clydeshaffer/gametank/media/gametank-angle-01.png

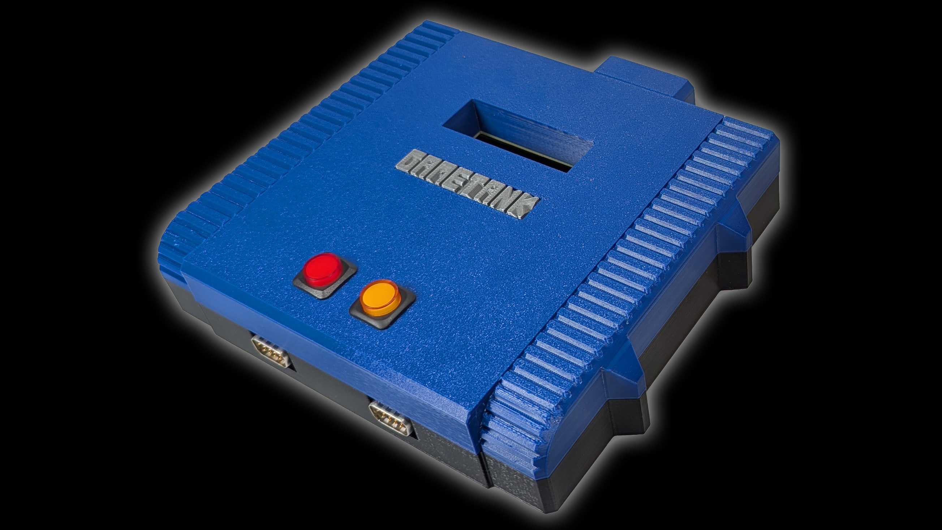
media/gametank-angle-01.png
