clydeshaffer/gametank/Docs/PackagingLabels/PackagingV2/box_left.png

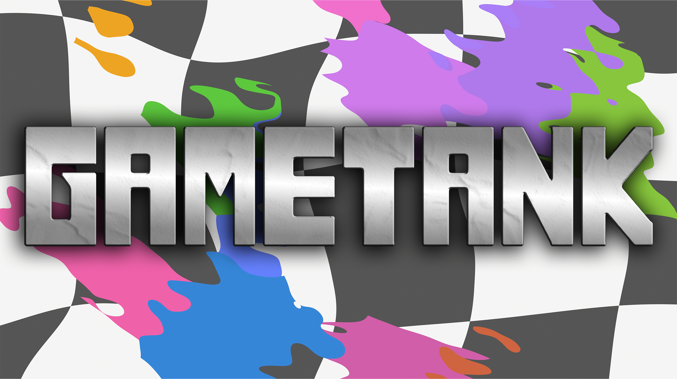
Docs/PackagingLabels/PackagingV2/box_left.png
