clydeshaffer/gametank/Docs/SchematicPDFs/readme.md

## Main System Schematics
- cpu-blitter-inputs.pdf
- signals.pdf
- powermodule-lm2575.pdf

## Controller
- gpad1.pdf

## Cartridges
- FlashCardBanked2M.pdf (bigger capacity)
- EEPROM32card.pdf (can be entirely through-hole)
- MegaProgrammer.pdf - Arduino-based USB flasher tool
