clydeshaffer/gametank/Docs/SchematicImages/README.md

### GameTank Prototype3 schematics in image form for viewing without EAGLE

- core.png - CPU, main RAM, and address decoding
- blitter.png - Sprite copying machine
- inputs.png - controller ports and input registers
- video.png - Composite video generator circuit and framebuffer RAM
- audio-coprocessor.png - second 6502 controlling a DAC
- audio-port.png - shows the names of audio connector signals on the mainboard side
- oscillator.png - main system clock
