clydeshaffer/gametank/Docs/PackagingLabels/front_back.pdf

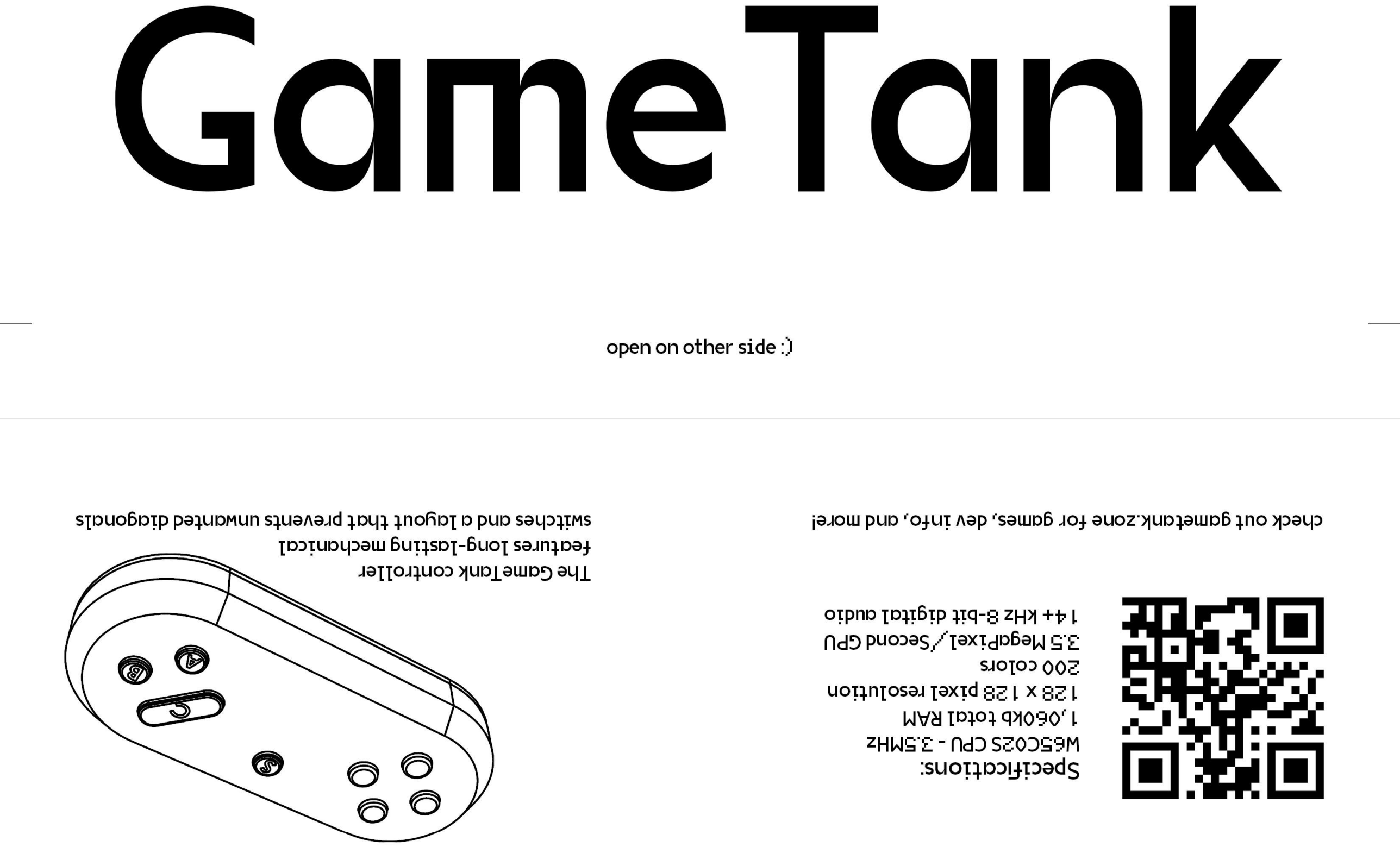
[picture p19: page 1]
