clydeshaffer/gametank/Docs/PackagingLabels/top.pdf

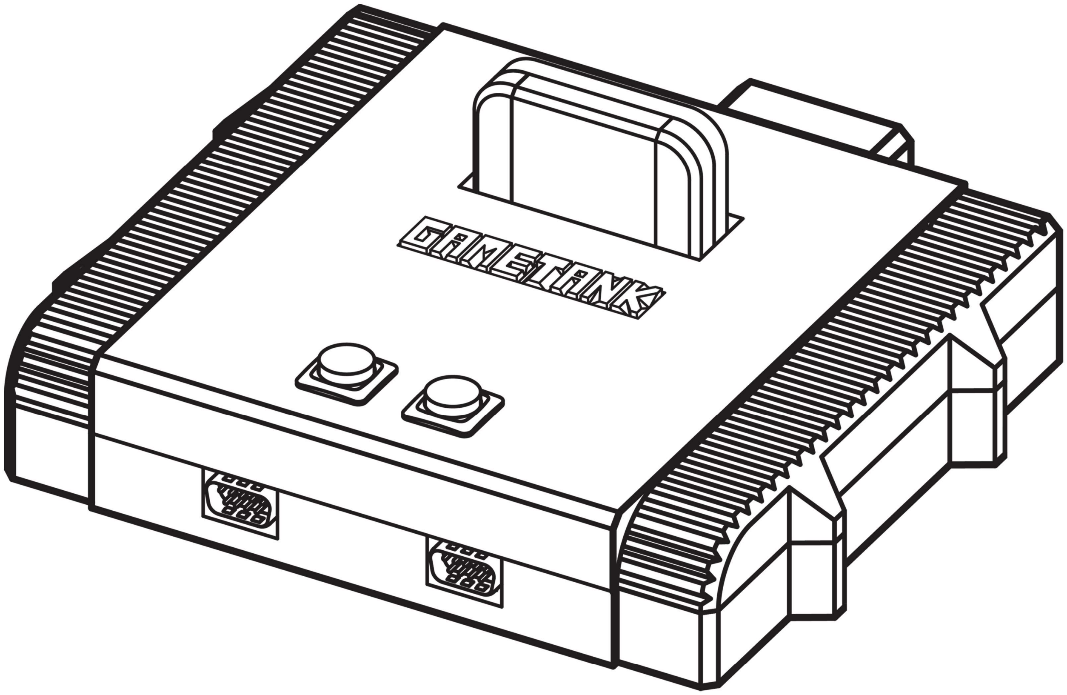
[picture p20: page 1]
