clydeshaffer/gametank/CAD/proto-v3-sketch.png

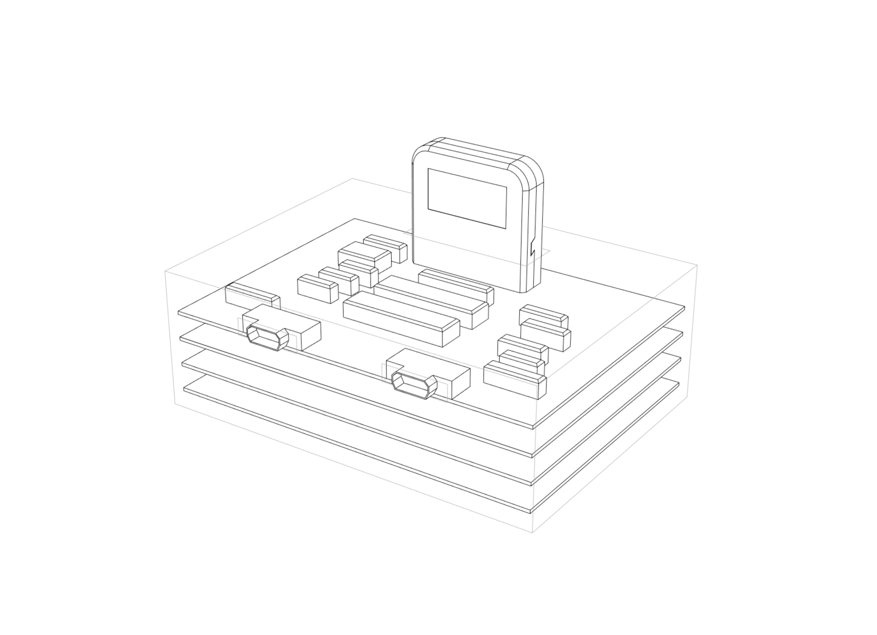
CAD/proto-v3-sketch.png
