clydeshaffer/gametank/Docs/PackagingLabels/PackagingV2/box_bottom.png

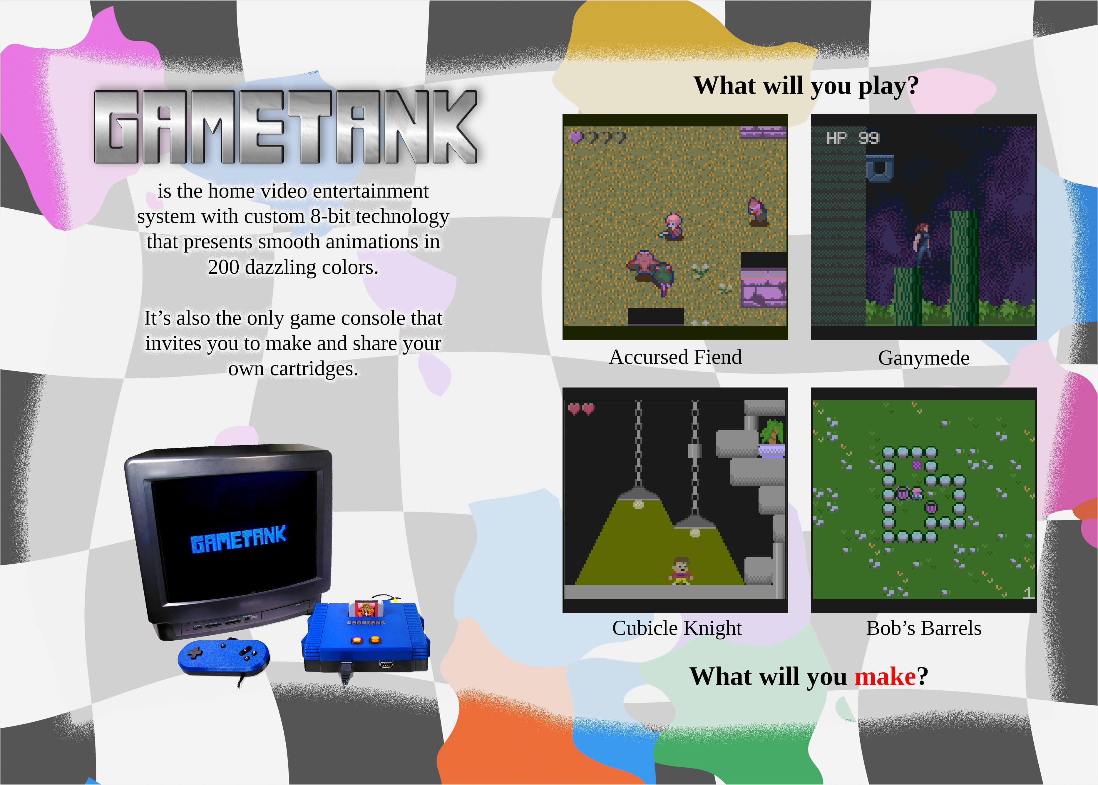
Docs/PackagingLabels/PackagingV2/box_bottom.png
