clydeshaffer/gametank/Docs/PackagingLabels/PackagingV2/box_bottom_layer.png

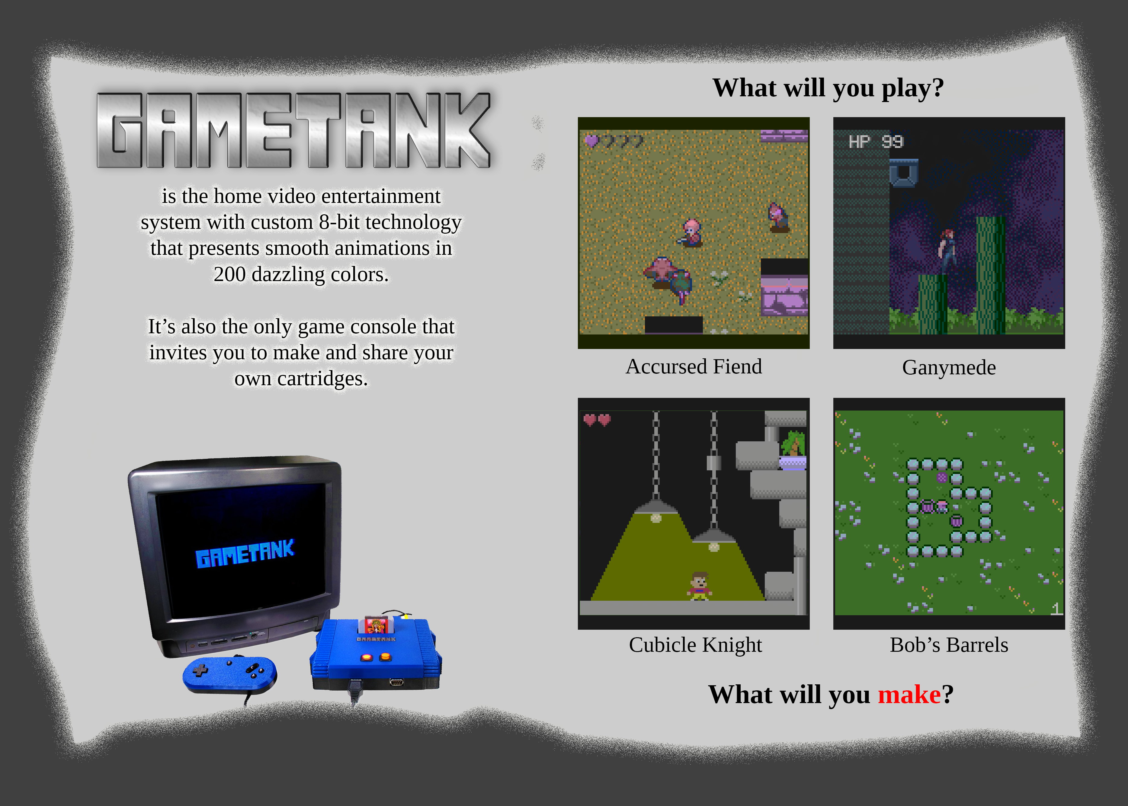
Docs/PackagingLabels/PackagingV2/box_bottom_layer.png
