clydeshaffer/gametank/Docs/PackagingLabels/PackagingV2/box_front_layer.png

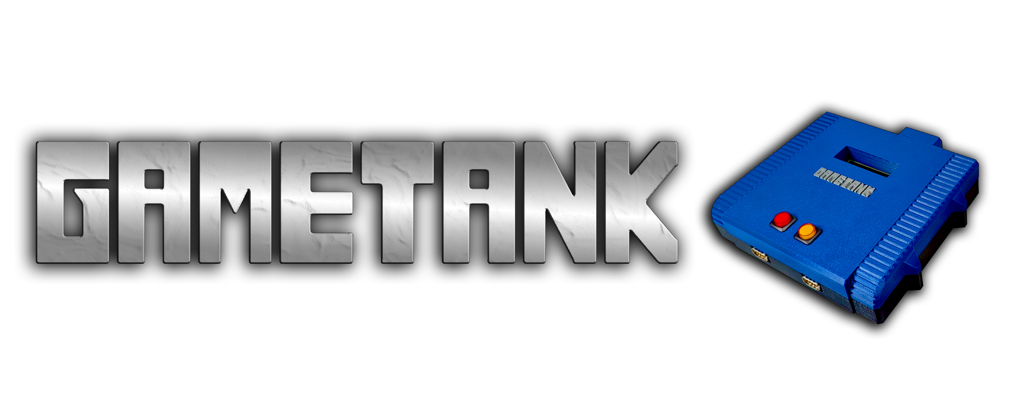
Docs/PackagingLabels/PackagingV2/box_front_layer.png
