clydeshaffer/gametank/Docs/PackagingLabels/PackagingV2/box_left_bg.png

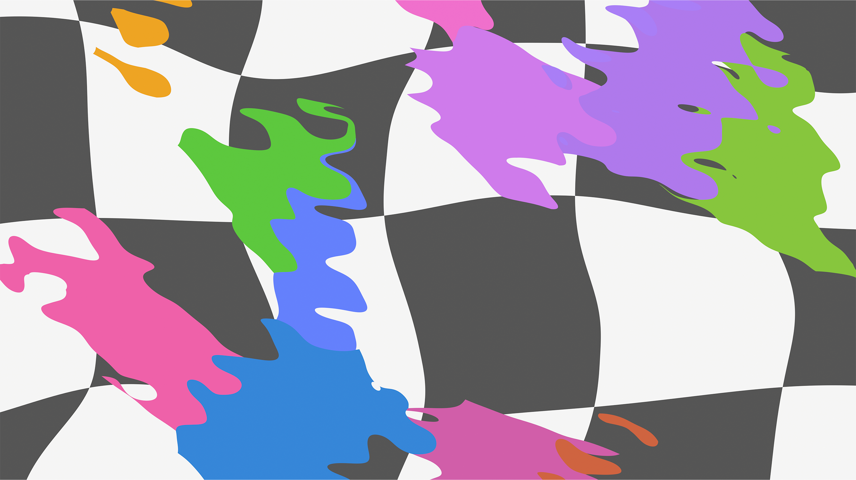
Docs/PackagingLabels/PackagingV2/box_left_bg.png
