clydeshaffer/gametank/Docs/PackagingLabels/PackagingV2/box_right.png

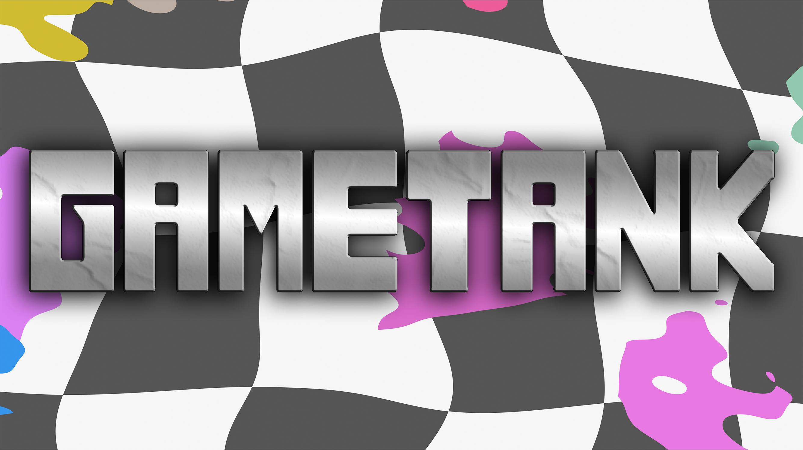
Docs/PackagingLabels/PackagingV2/box_right.png
