clydeshaffer/gametank/Docs/PackagingLabels/PackagingV2/box_right_bg.png

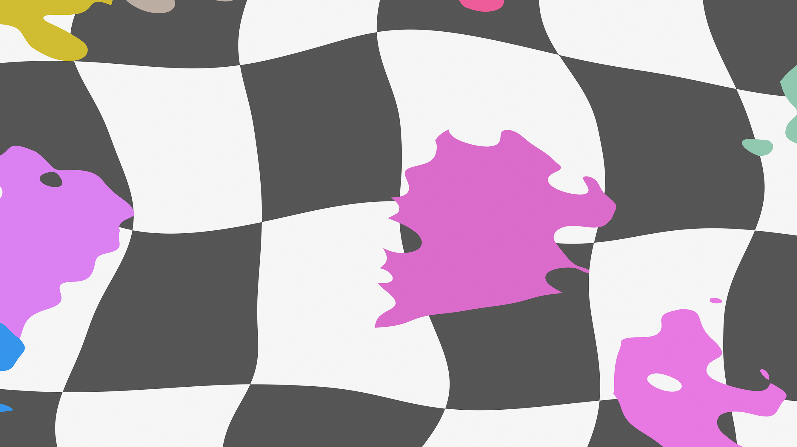
Docs/PackagingLabels/PackagingV2/box_right_bg.png
