clydeshaffer/gametank/Docs/PackagingLabels/PackagingV2/box_side_layer.png

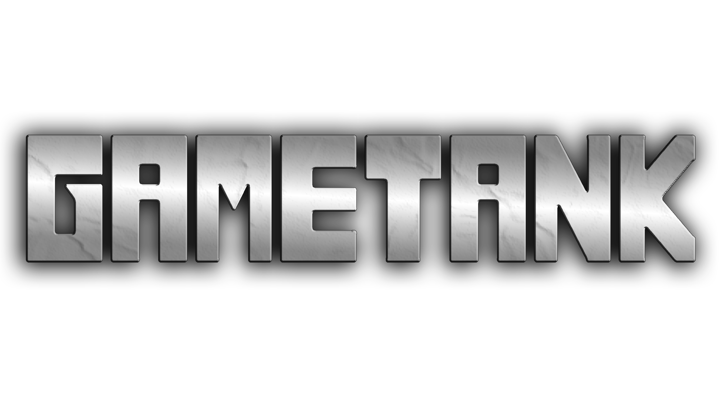
Docs/PackagingLabels/PackagingV2/box_side_layer.png
