clydeshaffer/gametank/Docs/SchematicImages/audio-coprocessor.png

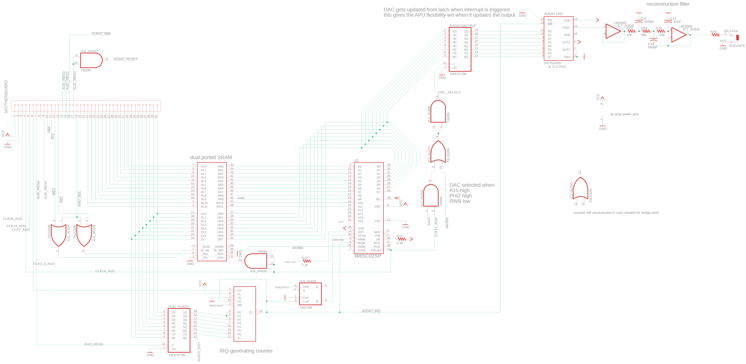
Docs/SchematicImages/audio-coprocessor.png
