clydeshaffer/gametank/Docs/SchematicImages/audioport.png

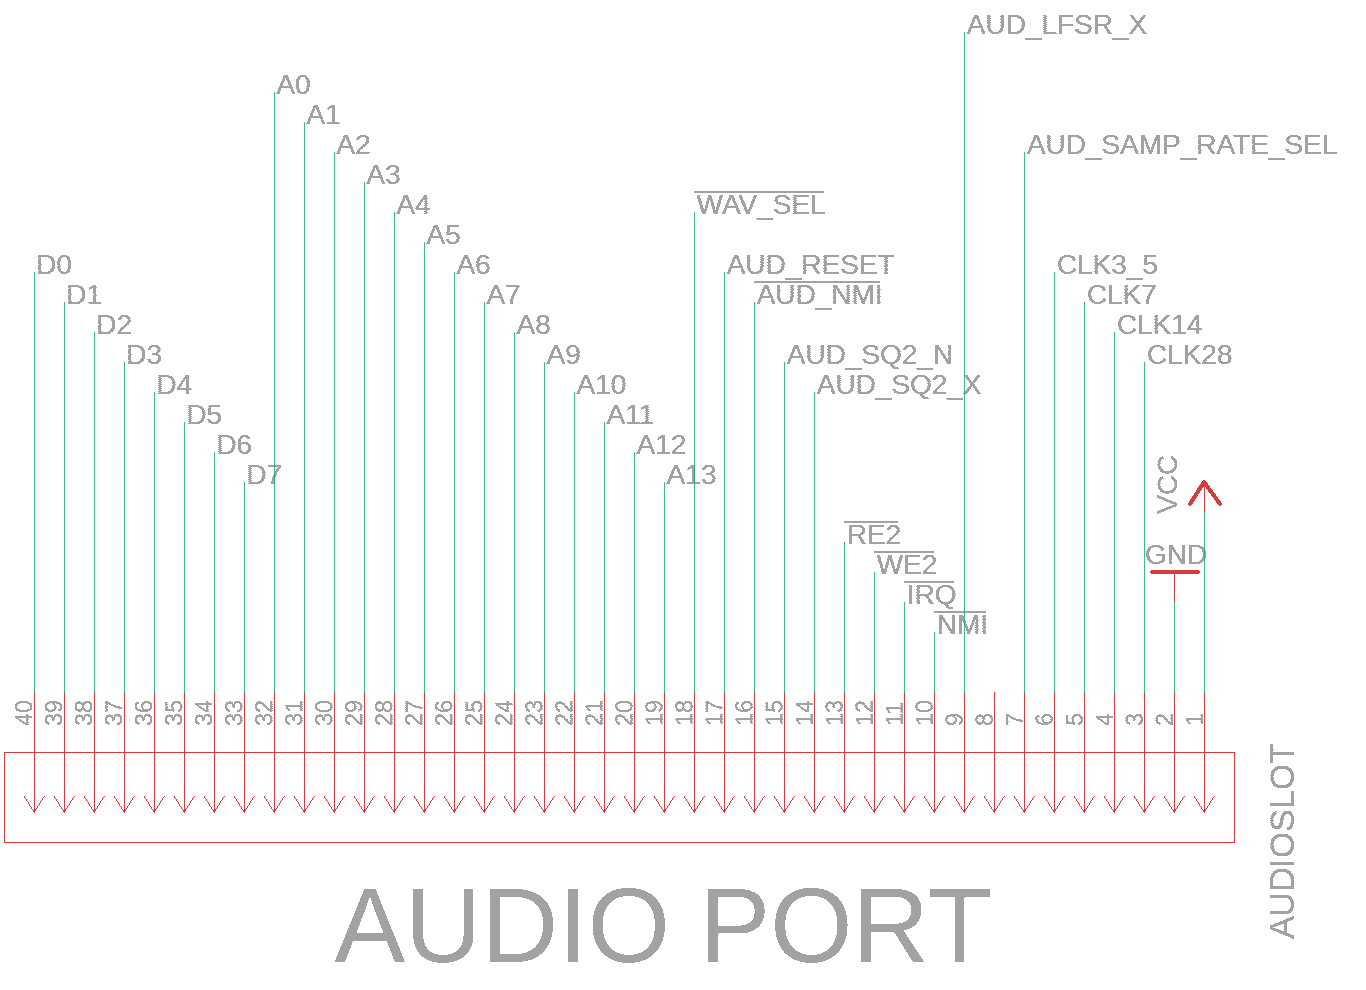
Docs/SchematicImages/audioport.png
