clydeshaffer/gametank/Docs/SchematicImages/core.png

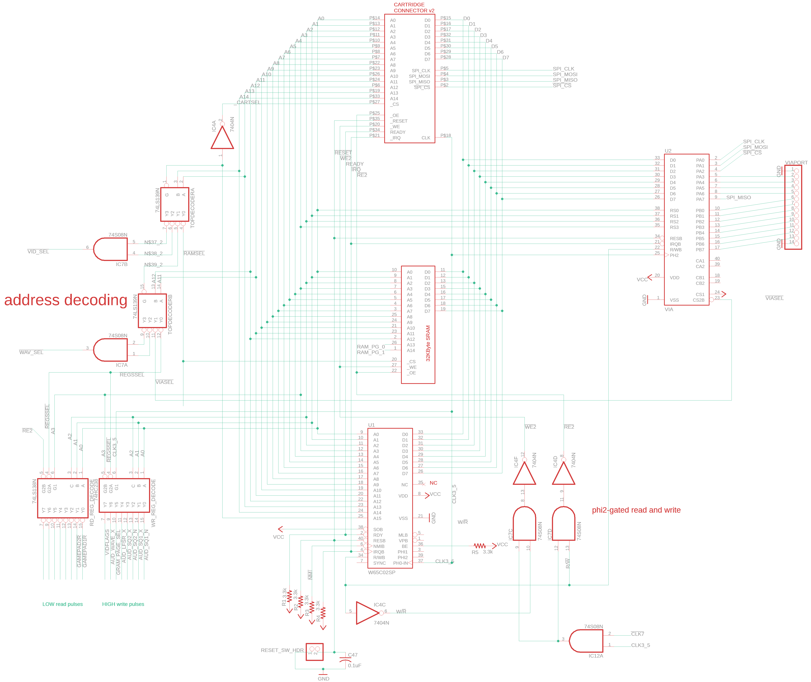
Docs/SchematicImages/core.png
