clydeshaffer/gametank/Docs/SchematicImages/inputs.png

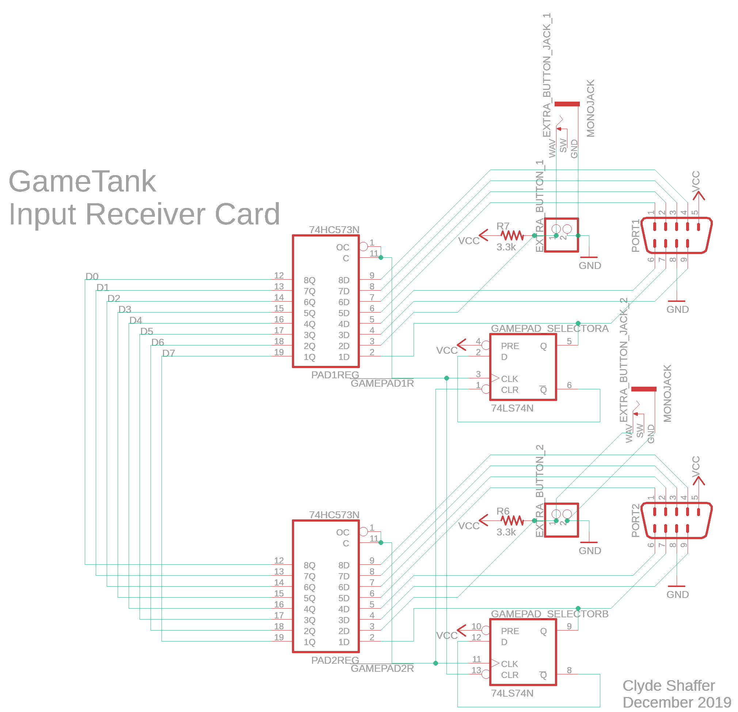
Docs/SchematicImages/inputs.png
