clydeshaffer/gametank/Docs/SchematicImages/oscillator.png

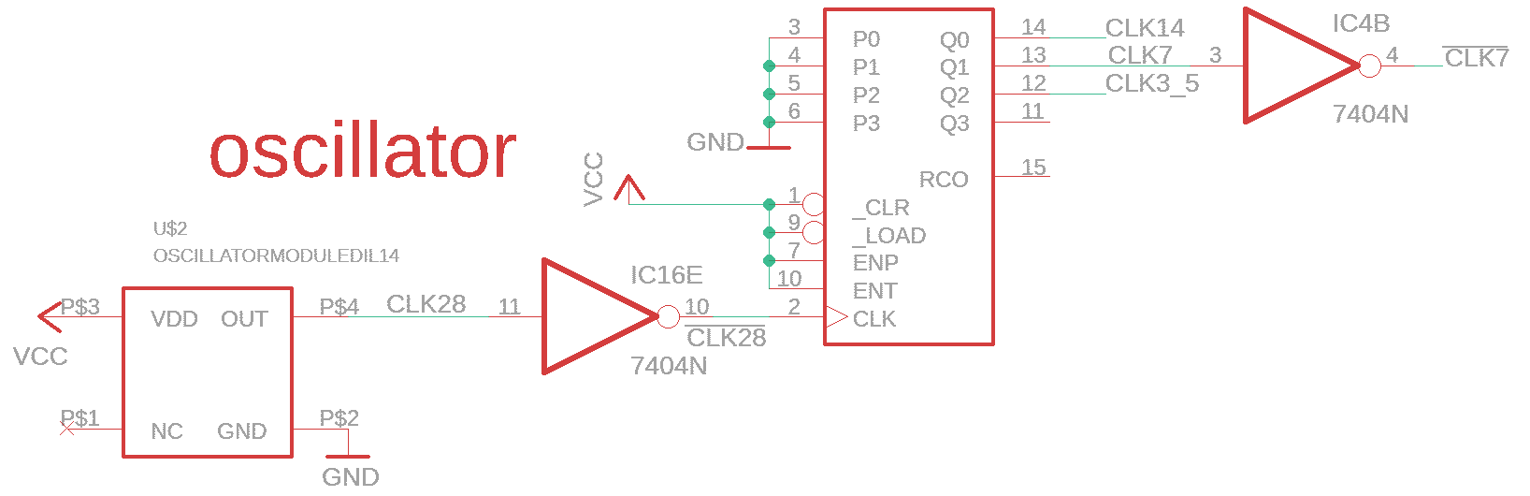
Docs/SchematicImages/oscillator.png
