clydeshaffer/gametank/Docs/SchematicImages/video.png

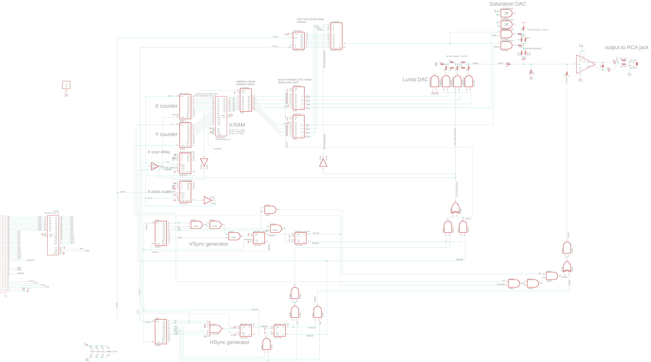
Docs/SchematicImages/video.png
