clydeshaffer/gametank/media/color_lineart.png

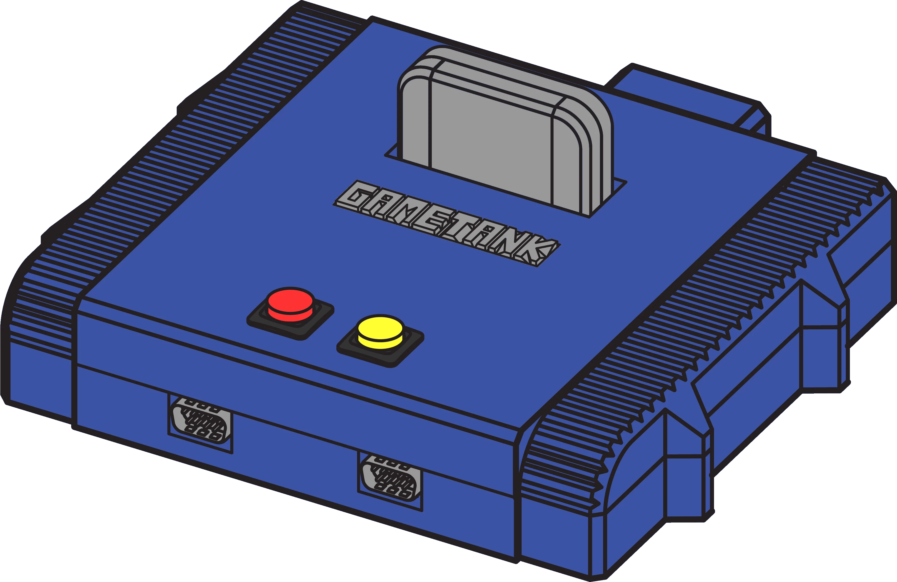
media/color_lineart.png
