clydeshaffer/gametank/media/controller-v3.png

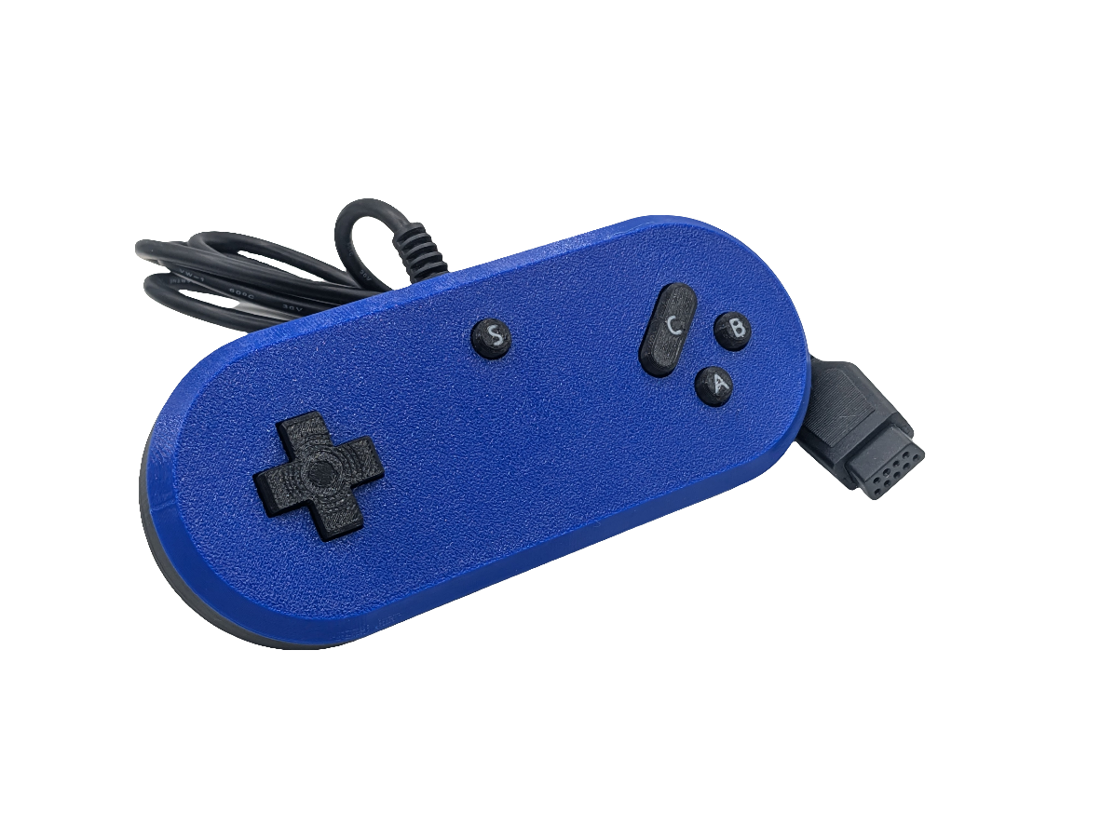
media/controller-v3.png
