clydeshaffer/gametank/media/gametank_front.png

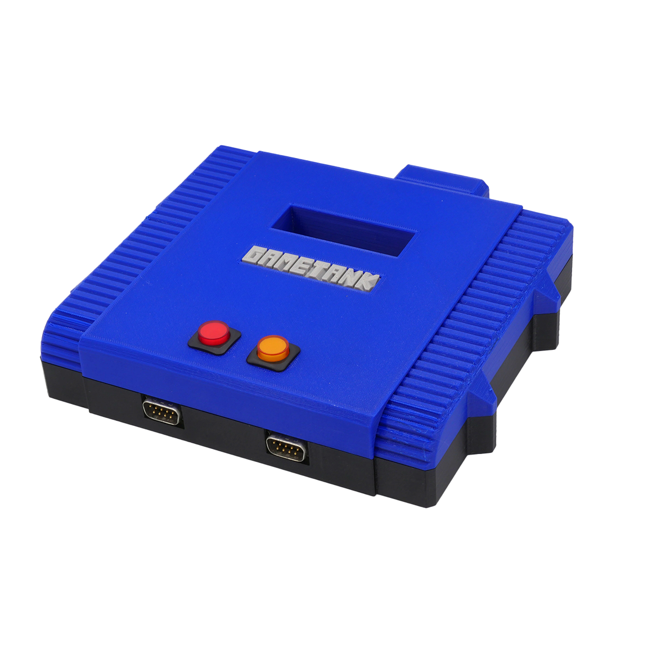
media/gametank_front.png
