clydeshaffer/gametank/Sourcing/CombinedV3/GameTank-DigiKey.xlsx

Country of Origin may be different at time of shipment.
The HTSUS and ECCN information shown is for informational purposes only and is not a representation or warranty as to the accuracy or reliability of these classifications. All information is provided "as is" and is subject to change without notice. Any use made of the information provided is without recourse to Digi-Key and at the user's risk.
Index | Manufacturer Part Number | Manufacturer Name | Description | Availability | Attrition % | Requested Quantity 1 | Pack Quantity 1 | Pack Type 1 | Digi-Key Part Number 1 | Unit Price 1 | Extended Price 1 | Minimum Order Quantity 1 | Customer Reference | Requested Part Number | Lead Weeks | Datasheet | Reference Designator | US Import Tariff | Note | Part Status | RoHS Status | ECCN | HTSUS | Country of Origin | Environmental Information | Original Part numbers | Image
1 | TX24-40R-6ST-N1E | JAE Electronics | CONN RCPT 40POS VERT GOLD | 846 In Stock |  | 2 | 2 | Tray | 670-1385-ND | 1.39000 | $2.78 | 1 |  | 670-1385-ND | 14 | //media.digikey.com/pdf/Data%20Sheets/JAE%20PDFs/Board-To-Board_PG_V2.2.pdf |  | N/A |  | Active | RoHS Compliant | EAR99 | 8536.69.4040 | Japan |  | 670-1385-ND | //media.digikey.com/photos/JAE%20Elect%20Photos/TX24-40R-6ST-N1E.JPG
2 | TX25-40P-8ST-H1E | JAE Electronics | CONN PLUG 40POS VERT GOLD | 155 In Stock |  | 2 | 2 | Tray | 670-1446-ND | 1.53000 | $3.06 | 1 |  | 670-1446-ND | 14 | //media.digikey.com/pdf/Data%20Sheets/JAE%20PDFs/Board-To-Board_PG_V2.2.pdf |  | N/A |  | Active | RoHS Compliant | EAR99 | 8536.69.4040 | Philippines |  | 670-1446-ND | //media.digikey.com/photos/JAE%20Elect%20Photos/TX25-40P-8ST-H1E.JPG
3 | LD09P13A4GX00LF | Amphenol ICC (FCI) | CONN D-SUB PLUG 9POS R/A SLDR | 2,619 In Stock |  | 2 | 2 | Tray | 609-5183-ND | 1.10000 | $2.20 | 1 |  | 609-5183-ND | 10 | https://www.amphenol-icc.com/media/wysiwyg/files/drawing/10130913.pdf |  | N/A |  | Active | RoHS Compliant | EAR99 | 8536.69.4040 | India |  | 609-5183-ND | //media.digikey.com/Photos/Amphenol%20Photos/LD09P13A4GX00LF.JPG
4 | SN74AHC8541N | Texas Instruments | IC BUFFER 5.5V 20DIP | 565 In Stock |  | 2 | 2 | Tube | 296-38386-5-ND | 1.60000 | $3.20 | 1 |  | 296-38386-5-ND | 6 | https://www.ti.com/general/docs/suppproductinfo.tsp?distId=10 |  | N/A |  | Active | ROHS3 Compliant | EAR99 | 8542.39.0001 | Malaysia |  | 296-38386-5-ND | //media.digikey.com/Photos/Texas%20Instr%20Photos/296~4040049~N~20.jpg
5 | SN74HC163N | Texas Instruments | IC 4-BIT BINARY COUNTER 16-DIP | 2,090 In Stock |  | 8 | 8 | Tube | 296-8246-5-ND | 0.62000 | $4.96 | 1 |  | 296-8246-5-ND | 6 | https://www.ti.com/general/docs/suppproductinfo.tsp?distId=10 |  | N/A |  | Active | ROHS3 Compliant | EAR99 | 8542.39.0001 | Malaysia |  | 296-8246-5-ND | //media.digikey.com/Renders/Texas%20Instr%20Renders/296~4040049~N~16.jpg
6 | CD74AC163E | Texas Instruments | IC 4-BIT SYNC BIN CNTR 16-DIP | 1,041 In Stock - Non-Stock |  | 1 | 1 | Tube | 296-4233-5-ND | 0.84000 | $0.84 | 1 |  | 296-4233-5-ND | 6 | https://www.ti.com/general/docs/suppproductinfo.tsp?distId=10 |  | N/A |  | Active | ROHS3 Compliant | EAR99 | 8542.39.0001 | Mexico |  | 296-4233-5-ND | //media.digikey.com/Renders/~~Pkg.Case%20or%20Series/DIP16_SOT38-1%20Pkg.jpg
7 | CD74HC238E | Texas Instruments | IC DECODER/DEMUX 1X3:8 16DIP | 2,123 In Stock |  | 2 | 2 | Tube | 296-25983-5-ND | 0.61000 | $1.22 | 1 |  | 296-25983-5-ND | 12 | https://www.ti.com/general/docs/suppproductinfo.tsp?distId=10 |  | N/A |  | Active | ROHS3 Compliant | EAR99 | 8542.39.0001 | Malaysia |  | 296-25983-5-ND | //media.digikey.com/Renders/~~Pkg.Case%20or%20Series/DIP16_SOT38-1%20Pkg.jpg
8 | TC74HC573APF | Toshiba Semiconductor and Storage | IC LATCH OCTAL D-TYPE 20-DIP | 653 In Stock |  | 12 | 12 | Tube | TC74HC573APF-ND | 0.52500 | $6.30 | 1 |  | TC74HC573APF-ND | 11 | https://toshiba.semicon-storage.com/info/docget.jsp?did=16446&prodName=TC74HC573AF |  | N/A |  | Active | RoHS Compliant | EAR99 | 8542.39.0001 | Japan |  | TC74HC573APF-ND | //media.digikey.com/photos/Toshiba%20Photos/TC74AC245P(F).JPG
9 | NTE74LS07 | NTE Electronics, Inc | IC BUFFER DRIVER 5.25V 14DIP | 86 In Stock |  | 1 | 1 | Bag | 2368-NTE74LS07-ND | 1.84000 | $1.84 | 1 |  | 2368-NTE74LS07-ND | 1 | https://www.nteinc.com/specs/7400to7499/pdf/nte74LS07.pdf |  | N/A |  | Active | ROHS3 Compliant | EAR99 | 8542.31.0000 | United States |  | 2368-NTE74LS07-ND | //media.digikey.com/Photos/NTE-Electronics/MFG_NTE74LS07.jpg
10 | SN74HC74N | Texas Instruments | IC FF D-TYPE DUAL 1BIT 14DIP | 0 In Stock |  | 6 | 6 | Tube | 296-1602-5-ND | 0.49000 | $2.94 | 1 |  | 296-1602-5-ND | 26 | https://www.ti.com/general/docs/suppproductinfo.tsp?distId=10 |  | N/A |  | Active | ROHS3 Compliant | EAR99 | 8542.39.0001 | Malaysia |  | 296-1602-5-ND | //media.digikey.com/Photos/Texas%20Instr%20Photos/Mfg_296~4040049~N~14.jpg
11 | SN74HC86N | Texas Instruments | IC GATE XOR 4CH 2-INP 14DIP | 8,865 In Stock |  | 2 | 2 | Tube | 296-8375-5-ND | 0.54000 | $1.08 | 1 |  | 296-8375-5-ND | 6 | https://www.ti.com/lit/ds/scls100e/scls100e.pdf |  | N/A |  | Active | ROHS3 Compliant | EAR99 | 8542.39.0001 | Mexico |  | 296-8375-5-ND | //media.digikey.com/Photos/Texas%20Instr%20Photos/Mfg_296~4040049~N~14.jpg
12 | SN74HC138N | Texas Instruments | IC DECODER/DEMUX 1X3:8 16DIP | 1,994 In Stock |  | 1 | 1 | Tube | 296-1575-5-ND | 0.54000 | $0.54 | 1 |  | 296-1575-5-ND | 35 | https://www.ti.com/lit/ds/scls107f/scls107f.pdf |  | N/A |  | Active | ROHS3 Compliant | EAR99 | 8542.39.0001 | Malaysia |  | 296-1575-5-ND | //media.digikey.com/Renders/Texas%20Instr%20Renders/296~4040049~N~16.jpg
13 | SN74HC139N | Texas Instruments | IC DECODER/DEMUX 1X2:4 16DIP | 3,046 In Stock |  | 1 | 1 | Tube | 296-8230-5-ND | 0.48000 | $0.48 | 1 |  | 296-8230-5-ND | 8 | https://www.ti.com/lit/ds/scls108d/scls108d.pdf |  | N/A |  | Active | ROHS3 Compliant | EAR99 | 8542.39.0001 | Malaysia |  | 296-8230-5-ND | //media.digikey.com/Renders/Texas%20Instr%20Renders/296~4040049~N~16.jpg
14 | SN74HC257N | Texas Instruments | IC MULTIPLEXER 4 X 2:1 16DIP | 1,933 In Stock |  | 11 | 11 | Tube | 296-8285-5-ND | 0.54900 | $6.04 | 1 |  | 296-8285-5-ND | 6 | https://www.ti.com/lit/ds/scls224b/scls224b.pdf |  | N/A |  | Active | ROHS3 Compliant | EAR99 | 8542.39.0001 | Mexico |  | 296-8285-5-ND | //media.digikey.com/Renders/Texas%20Instr%20Renders/296~4040049~N~16.jpg
15 | SN74HC08N | Texas Instruments | IC GATE AND 4CH 2-INP 14DIP | 15,541 In Stock |  | 6 | 6 | Tube | 296-1570-5-ND | 0.49000 | $2.94 | 1 |  | 296-1570-5-ND | 35 | https://www.ti.com/general/docs/suppproductinfo.tsp?distId=10 |  | N/A |  | Active | ROHS3 Compliant | EAR99 | 8542.39.0001 | Malaysia |  | 296-1570-5-ND | //media.digikey.com/Photos/Texas%20Instr%20Photos/Mfg_296~4040049~N~14.jpg
16 | CD74HC00E | Texas Instruments | IC GATE NAND 4CH 2-INP 14DIP | 1,384 In Stock |  | 8 | 8 | Tube | 296-12769-5-ND | 0.73000 | $5.84 | 1 |  | 296-12769-5-ND | 6 | https://www.ti.com/general/docs/suppproductinfo.tsp?distId=10 |  | N/A |  | Active | ROHS3 Compliant | EAR99 | 8542.39.0001 | Malaysia |  | 296-12769-5-ND | //media.digikey.com/Renders/~~Pkg.Case%20or%20Series/14PDIP.jpg
17 | CD74HC04E | Texas Instruments | IC INVERTER 6CH 6-INP 14DIP | 1,142 In Stock |  | 5 | 5 | Tube | 296-12772-5-ND | 0.68000 | $3.40 | 1 |  | 296-12772-5-ND | 6 | https://www.ti.com/general/docs/suppproductinfo.tsp?distId=10 |  | N/A |  | Active | ROHS3 Compliant | EAR99 | 8542.39.0001 | Malaysia |  | 296-12772-5-ND | //media.digikey.com/Renders/~~Pkg.Case%20or%20Series/14PDIP.jpg
18 | CD74HC30E | Texas Instruments | IC GATE NAND 1CH 8-INP 14DIP | 396 In Stock |  | 2 | 2 | Tube | 296-9196-5-ND | 0.54000 | $1.08 | 1 |  | 296-9196-5-ND | 6 | https://www.ti.com/general/docs/suppproductinfo.tsp?distId=10 |  | N/A |  | Active | ROHS3 Compliant | EAR99 | 8542.39.0001 | Malaysia |  | 296-9196-5-ND | //media.digikey.com/Renders/~~Pkg.Case%20or%20Series/14PDIP.jpg
19 | SN74HC32N | Texas Instruments | IC GATE OR 4CH 2-INP 14DIP | 0 In Stock |  | 3 | 3 | Tube | 296-1589-5-ND | 0.49000 | $1.47 | 1 |  | 296-1589-5-ND | 26 | https://www.ti.com/lit/ds/scls200e/scls200e.pdf |  | N/A |  | Active | ROHS3 Compliant | EAR99 | 8542.39.0001 | Mexico |  | 296-1589-5-ND | //media.digikey.com/Photos/Texas%20Instr%20Photos/Mfg_296~4040049~N~14.jpg
20 | SN74HC640N | Texas Instruments | IC TRANSCEIVER INVERT 6V 20DIP | 501 In Stock |  | 1 | 1 | Tube | 296-8349-5-ND | 1.68000 | $1.68 | 1 |  | 296-8349-5-ND | 6 | https://www.ti.com/lit/ds/scls303d/scls303d.pdf |  | N/A |  | Active | ROHS3 Compliant | EAR99 | 8542.39.0001 | Malaysia |  | 296-8349-5-ND | //media.digikey.com/Photos/Texas%20Instr%20Photos/296~4040049~N~20.jpg
21 | CD74HC40103E | Texas Instruments | IC 8-STAGE DOWN COUNTER 16-DIP | 483 In Stock |  | 3 | 3 | Tube | 296-9200-5-ND | 1.48000 | $4.44 | 1 |  | 296-9200-5-ND | 6 | https://www.ti.com/general/docs/suppproductinfo.tsp?distId=10 |  | N/A |  | Active | ROHS3 Compliant | EAR99 | 8542.39.0001 | Mexico |  | 296-9200-5-ND | //media.digikey.com/Renders/~~Pkg.Case%20or%20Series/DIP16_SOT38-1%20Pkg.jpg
22 | 2-5530843-7 | TE Connectivity AMP Connectors | CONN CARDEDGE FEMALE 36POS 0.100 | 921 In Stock |  | 1 | 1 | Box | 2-5530843-7-ND | 2.69000 | $2.69 | 1 |  | 2-5530843-7-ND | 13 | https://www.te.com/commerce/DocumentDelivery/DDEController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 |  | May apply on shipments to the U.S. |  | Active | RoHS Compliant | EAR99 | 8536.69.4040 | China | http://www.te.com/commerce/alt/SinglePartSearch.do?PN=2-5530843-7&dest=stmt | 2-5530843-7-ND | //media.digikey.com/Photos/TE%20Connectivity/STANDARD-636-SERIES.jpg
23 | 71256SA12TPG | Renesas Electronics America Inc | IC SRAM 256KBIT PARALLEL 28DIP | 228 In Stock |  | 2 | 2 | Tube | 800-3674-ND | 3.54000 | $7.08 | 1 |  | 800-3674-ND | 20 | https://www.renesas.com/us/en/document/dst/71256sa-datasheet |  | N/A |  | Active | ROHS3 Compliant | EAR99 | 8542.32.0041 | Thailand |  | 800-3674-ND | //media.digikey.com/Renders/~~Pkg.Case%20or%20Series/28-PDip.jpg
24 | PHT-102-01-L-S | Samtec Inc. | CONN HEADER VERT 2POS 2.54MM | 453 In Stock |  | 3 | 3 | Bulk | SAM15243-ND | 0.74000 | $2.22 | 1 |  | SAM15243-ND | 9 | http://suddendocs.samtec.com/catalog_english/pht.pdf |  | N/A |  | Active | ROHS3 Compliant | EAR99 | 8536.69.4040 | Malaysia |  | SAM15243-ND | //media.digikey.com/Photos/Samtec%20Photos/PHT-102-01-L-S.jpg
25 | C315C104M5U5TA7301 | KEMET | CAP CER 0.1UF 50V Z5U RADIAL | 4,767 In Stock |  | 97 | 97 | Cut Tape (CT) | 399-14010-1-ND | 0.09400 | $9.12 | 1 |  | 399-14010-1-ND | 32 | https://api.kemet.com/component-edge/download/datasheet/C315C104M5U5TA7301.pdf |  | N/A |  | Active | ROHS3 Compliant | EAR99 | 8532.24.0060 | Mexico |  | 399-14010-1-ND | //media.digikey.com/Photos/Kemet%20Photos/GOLDENMAX%20300%20C0G,%20NP0.jpg
26 | CFM12JT3K30 | Stackpole Electronics Inc | RES 3.3K OHM 1/2W 5% CF MINI | 18,440 In Stock |  | 11 | 11 | Cut Tape (CT) | S3.3KHCT-ND | 0.05400 | $0.59 | 1 |  | S3.3KHCT-ND | 27 | https://www.seielect.com/catalog/sei-cf_cfm.pdf |  | May apply on shipments to the U.S. |  | Active | ROHS3 Compliant | EAR99 | 8533.10.0065 | China | http://www.seielect.com/catalog/SEI-RoHS_Compliance_Status.pdf | S3.3KHCT-ND | //media.digikey.com/Renders/Stackpole%20Renders/CFM%20Series%203-3k.jpg
27 | CFM12JT150R | Stackpole Electronics Inc | RES 150 OHM 1/2W 5% CF MINI | 1,900 In Stock |  | 4 | 4 | Cut Tape (CT) | S150HCT-ND | 0.10000 | $0.40 | 1 |  | S150HCT-ND | 27 | https://www.seielect.com/catalog/sei-cf_cfm.pdf |  | May apply on shipments to the U.S. |  | Active | ROHS3 Compliant | EAR99 | 8533.10.0065 | China | http://www.seielect.com/catalog/SEI-RoHS_Compliance_Status.pdf | S150HCT-ND | //media.digikey.com/Renders/Stackpole%20Renders/CFM%20Series%20150.jpg
28 | 860020273009 | Würth Elektronik | CAP ALUM 220UF 20% 10V RADIAL | 2,312 In Stock |  | 3 | 3 | Cut Tape (CT) | 732-8911-1-ND | 0.13000 | $0.39 | 1 |  | 732-8911-1-ND | 30 | https://www.we-online.de/katalog/datasheet/860020273009.pdf |  | May apply on shipments to the U.S. |  | Active | ROHS3 Compliant | EAR99 | 8532.22.0020 | China | https://media.digikey.com/pdf/Other%20Related%20Documents/Wurth/Certificate_of_Compliance_ROHS.pdf | 732-8911-1-ND | //media.digikey.com/Photos/Wurth%20Electronics%20Photos/MFG_WCAP-ATG5.jpg
29 | SN74HC161N | Texas Instruments | IC 4-BIT BINARY COUNTER 16-DIP | 5,081 In Stock |  | 2 | 2 | Tube | 296-8244-5-ND | 0.52000 | $1.04 | 1 |  | 296-8244-5-ND | 8 | https://www.ti.com/general/docs/suppproductinfo.tsp?distId=10 |  | N/A |  | Active | ROHS3 Compliant | EAR99 | 8542.39.0001 | Mexico |  | 296-8244-5-ND | //media.digikey.com/Renders/Texas%20Instr%20Renders/296~4040049~N~16.jpg
30 | CD74HC164E | Texas Instruments | IC SHIFT REGISTER 8BIT HS 14DIP | 5,061 In Stock |  | 1 | 1 | Tube | 296-12788-5-ND | 0.76000 | $0.76 | 1 |  | 296-12788-5-ND | 6 | https://www.ti.com/general/docs/suppproductinfo.tsp?distId=10 |  | N/A |  | Active | ROHS3 Compliant | EAR99 | 8542.39.0001 | Malaysia |  | 296-12788-5-ND | //media.digikey.com/Renders/~~Pkg.Case%20or%20Series/14PDIP.jpg
31 | CD74HC564E | Texas Instruments | IC FF D-TYPE SNGL 8BIT 20DIP | 1,515 In Stock |  | 1 | 1 | Tube | 296-26009-5-ND | 0.96000 | $0.96 | 1 |  | 296-26009-5-ND | 6 | https://www.ti.com/general/docs/suppproductinfo.tsp?distId=10 |  | N/A |  | Active | ROHS3 Compliant | EAR99 | 8542.39.0001 | Malaysia |  | 296-26009-5-ND | //media.digikey.com/photos/Texas%20Instr%20Photos/296-20-DIP.jpg
32 | SN74HC151N | Texas Instruments | IC MULTIPLEXER 1 X 8:1 16DIP | 5,990 In Stock |  | 1 | 1 | Tube | 296-8236-5-ND | 0.64000 | $0.64 | 1 |  | 296-8236-5-ND | 8 | https://www.ti.com/general/docs/suppproductinfo.tsp?distId=10 |  | N/A |  | Active | ROHS3 Compliant | EAR99 | 8542.39.0001 | Malaysia |  | 296-8236-5-ND | //media.digikey.com/Renders/Texas%20Instr%20Renders/296~4040049~N~16.jpg
33 | SN74HC4040N | Texas Instruments | IC ASYNC BINARY COUNTER 16-DIP | 1,750 In Stock |  | 4 | 4 | Tube | 296-8324-5-ND | 0.64000 | $2.56 | 1 |  | 296-8324-5-ND | 6 | https://www.ti.com/lit/ds/scls160d/scls160d.pdf |  | N/A |  | Active | ROHS3 Compliant | EAR99 | 8542.39.0001 | Mexico |  | 296-8324-5-ND | //media.digikey.com/Renders/Texas%20Instr%20Renders/296~4040049~N~16.jpg
34 | TLC7524EN | Texas Instruments | IC DAC 8BIT A-OUT 16DIP | 126 In Stock |  | 1 | 1 | Tube | 296-1869-5-ND | 5.41000 | $5.41 | 1 |  | 296-1869-5-ND | 6 | https://www.ti.com/general/docs/suppproductinfo.tsp?distId=10 |  | N/A |  | Active | ROHS3 Compliant | EAR99 | 8542.39.0001 | Mexico |  | 296-1869-5-ND | //media.digikey.com/Renders/~~Pkg.Case%20or%20Series/DIP16_SOT38-1%20Pkg.jpg
35 | LM358N/NOPB | Texas Instruments | IC OPAMP GP 2 CIRCUIT 8DIP | 4,817 In Stock |  | 1 | 1 | Tube | LM358NNS/NOPB-ND | 1.10000 | $1.10 | 1 |  | LM358NNS/NOPB-ND | 35 | https://www.ti.com/general/docs/suppproductinfo.tsp?distId=10 |  | N/A |  | Active | ROHS3 Compliant | EAR99 | 8542.33.0001 | Philippines |  | LM358NNS/NOPB-ND | //media.digikey.com/Photos/Rochester/MFG_TC254P.jpg.jpg
36 | RCJ-014 | CUI Devices | CONN RCA JACK MONO 3.2MM R/A | 2,090 In Stock |  | 1 | 1 | Bag | CP-1403-ND | 0.96000 | $0.96 | 1 |  | CP-1403-ND | 12 | https://www.cuidevices.com/product/resource/digikeypdf/rcj-01x.pdf |  | N/A |  | Active | RoHS Compliant | EAR99 | 8536.69.4040 | China | https://www.cuidevices.com/product/resource/material-compliance/rcj-01-series | CP-1403-ND | //media.digikey.com/photos/CUI%20Photos/RCJ-014.jpg
37 | RCJ-013 | CUI Devices | CONN RCA JACK MONO 3.2MM R/A | 1,390 In Stock |  | 1 | 1 | Bag | CP-1402-ND | 0.96000 | $0.96 | 1 |  | CP-1402-ND | 12 | https://www.cuidevices.com/product/resource/digikeypdf/rcj-01x.pdf |  | May apply on shipments to the U.S. |  | Active | RoHS Compliant | EAR99 | 8536.69.4040 | China | https://www.cuidevices.com/product/resource/material-compliance/rcj-01-series | CP-1402-ND | //media.digikey.com/photos/CUI%20Photos/RCJ-013.jpg
38 | CFM12JT1K00 | Stackpole Electronics Inc | RES 1K OHM 1/2W 5% CF MINI | 116,141 In Stock |  | 14 | 14 | Cut Tape (CT) | S1KHCT-ND | 0.05400 | $0.76 | 1 |  | S1KHCT-ND | 27 | https://www.seielect.com/catalog/sei-cf_cfm.pdf |  | May apply on shipments to the U.S. |  | Active | ROHS3 Compliant | EAR99 | 8533.10.0065 | China | http://www.seielect.com/catalog/SEI-RoHS_Compliance_Status.pdf | S1KHCT-ND | //media.digikey.com/Renders/Stackpole%20Renders/CFM%20Series%201k.jpg
39 | CFM12JT470R | Stackpole Electronics Inc | RES 470 OHM 1/2W 5% CF MINI | 11,231 In Stock |  | 1 | 1 | Cut Tape (CT) | S470HCT-ND | 0.10000 | $0.10 | 1 |  | S470HCT-ND | 27 | https://www.seielect.com/catalog/sei-cf_cfm.pdf |  | May apply on shipments to the U.S. |  | Active | ROHS3 Compliant | EAR99 | 8533.10.0065 | China | http://www.seielect.com/catalog/SEI-RoHS_Compliance_Status.pdf | S470HCT-ND | //media.digikey.com/Renders/Stackpole%20Renders/CFM%20Series%20470.jpg
40 | MRS16000C1002FRP00 | Vishay Beyschlag/Draloric/BC Components | RES 10K OHM 0.4W 1% AXIAL | 4,492 In Stock |  | 1 | 1 | Cut Tape (CT) | BC3919CT-ND | 0.23000 | $0.23 | 1 |  | BC3919CT-ND | 11 | https://www.vishay.com/docs/28724/mrs16m25.pdf |  | N/A |  | Active | ROHS3 Compliant | EAR99 | 8533.21.0090 | Czech Republic |  | BC3919CT-ND | //media.digikey.com/Renders/Vishay%20BC%20Renders/10k-Ohm-1%25.jpg
41 | CF18JT16K0 | Stackpole Electronics Inc | RES 16K OHM 1/8W 5% AXIAL | 3,557 In Stock |  | 1 | 1 | Cut Tape (CT) | CF18JT16K0CT-ND | 0.10000 | $0.10 | 1 |  | CF18JT16K0CT-ND | 27 | https://www.seielect.com/catalog/sei-cf_cfm.pdf |  | May apply on shipments to the U.S. |  | Active | ROHS3 Compliant | EAR99 | 8533.10.0065 | China | http://www.seielect.com/catalog/SEI-RoHS_Compliance_Status.pdf | CF18JT16K0CT-ND | //media.digikey.com/Renders/Stackpole%20Renders/CF%20Series%2016k.jpg
42 | CFR-12JB-52-68K | Yageo | RES 68K OHM 1/6W 5% AXIAL | 7,149 In Stock |  | 1 | 1 | Bulk | 68KEBK-ND | 0.10000 | $0.10 | 1 |  | 68KEBK-ND | 20 | https://www.yageo.com/upload/media/product/products/datasheet/lr/Yageo_LR_CFR_1.pdf |  | N/A |  | Active | ROHS3 Compliant | EAR99 | 8533.10.0065 | Taiwan |  | 68KEBK-ND | //media.digikey.com/Renders/Yageo%20Renders/CFR-12JR-68K.jpg
43 | CC45SL3AD820JYVNA | TDK Corporation | CAP CER 82PF 1KV SL RADIAL | 1,552 In Stock |  | 1 | 1 | Cut Tape (CT) | 445-180988-1-ND | 0.34000 | $0.34 | 1 |  | 445-180988-1-ND | 10 | https://product.tdk.com/info/en/catalog/datasheets/leaddisc_commercial_cc45_en.pdf?ref_disty=digikey |  | May apply on shipments to the U.S. |  | Active | ROHS3 Compliant | EAR99 | 8532.24.0060 | China |  | 445-180988-1-ND | //media.digikey.com/photos/TDK%20Photos/MFG_LeadDiskTypeE.jpg
44 | C318C101M5R5TA | KEMET | CAP CER 100PF 20% 50V X7R RADIAL | 1,266 In Stock |  | 1 | 1 | Bulk | 399-14085-ND | 0.32000 | $0.32 | 1 |  | 399-14085-ND | 31 | https://api.kemet.com/component-edge/download/datasheet/C318C101M5R5TA.pdf |  | N/A |  | Active | ROHS3 Compliant | EAR99 | 8532.24.0060 | Mexico |  | 399-14085-ND | //media.digikey.com/Photos/Kemet%20Photos/C318.jpg
45 | C317C681K2R5TA | KEMET | CAP CER 680PF 200V X7R RADIAL | 1,068 In Stock |  | 1 | 1 | Bulk | 399-4249-ND | 0.41000 | $0.41 | 1 |  | 399-4249-ND | 28 | https://api.kemet.com/component-edge/download/datasheet/C317C681K2R5TA.pdf |  | N/A |  | Active | ROHS3 Compliant | EAR99 | 8532.24.0060 | Mexico |  | 399-4249-ND | //media.digikey.com/Photos/Kemet%20Photos/Goldmax,-300.jpg
46 | C322C821J1G5TA | KEMET | CAP CER 820PF 5% 100V C0G RADIAL | 1,433 In Stock |  | 1 | 1 | Bulk | 399-14031-ND | 0.44000 | $0.44 | 1 |  | 399-14031-ND | 25 | https://api.kemet.com/component-edge/download/datasheet/C322C821J1G5TA.pdf |  | N/A |  | Active | ROHS3 Compliant | EAR99 | 8532.24.0060 | Mexico |  | 399-14031-ND | //media.digikey.com/Photos/Kemet%20Photos/Goldmax,-300.jpg
47 | ICS-308-T | Adam Tech | IC SOCKET, DIP, 8P 2.54MM PITCH | 0 In Stock |  | 1 | 1 | Tube | 2057-ICS-308-T-ND | 0.15000 | $0.15 | 1 |  | 2057-ICS-308-T-ND | 9 | https://app.adam-tech.com/products/download/data_sheet/199582/ics-3xx-t-data-sheet.pdf |  | N/A |  | Active | ROHS3 Compliant | EAR99 | 8536.69.4040 | Taiwan |  | 2057-ICS-308-T-ND | //media.digikey.com/Photos/Adam-Tech/MFG_ICS-308-T.JPG
48 | ICS-314-T | Adam Tech | IC SOCKET, DIP, 14P 2.54MM PITCH | 2,434 In Stock |  | 34 | 34 | Tube | 2057-ICS-314-T-ND | 0.14000 | $4.76 | 1 |  | 2057-ICS-314-T-ND | 9 | https://app.adam-tech.com/products/download/data_sheet/199582/ics-3xx-t-data-sheet.pdf |  | N/A |  | Active | ROHS3 Compliant | EAR99 | 8536.69.4040 | Taiwan |  | 2057-ICS-314-T-ND | //media.digikey.com/Photos/Adam-Tech/MFG_ICS-314-T.JPG
49 | ICS-316-T | Adam Tech | IC SOCKET, DIP, 16P 2.54MM PITCH | 3,345 In Stock |  | 35 | 35 | Tube | 2057-ICS-316-T-ND | 0.14360 | $5.03 | 1 |  | 2057-ICS-316-T-ND | 9 | https://app.adam-tech.com/products/download/data_sheet/199582/ics-3xx-t-data-sheet.pdf |  | N/A |  | Active | ROHS3 Compliant | EAR99 | 8536.69.4040 | Taiwan |  | 2057-ICS-316-T-ND | //media.digikey.com/Photos/Adam-Tech/MFG_ICS-316-T.JPG
50 | ICS-320-T | Adam Tech | IC SOCKET, DIP, 20P 2.54MM PITCH | 894 In Stock |  | 16 | 16 | Tube | 2057-ICS-320-T-ND | 0.21100 | $3.38 | 1 |  | 2057-ICS-320-T-ND | 9 | https://app.adam-tech.com/products/download/data_sheet/199582/ics-3xx-t-data-sheet.pdf |  | N/A |  | Active | ROHS3 Compliant | EAR99 | 8536.69.4040 | Taiwan |  | 2057-ICS-320-T-ND | //media.digikey.com/Photos/Adam-Tech/MFG_ICS-320-T.JPG
51 | ED281DT | On Shore Technology Inc. | CONN IC DIP SOCKET 28POS TIN | 1,688 In Stock |  | 2 | 2 | Tube | ED3050-5-ND | 0.34000 | $0.68 | 1 |  | ED3050-5-ND | 14 | http://www.on-shore.com/wp-content/uploads/2015/09/ipg2.pdf |  | May apply on shipments to the U.S. |  | Active | ROHS3 Compliant | EAR99 | 8536.69.4040 | Taiwan | https://www.on-shore.com/wp-content/uploads/RoHS3_REACH-STATEMENT-205.pdf | ED3050-5-ND | //media.digikey.com/Photos/On%20Shore%20Technology%20Photos/ED281DT.JPG
