clydeshaffer/gametank/Sourcing/CombinedV3/GameTank-Mouser.xls

GAMETANK
Mouser # | Mfr. # | Manufacturer | Customer # | Description | RoHS | Lifecycle | Order Qty. | Price (USD) | Ext.: (USD)
449-LFSPXO061139BULK | LFSPXO061139Bulk | IQD Frequency Products |  | Standard Clock Oscillators 28.6363MHz 5V 50ppm -40C +85C | RoHS Compliant |  | 1 | $8.70 | $8.70
955-W65C02S6TPG-14 | W65C02S6TPG-14 | Western Design Center (WDC) |  | Microprocessors - MPU 8-bit Microprocessor | RoHS Compliant |  | 2 | $10.75 | $21.50
955-W65C22N6TPG-14 | W65C22N6TPG-14 | Western Design Center (WDC) |  | I/O Controller Interface IC Versatile Interface Adapter | RoHS Compliant |  | 1 | $10.15 | $10.15
972-7007L15JG | 7007L15JG | Renesas Electronics |  | SRAM 32K X 8K | RoHS Compliant |  | 1 | $55.46 | $55.46
972-71342LA20JG | 71342LA20JG | Renesas Electronics |  | SRAM 4K X 8 DUAL PORT SRAM | RoHS Compliant |  | 1 | $22.03 | $22.03
437-5408805224008 | 540-88-052-24-008 | Preci-dip |  | IC & Component Sockets | RoHS Compliant |  | 1 | $1.62 | $1.62
437-5408806824008 | 540-88-068-24-008 | Preci-dip |  | IC & Component Sockets | RoHS Compliant |  | 1 | $1.73 | $1.73
571-1-2199299-5 | 1-2199299-5 | TE Connectivity |  | IC & Component Sockets 40P DIP SKT 600 CL LADDER | RoHS Compliant |  | 3 | $0.79 | $2.37
575-9900015802227040 | 9900-0-15-80-22-27-04-0 | Mill-Max |  | Pin & Socket Connectors Receptacle With A Standard Tail | RoHS Compliant |  | 4 | $0.24 | $0.96
