clydeshaffer/gametank/Production/Cartridge/FlashSRAM/FlashSRAMCartBOM.xlsx

 |  |  | Nonvolatile Data Cartridge 1PCS BOM
Item # | *Designator | *Qty | Manufacturer | *Mfg Part # | Description / Value | *Package/Footprint | Type | Your Instructions / Notes
1 | IC1 | 1 | Alliance Memory | M29F160FT55N3E2 | NOR Flash , PARALLEL, 16M , TSOP 48PIN | 48-TSOP | SMD
2 | IC2 | 1 | Nexperia | MC74HC595ADTR2G | Counter Shift Registers 8-Bit 3 State Shift | 16-TSSOP | SMD
3 | IC3 | 1 | Nexperia | SN74HC244PWR | Buffers & Line Drivers Tri-State Octal | 20-TSSOP | SMD
4 | IC4, IC5 | 2 | Onsemi | MC74HC1GU04DTT1G | Inverters 2-6V Single CMOS Unbuffered | 5-TSOP | SMD
5 | IC6, IC7 | 2 | Onsemi | MC74HC1G32DTT1G | Logic Gates 2-6V Single 2-Input OR | 5-TSOP | SMD
6 | IC8 | 1 | Alliance Memory | AS6C62256-55STCN | SRAM 256K, 2.7-5.5V, 55ns 32K x 8 Asynch SRAM | 28-sTSOP | SMD
7 | C1,C2,C3,C4,C5,C6,C7,C8 | 8 | Samsung Electro-Mechanics | CL21F104ZAANNNC | Multilayer Ceramic Capacitors 100nF | 0805 | SMD
8 | R1,R2,R3 | 3 | Vishay | CRCW08053K30JNTA | Thick Film Resistors - SMD 1/8watt 3.3Kohms 5% | 0805 | SMD
9 | D1,D2,D3,D4,D5 | 5 | onsemi/Fairchild | FDLL3595 | Diodes - General Purpose, Power, Switching Hi Conductance Fast | LL-34 | SMD
10 | U$3 | 1 | Renata | CR2025 MFR SM | Coin Cell Battery HORIZONTAL SMT | CR2025 Horizontal | SMD
