clydeshaffer/gametank/Sourcing/CombinedV3/Console/mouser-kit.xls

SHOPPING CART
This is not an invoice
03-Oct-22 21:56:11
 | Mouser # | Mfr. # | Manufacturer | Customer # | Description | RoHS | Lifecycle | Order Qty. | Price (USD) | Ext.: (USD)
1 | 955-W65C02S6TPG-14 | W65C02S6TPG-14 | Western Design Center (WDC) |  | Microprocessors - MPU 8-bit Microprocessor | RoHS Compliant |  | 1 | $10.75 | $10.75
2 | 955-W65C22N6TPG-14 | W65C22N6TPG-14 | Western Design Center (WDC) |  | I/O Controller Interface IC Versatile Interface Adapter | RoHS Compliant |  | 1 | $10.15 | $10.15
3 | 437-5408805224008 | 540-88-052-24-008 | Preci-dip |  | IC & Component Sockets | RoHS Compliant |  | 1 | $2.51 | $2.51
4 | 437-5408806824008 | 540-88-068-24-008 | Preci-dip |  | IC & Component Sockets | RoHS Compliant |  | 1 | $2.67 | $2.67
5 | 571-1-2199299-5 | 1-2199299-5 | TE Connectivity |  | IC & Component Sockets 40P DIP SKT 600 CL LADDER | RoHS Compliant |  | 1 | $0.92 | $0.92
6 | 575-9900015802227040 | 9900-0-15-80-22-27-04-0 | Mill-Max |  | Pin & Socket Connectors Receptacle With A Standard Tail | RoHS Compliant |  | 4 | $0.27 | $1.08
By submitting your order you agree to these terms and conditions. (https://www.mouser.com/saleterms) |  |  |  |  |  |  |  |  | Merchandise: | $28.08
Prices are reflected at the date and time shown. |  |  |  |  |  |  |  |  | Shipping Charge: | $7.99
