clydeshaffer/gametank/Sourcing/CombinedV3/Console/mouser.xls

GAMETANK
Mouser # | Mfr. # | Manufacturer | Customer # | Description | RoHS | Lifecycle | Order Qty. | Price (USD) | Ext.: (USD)
955-W65C02S6TPG-14 | W65C02S6TPG-14 | Western Design Center (WDC) |  | Microprocessors - MPU 8-bit Microprocessor | RoHS Compliant |  | 2 | $10.75 | $21.50
955-W65C22N6TPG-14 | W65C22N6TPG-14 | Western Design Center (WDC) |  | I/O Controller Interface IC Versatile Interface Adapter | RoHS Compliant |  | 1 | $10.15 | $10.15
972-7007L15JG | 7007L15JG | Renesas Electronics |  | SRAM 32K X 8K | RoHS Compliant |  | 1 | $68.26 | $68.26
437-5408805224008 | 540-88-052-24-008 | Preci-dip |  | IC & Component Sockets | RoHS Compliant |  | 1 | $2.51 | $2.51
437-5408806824008 | 540-88-068-24-008 | Preci-dip |  | IC & Component Sockets | RoHS Compliant |  | 1 | $2.67 | $2.67
571-1-2199299-5 | 1-2199299-5 | TE Connectivity |  | IC & Component Sockets 40P DIP SKT 600 CL LADDER | RoHS Compliant |  | 3 | $0.92 | $2.76
575-9900015802227040 | 9900-0-15-80-22-27-04-0 | Mill-Max |  | Pin & Socket Connectors Receptacle With A Standard Tail | RoHS Compliant |  | 8 | $0.27 | $2.16
972-7134LA20JG | 7134LA20JG | Renesas Electronics |  | SRAM 32K(2KX16)CMOS DUAL PORT | RoHS Compliant |  | 1 | $28.57 | $28.57
449-LFSPXO022134BULK | LFSPXO022134Bulk | IQD Frequency Products |  | Standard Clock Oscillators 28.63636MHz 5V 50ppm -40C +85C | RoHS Compliant |  | 1 | $1.83 | $1.83
