clydeshaffer/gametank/CAD/3MF/console_shell/top-center.3mf

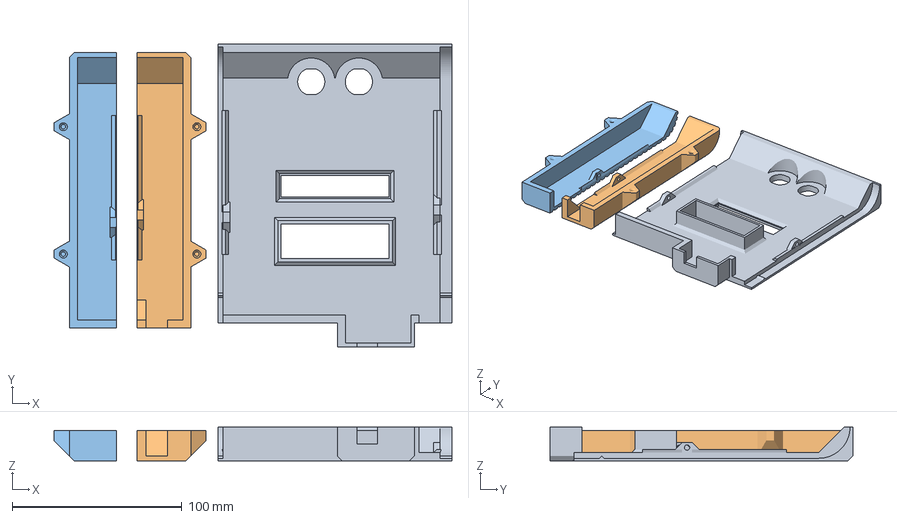
[picture p38: CAD file, 2025-01-20]
CAD/3MF/console_shell/top-center.3mf
234.5 x 178.4 x 20.0 mm
top-center.stl
tread-left.stl
tread-right.stl
