clydeshaffer/gametank/CAD/3MF/controller/controllerX4.3mf

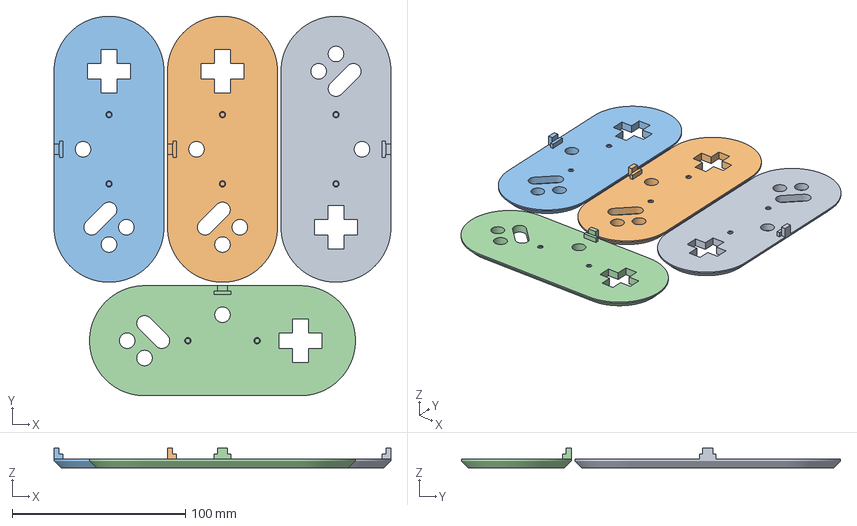
[picture p39: CAD file, 2025-01-20]
CAD/3MF/controller/controllerX4.3mf
194.5 x 219.0 x 11.4 mm
top plate.stl x 4
