clydeshaffer/gametank/CAD/STEPs/romcard2 v13.step

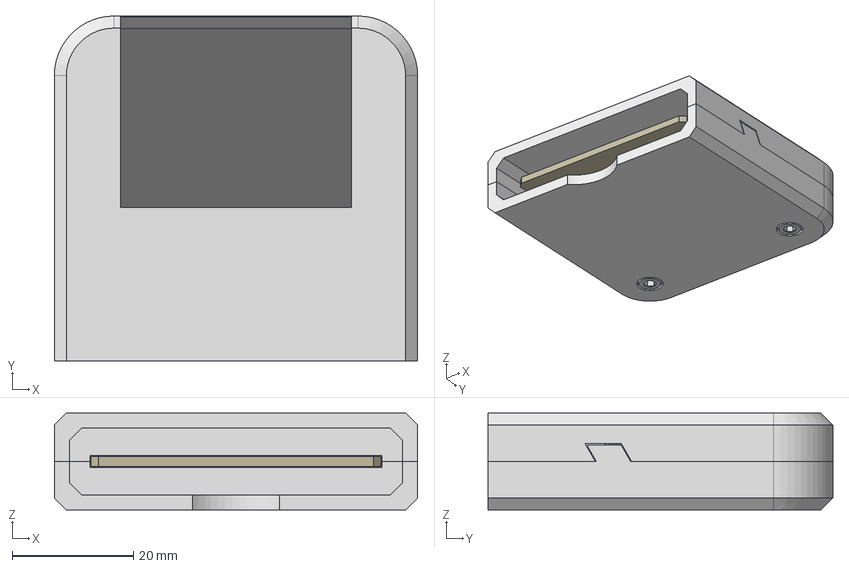
[picture p40: CAD file, 2022-07-22]
CAD/STEPs/romcard2 v13.step
60.0 x 57.0 x 16.0 mm
Board
User Library-DIP28 Wide_K_X_F6rper DIP28 Wide_1
User Library-DIP28 Wide_Pins Wide_1 x 28
90751A110 x 2
