clydeshaffer/gametank/CAD/STLs/cartridge/cartridge-back.stl

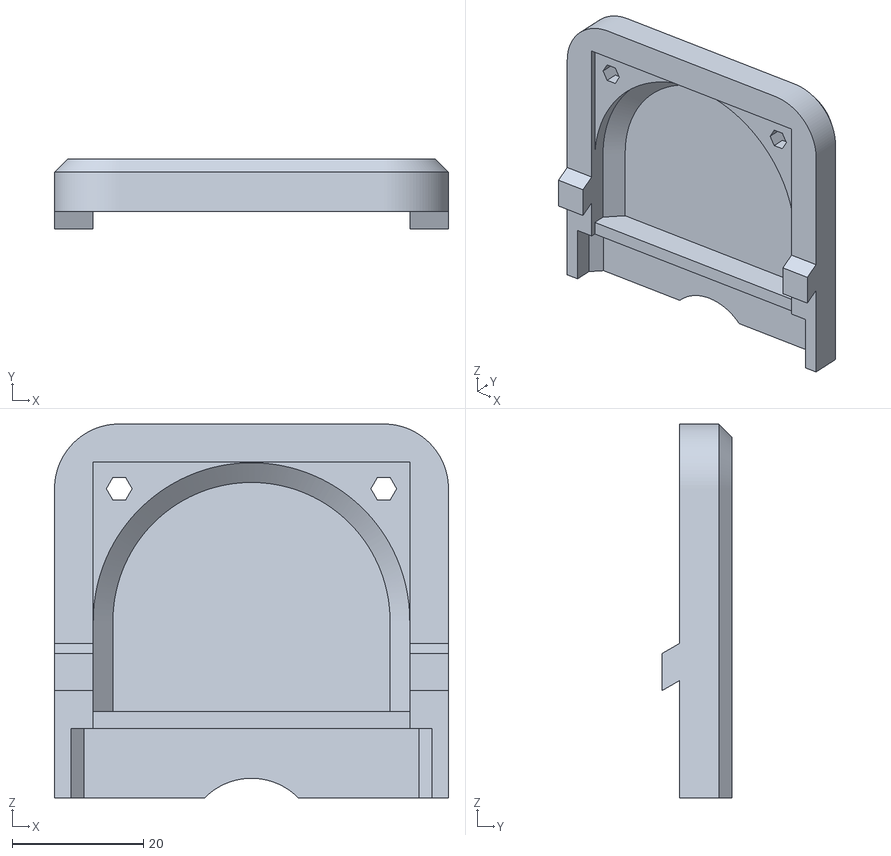
[picture p41: CAD file, 2026-03-05]
CAD/STLs/cartridge/cartridge-back.stl
60.0 x 10.7 x 57.0
