clydeshaffer/gametank/CAD/STLs/cartridge/molded/cart_molded_back.stl

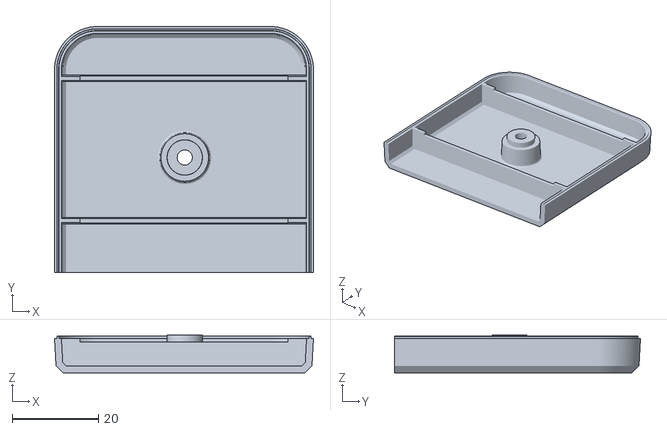
[picture p42: CAD file, 2026-03-05]
CAD/STLs/cartridge/molded/cart_molded_back.stl
60.0 x 57.0 x 8.75
