clydeshaffer/gametank/CAD/STLs/console/v1-tht/gametank-case-top.stl

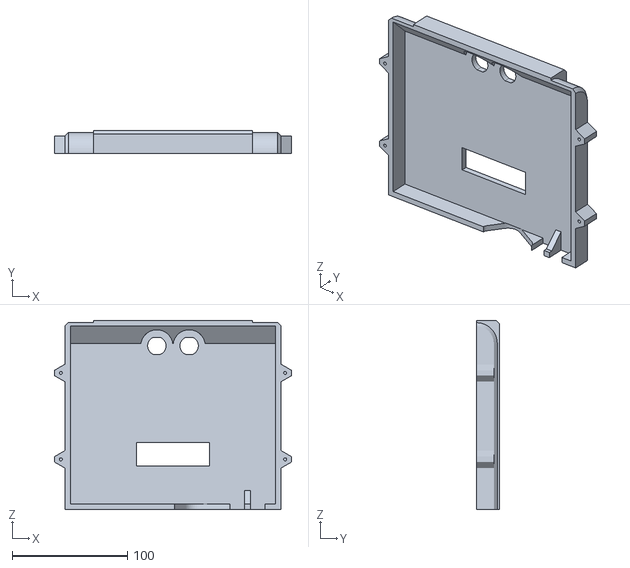
[picture p43: CAD file, 2022-07-22]
CAD/STLs/console/v1-tht/gametank-case-top.stl
205.8 x 20.0 x 164.4
