clydeshaffer/gametank/CAD/STLs/controller/v1-arms/button.stl

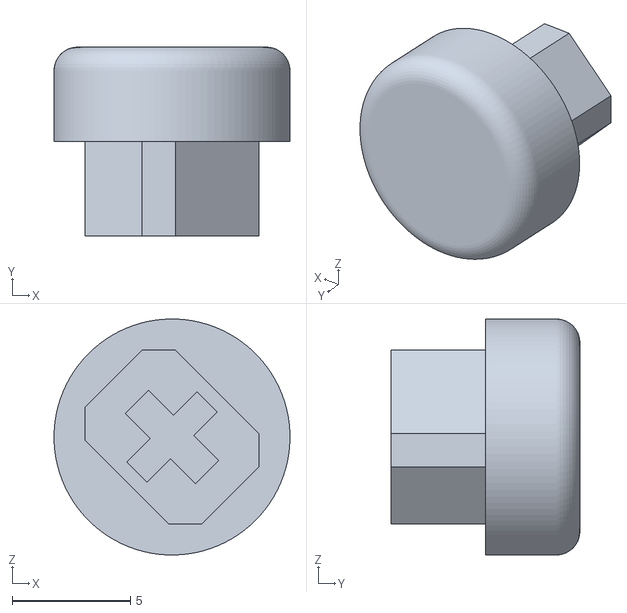
[picture p44: CAD file, 2022-11-03]
CAD/STLs/controller/v1-arms/button.stl
10.00 x 8.00 x 10.00
