clydeshaffer/gametank/CAD/STLs/controller/v2-armless/buttons/AssemblyTools/ButtonBushingJig/button-jig-top.stl

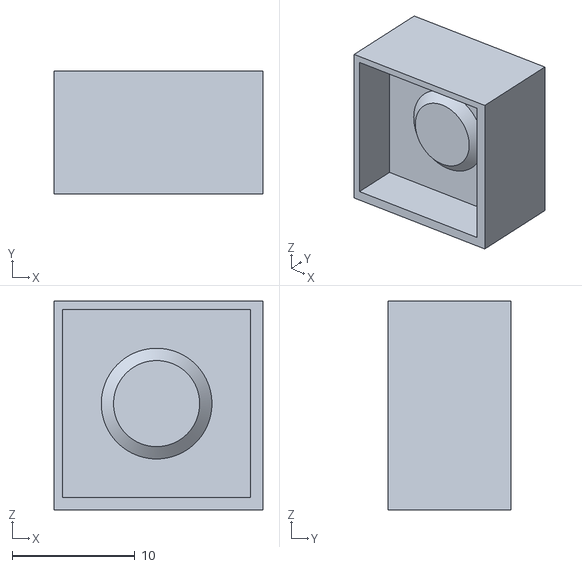
[picture p45: CAD file, 2024-08-06]
CAD/STLs/controller/v2-armless/buttons/AssemblyTools/ButtonBushingJig/button-jig-top.stl
17.0 x 10.0 x 17.0
