clydeshaffer/gametank/CAD/STLs/controller/v2-armless/buttons/cap_C.stl

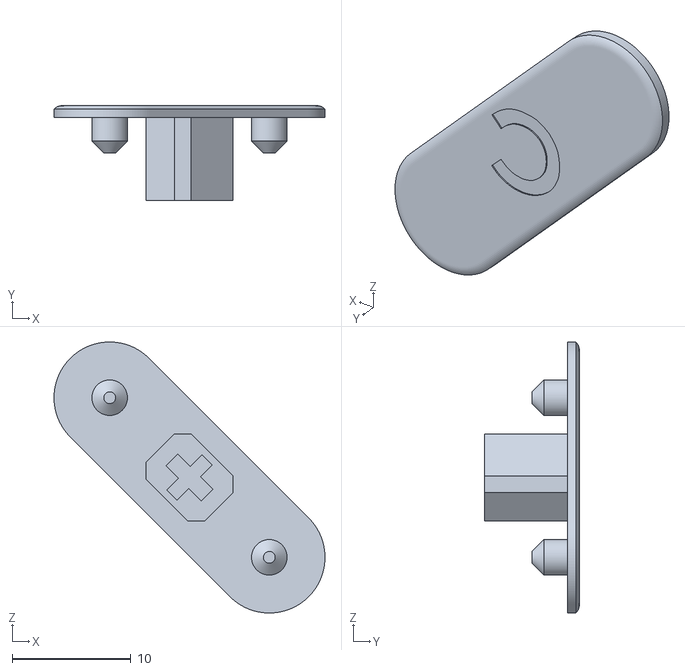
[picture p46: CAD file, 2024-08-06]
CAD/STLs/controller/v2-armless/buttons/cap_C.stl
22.9 x 8.00 x 22.9
