clydeshaffer/gametank/CAD/STLs/controller/v2-armless/shell_top3.stl

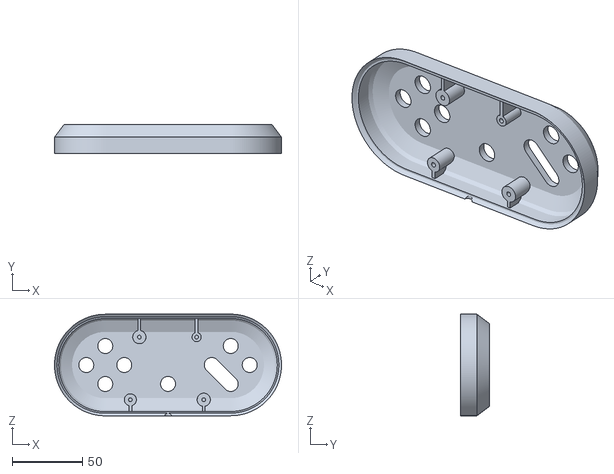
[picture p47: CAD file, 2024-08-06]
CAD/STLs/controller/v2-armless/shell_top3.stl
161.0 x 20.6 x 72.1
