clydeshaffer/gametank/CAD/STLs/controller/v3-smt/spacer.stl

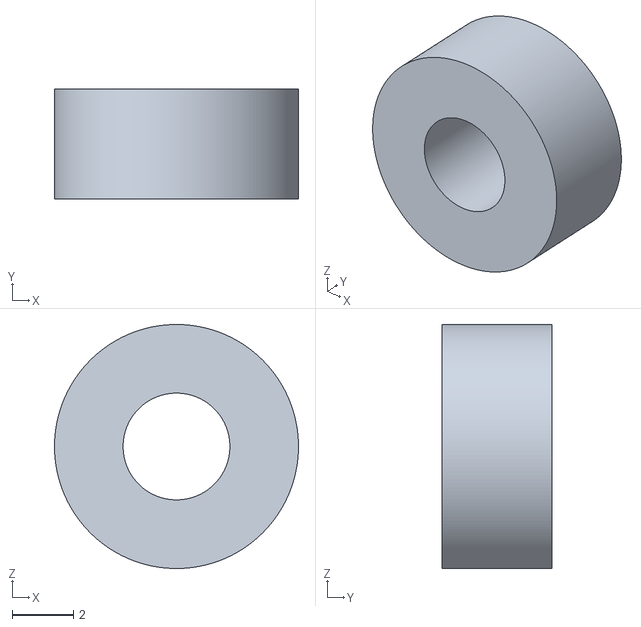
[picture p48: CAD file, 2025-01-20]
CAD/STLs/controller/v3-smt/spacer.stl
8.00 x 3.60 x 8.00
