clydeshaffer/gametank/CAD/STLs/flasher/flasher-base.stl

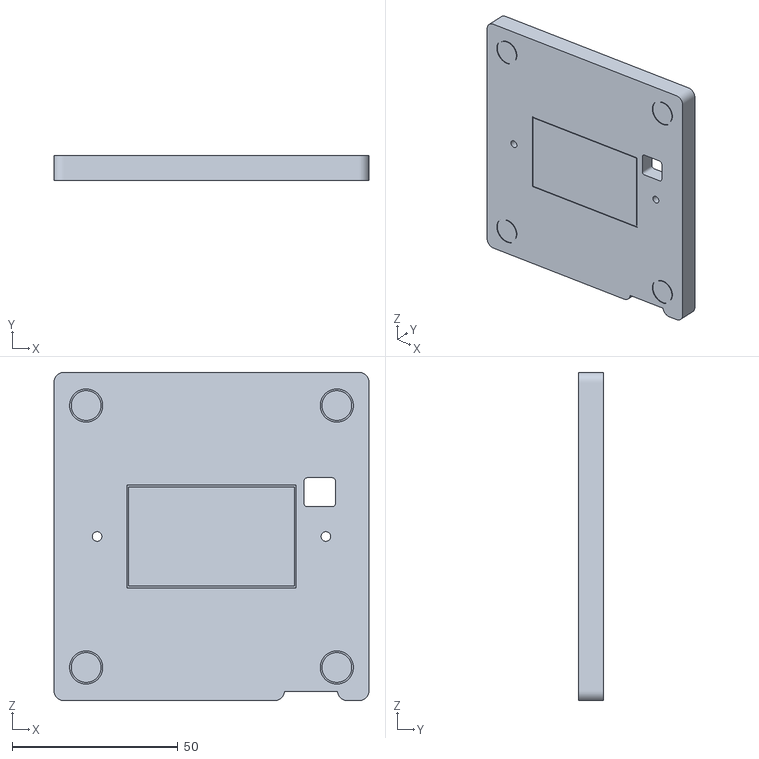
[picture p49: CAD file, 2026-09-29]
CAD/STLs/flasher/flasher-base.stl
95.0 x 7.60 x 99.0
