clydeshaffer/gametank/CAD/STLs/misc/exbus_backplane/backplane_baseplate.stl

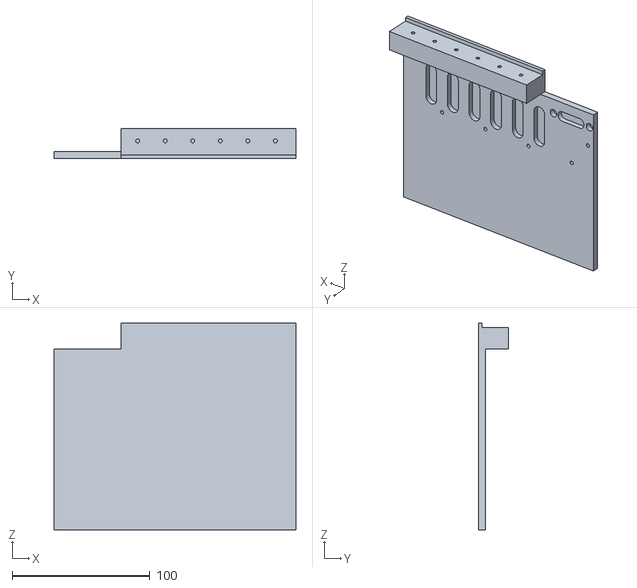
[picture p50: CAD file, 2026-09-29]
CAD/STLs/misc/exbus_backplane/backplane_baseplate.stl
175.7 x 21.8 x 150.0
