clydeshaffer/gametank/Docs/PackagingLabels/PackagingV2/foam/layer-console.dxf

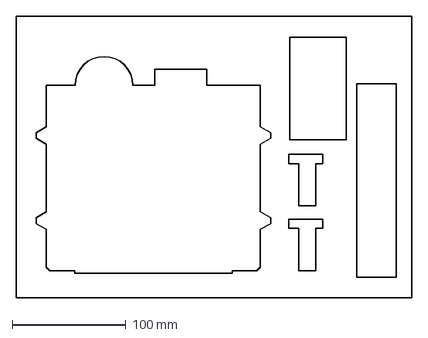
[picture p51: CAD file, 2026-07-06]
Docs/PackagingLabels/PackagingV2/foam/layer-console.dxf
348.0 x 248.0 mm
