clydeshaffer/gametank/Hardware/KiCad/Cartridges/Flash2M/FlashCardBanked2M.step

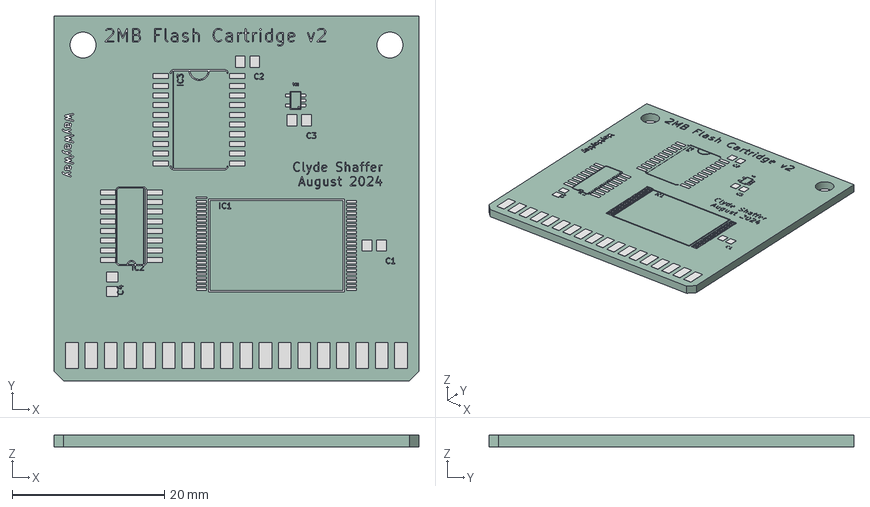
[picture p52: CAD file, 2025-10-03]
Hardware/KiCad/Cartridges/Flash2M/FlashCardBanked2M.step
47.9 x 47.9 x 1.66 mm
FlashCardBanked2M_pad
FlashCardBanked2M_silkscreen
FlashCardBanked2M_PCB
