clydeshaffer/gametank/Hardware/KiCad/Cartridges/Flash2M_center_hole/FlashCardBanked2M_hole.step

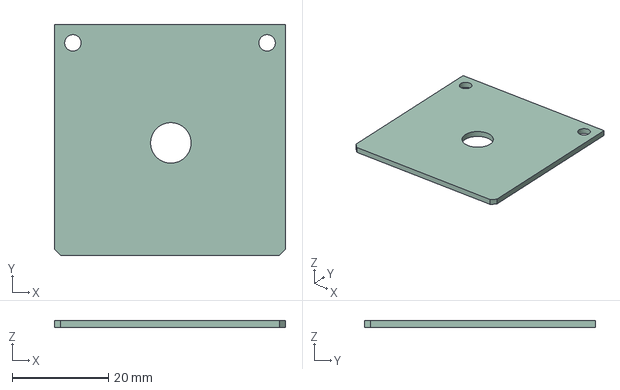
[picture p53: CAD file, 2026-02-22]
Hardware/KiCad/Cartridges/Flash2M_center_hole/FlashCardBanked2M_hole.step
47.9 x 47.9 x 1.51 mm
