clydeshaffer/gametank/Hardware/KiCad/Cartridges/Flash2M_center_hole/pcbway_production/2026-05-08-18-10-13/cartridge-front.stl

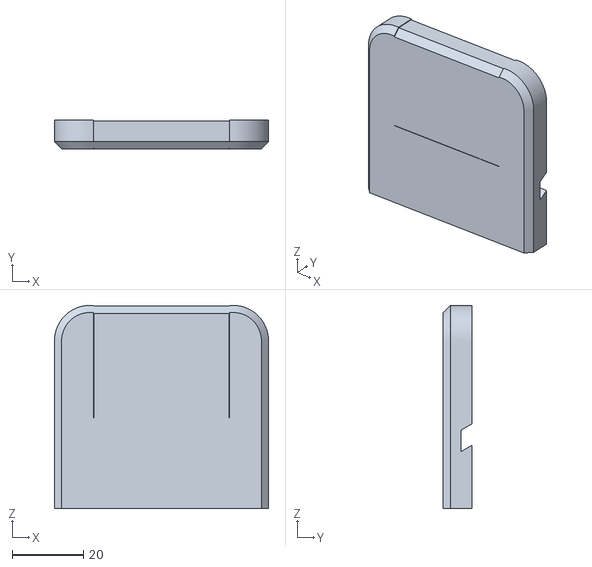
[picture p54: CAD file, 2026-03-05]
Hardware/KiCad/Cartridges/Flash2M_center_hole/pcbway_production/2026-05-08-18-10-13/cartridge-front.stl
60.0 x 8.00 x 57.0
