clydeshaffer/gametank/Hardware/KiCad/Controller/controller_v3/gpad3smt.step

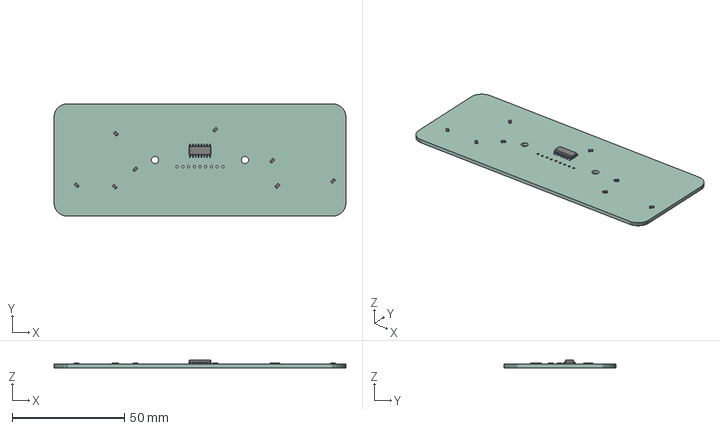
[picture p55: CAD file, 2024-09-06]
Hardware/KiCad/Controller/controller_v3/gpad3smt.step
130.0 x 50.0 x 3.40 mm
_autosave-gpad1 PCB
