clydeshaffer/gametank/Hardware/KiCad/LogicBoard_smt_altpower/LogicBoard_smt.step

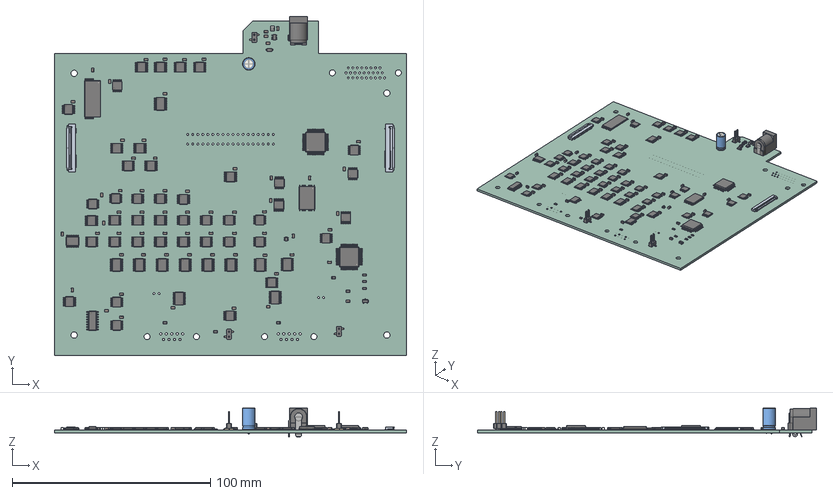
[picture p56: CAD file, 2026-08-13]
Hardware/KiCad/LogicBoard_smt_altpower/LogicBoard_smt.step
177.8 x 171.1 x 14.6 mm
TSSOP-16_4.4x5mm_P0.65mm x 22
F34G-1A7Q1-E8C40 x 2
C_0805_2012Metric x 65
R_0805_2012Metric x 8
PQFP-44_10x10mm_P0.8mm x 2
TSSOP-14_4.4x5mm_P0.65mm x 21
BarrelJack_GCT_DCJ200-10-A_Horizontal
TSSOP-20_4.4x6.5mm_P0.65mm x 12
TSOP-I-28_11.8x8mm_P0.55mm
SOT-363_SC-70-6
SOIC-16_3.9x9.9mm_P1.27mm
L_1008_2520Metric
PinHeader_1x02_P2.54mm_Vertical_SMD_Pin1Right x 3
TSOP-I-32_18.4x8mm_P0.5mm
SOT-23
D_SOD-123F
TSOT-23-6
C_Radial_D6.3mm_H11.0mm_P2.50mm
LogicBoard_smt_PCB
