clydeshaffer/gametank/Hardware/KiCad/tools/exbus_backplane/exbus_backplane.step

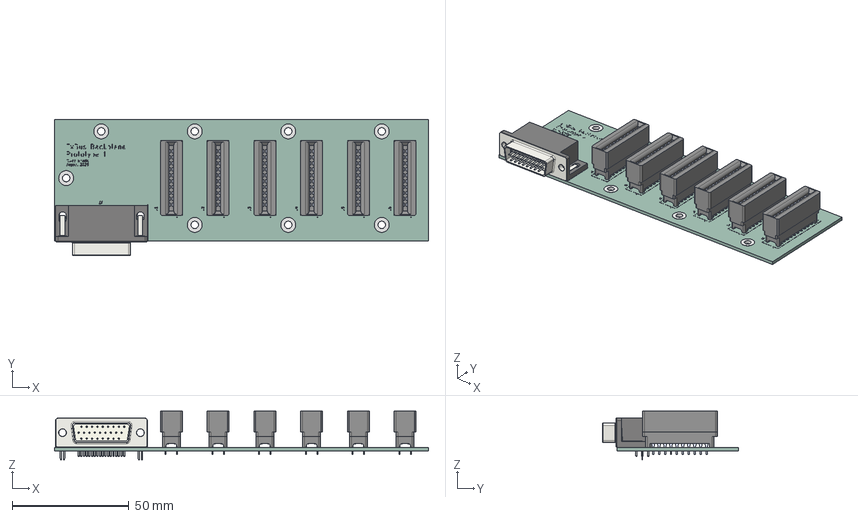
[picture p57: CAD file, 2026-08-14]
Hardware/KiCad/tools/exbus_backplane/exbus_backplane.step
160.0 x 58.0 x 20.9 mm
DSUB-26-HD_Pins_Horizontal_P2.29x2.54mm_EdgePinOffset8.35mm_Housed_ MountingHolesOffset10.89mm
exbus_backplane_pad
exbus_backplane_silkscreen
exbus_backplane_PCB
