clydeshaffer/gametank/Hardware/KiCad/tools/exp_port_leds/expo_port_leds_shell.stl

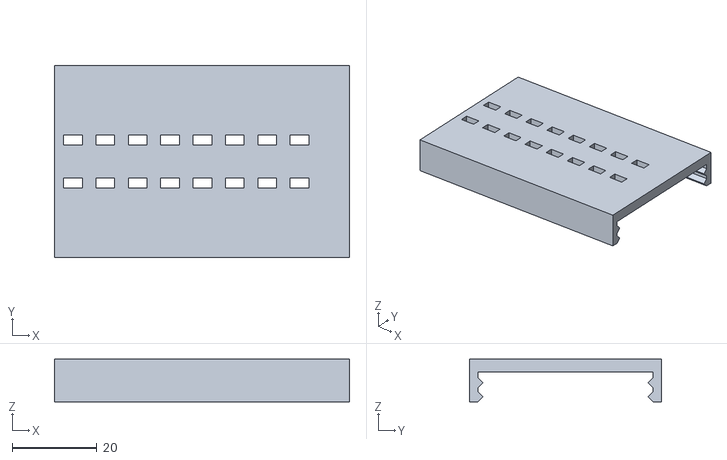
[picture p58: CAD file, 2026-03-05]
Hardware/KiCad/tools/exp_port_leds/expo_port_leds_shell.stl
69.4 x 45.2 x 10.1
