clydeshaffer/gametank/Production/quote_pkg/gametank-quote-package-v7-console-controllers-RCA-change/STLs-V7/Console/gametank-enclosure-top.stl

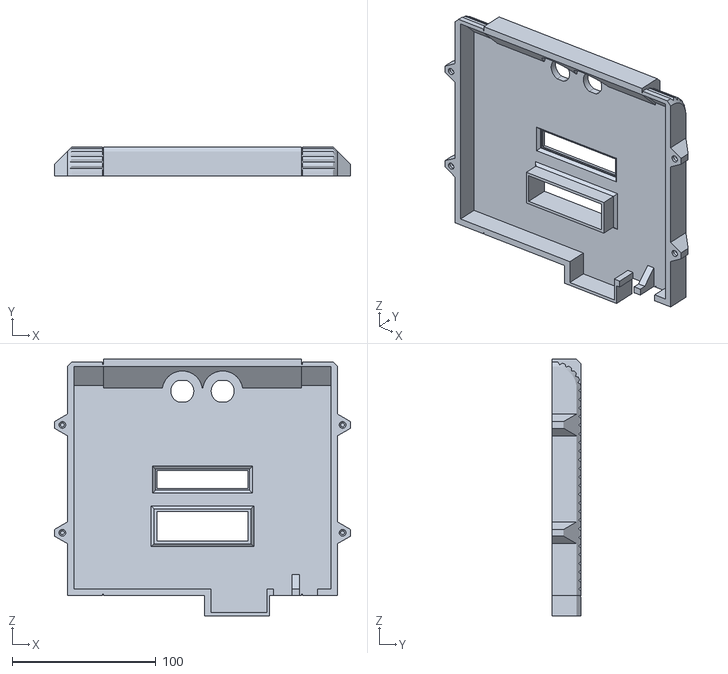
[picture p59: CAD file, 2026-08-13]
Production/quote_pkg/gametank-quote-package-v7-console-controllers-RCA-change/STLs-V7/Console/gametank-enclosure-top.stl
205.8 x 20.0 x 178.4
