clydeshaffer/gametank/Production/quote_pkg/gametank-quote-package-v7-console-controllers-RCA-change/STLs-V7/Controller/gametank-controller-body.stl

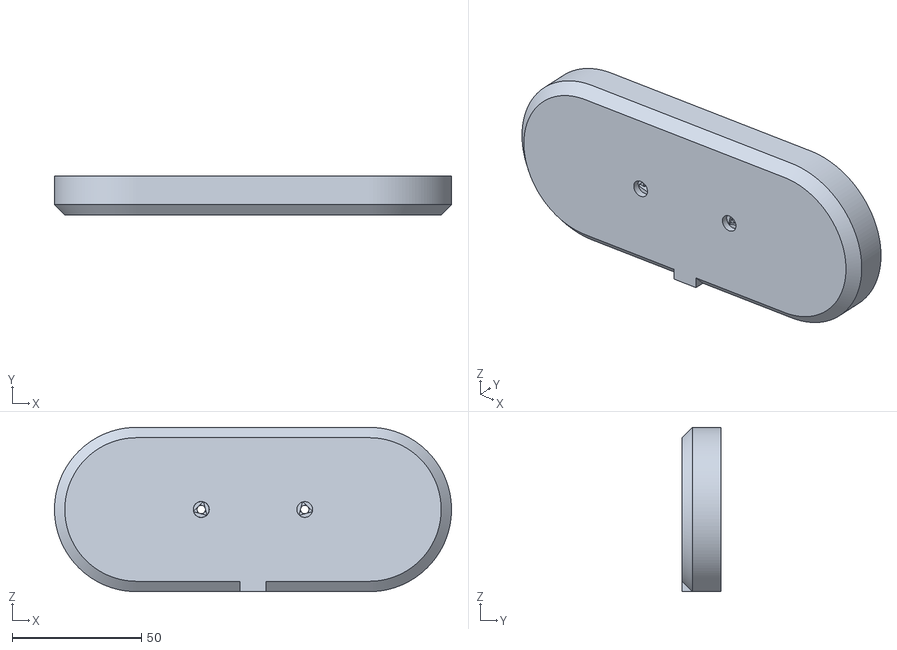
[picture p60: CAD file, 2025-10-03]
Production/quote_pkg/gametank-quote-package-v7-console-controllers-RCA-change/STLs-V7/Controller/gametank-controller-body.stl
153.5 x 15.2 x 63.5
