clydeshaffer/gametank/Production/quote_pkg/gametank-quote-package-v8-console-controllers-add-resistors/STLs-V8/Console/gametank-enclosure-bottom.stl

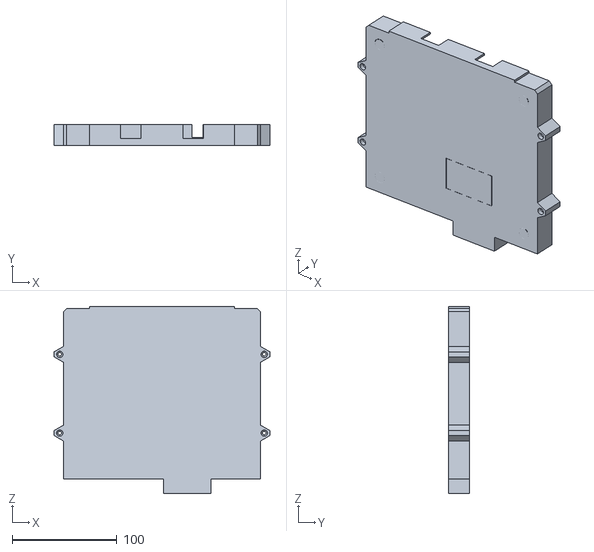
[picture p61: CAD file, 2026-08-13]
Production/quote_pkg/gametank-quote-package-v8-console-controllers-add-resistors/STLs-V8/Console/gametank-enclosure-bottom.stl
205.8 x 20.3 x 178.4
