clydeshaffer/gametank/Production/quote_pkg/gametank-quote-package-v8-console-controllers-add-resistors/STLs-V8/Controller/gametank-controller-faceplate.stl

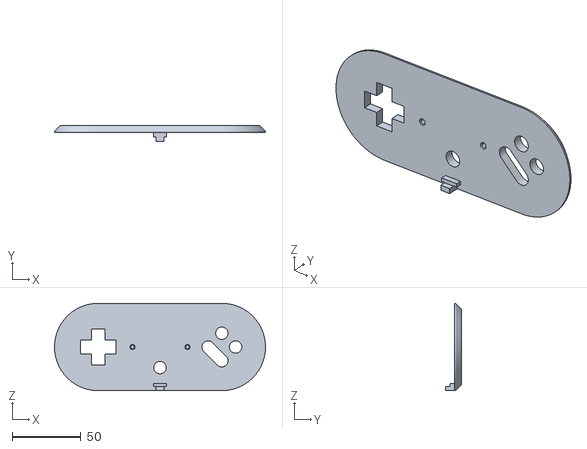
[picture p62: CAD file, 2025-10-03]
Production/quote_pkg/gametank-quote-package-v8-console-controllers-add-resistors/STLs-V8/Controller/gametank-controller-faceplate.stl
153.5 x 11.4 x 63.5
