clydeshaffer/gametank/Production/quote_pkg/STLs-V4/Controller/gametank-controller-buttons.stl

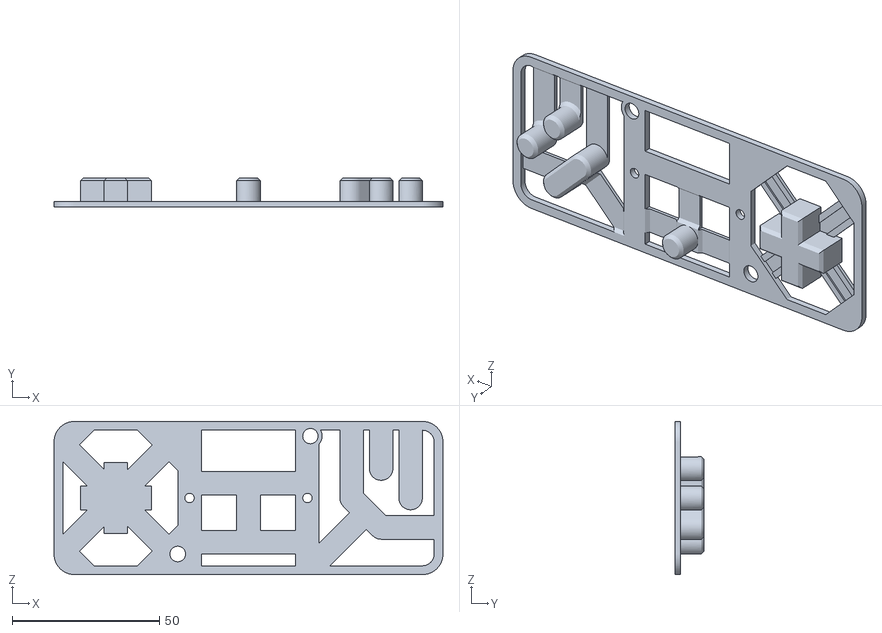
[picture p63: CAD file, 2026-02-07]
Production/quote_pkg/STLs-V4/Controller/gametank-controller-buttons.stl
132.0 x 10.0 x 52.0
