clydeshaffer/gametank/Production/quote_pkg/STLs-V4/Flasher/flasher-base.stl

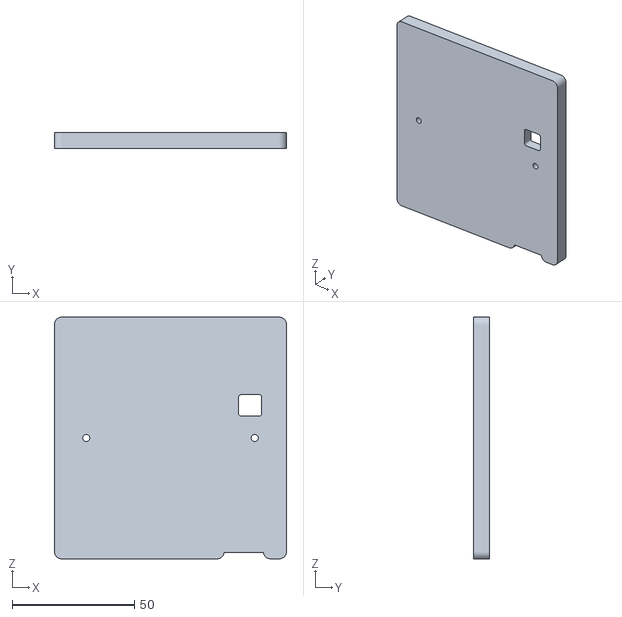
[picture p64: CAD file, 2026-02-07]
Production/quote_pkg/STLs-V4/Flasher/flasher-base.stl
95.0 x 6.60 x 99.0
