clydeshaffer/gametank/Production/quote_pkg/STPs/Console/bottom-shell.step

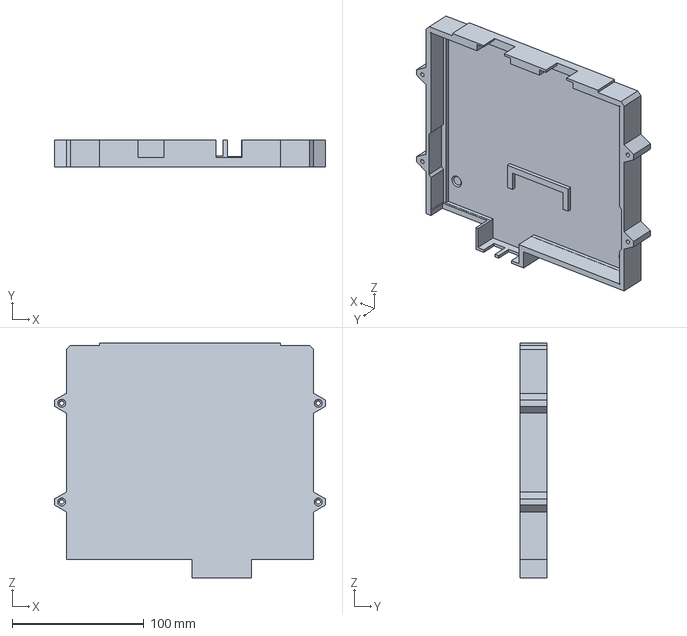
[picture p65: CAD file, 2025-12-01]
Production/quote_pkg/STPs/Console/bottom-shell.step
205.8 x 20.3 x 178.4 mm
