clydeshaffer/gametank/Production/quote_pkg/STPs/Controller/controller-body.step

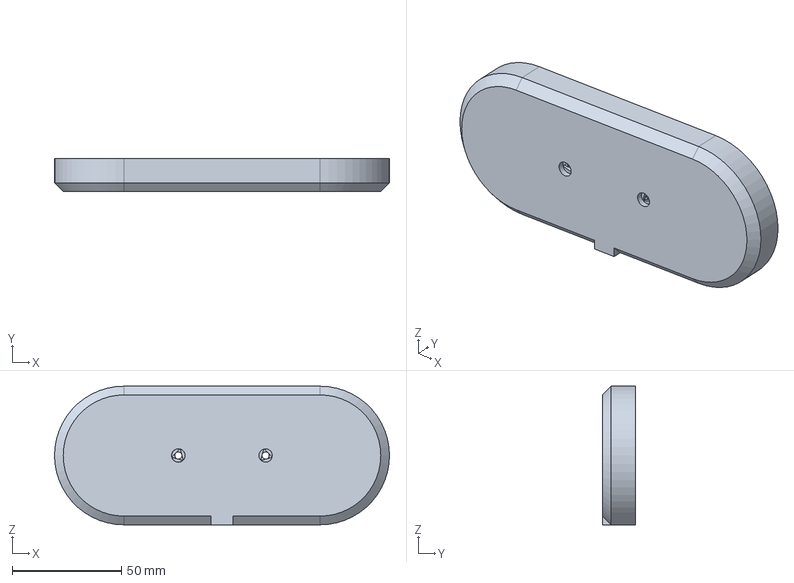
[picture p66: CAD file, 2025-12-01]
Production/quote_pkg/STPs/Controller/controller-body.step
153.5 x 15.2 x 63.5 mm
