clydeshaffer/gametank/CAD/STLs/cartridge/molded/cart_molded_front.stl

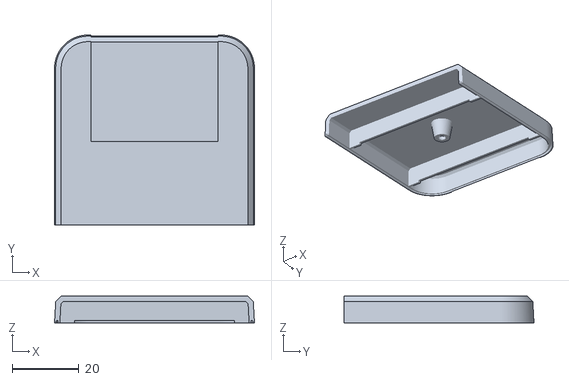
[picture p67: CAD file, 2026-03-05]
CAD/STLs/cartridge/molded/cart_molded_front.stl
60.0 x 57.0 x 8.00
