clydeshaffer/gametank/CAD/STLs/console/v1-tht/gametank-case-powervent.stl

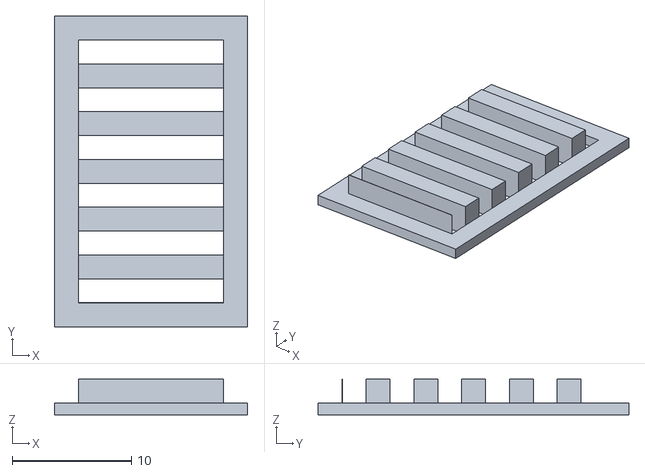
[picture p68: CAD file, 2022-07-22]
CAD/STLs/console/v1-tht/gametank-case-powervent.stl
16.2 x 26.0 x 3.00
