clydeshaffer/gametank/CAD/STLs/controller/v1-arms/shell_bottom.stl

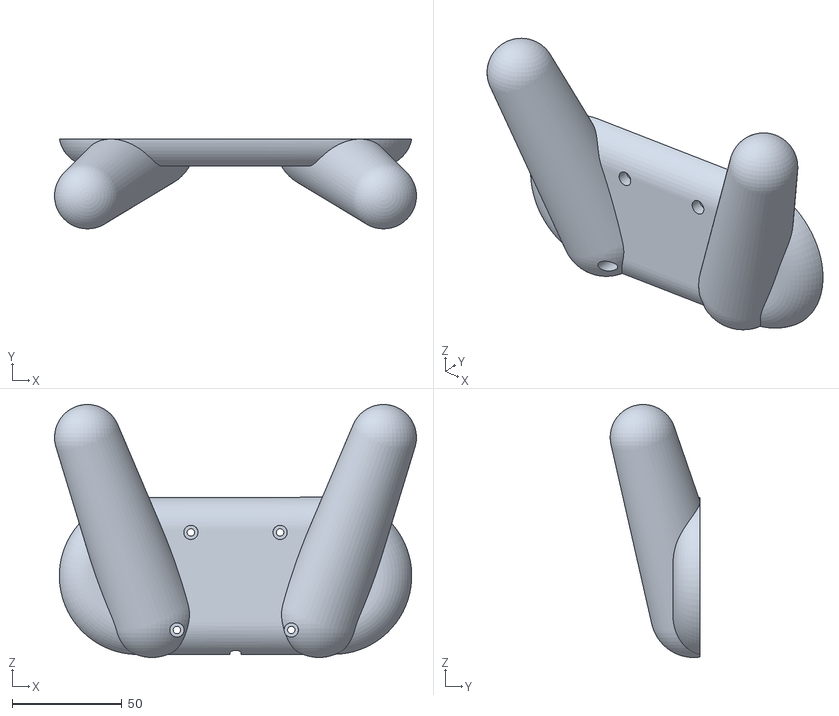
[picture p69: CAD file, 2022-11-03]
CAD/STLs/controller/v1-arms/shell_bottom.stl
164.9 x 40.9 x 115.3
