clydeshaffer/gametank/CAD/STLs/controller/v2-armless/buttons/AssemblyTools/ButtonBushingJig/button-jig-bottom.stl

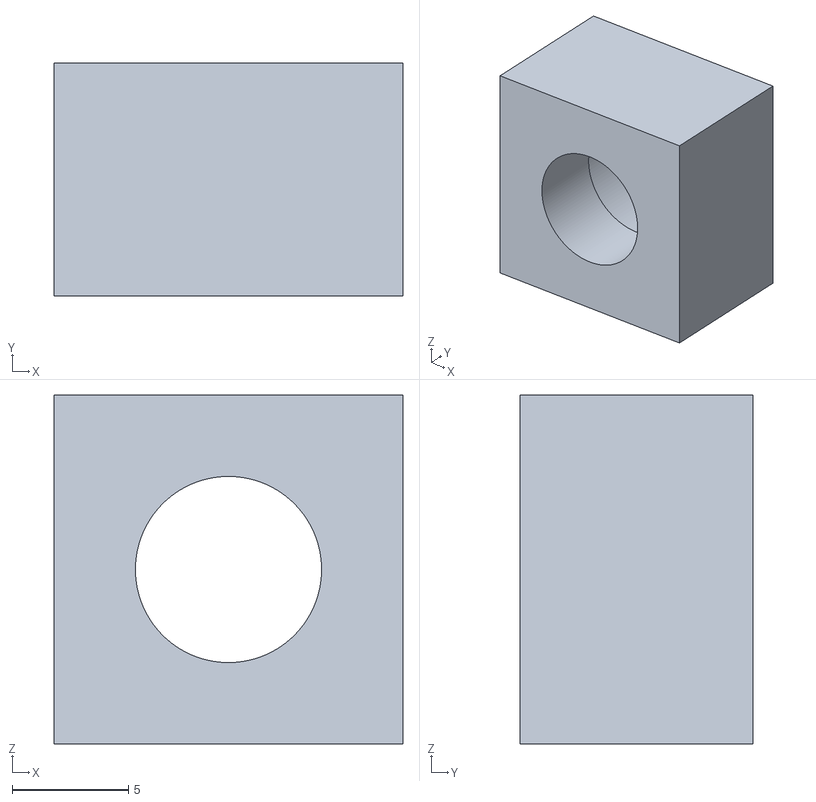
[picture p70: CAD file, 2024-08-06]
CAD/STLs/controller/v2-armless/buttons/AssemblyTools/ButtonBushingJig/button-jig-bottom.stl
15.0 x 10.0 x 15.0
