clydeshaffer/gametank/CAD/STLs/misc/exbus_backplane/ps2_card_bracket.stl

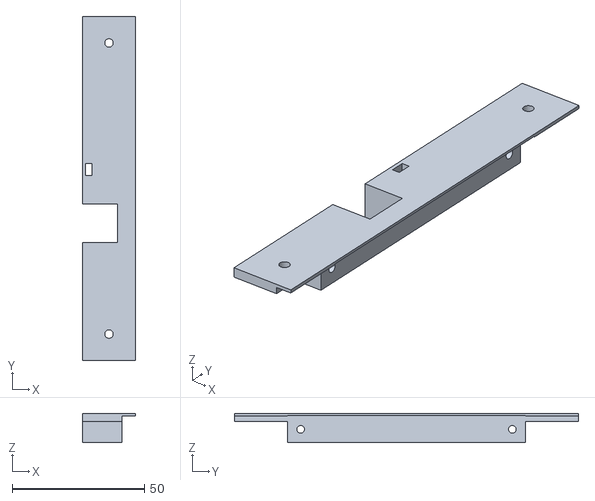
[picture p72: CAD file, 2026-09-29]
CAD/STLs/misc/exbus_backplane/ps2_card_bracket.stl
20.0 x 130.0 x 11.0
