clydeshaffer/gametank/Docs/PackagingLabels/PackagingV2/foam/layer-manual.dxf

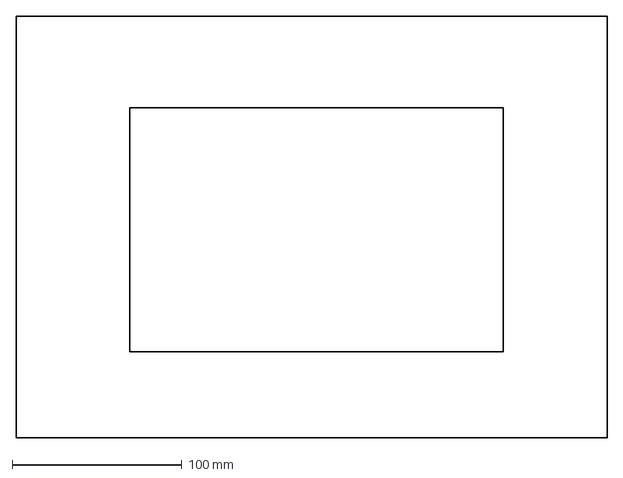
[picture p73: CAD file, 2026-07-06]
Docs/PackagingLabels/PackagingV2/foam/layer-manual.dxf
348.0 x 248.0 mm
