clydeshaffer/gametank/Hardware/KiCad/tools/exp_port_leds/exp_port_leds_labels.stl

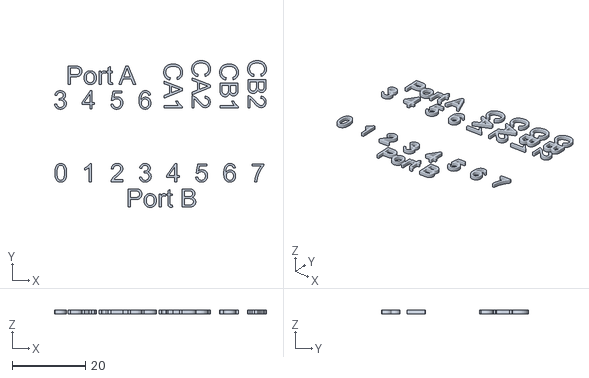
[picture p74: CAD file, 2026-03-05]
Hardware/KiCad/tools/exp_port_leds/exp_port_leds_labels.stl
57.8 x 40.0 x 1.00
