clydeshaffer/gametank/Production/quote_pkg/gametank-quote-package-v8-console-controllers-add-resistors/STLs-V8/Controller/gametank-controller-pivot.stl

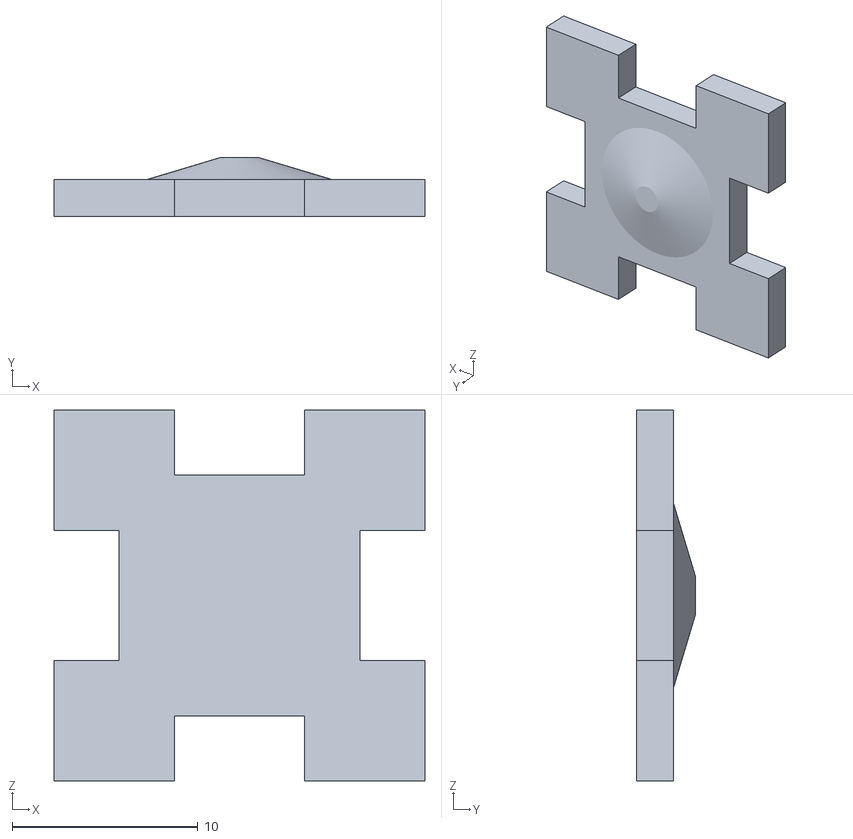
[picture p75: CAD file, 2025-10-03]
Production/quote_pkg/gametank-quote-package-v8-console-controllers-add-resistors/STLs-V8/Controller/gametank-controller-pivot.stl
20.0 x 3.20 x 20.0
