clydeshaffer/gametank/Production/quote_pkg/STPs/Console/badge.step

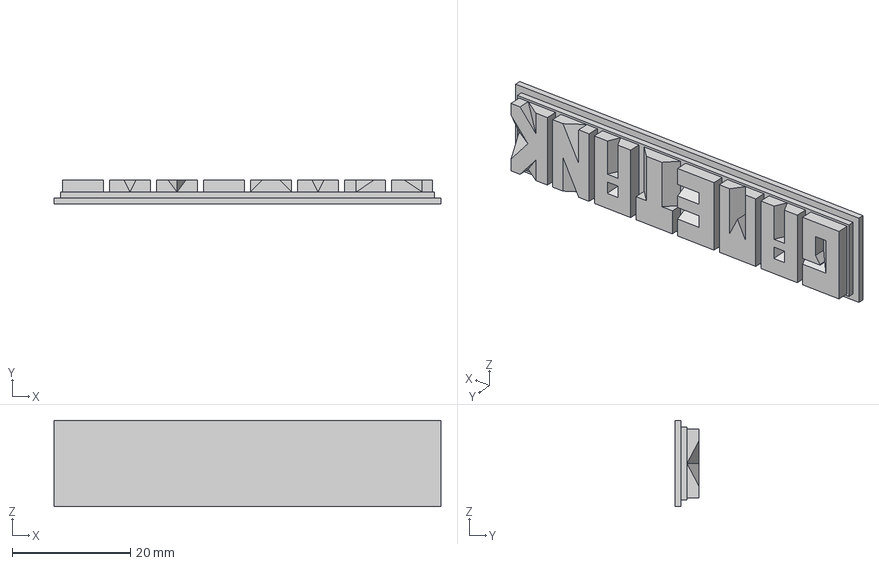
[picture p76: CAD file, 2025-12-01]
Production/quote_pkg/STPs/Console/badge.step
65.4 x 4.00 x 14.6 mm
