clydeshaffer/gametank/CAD/STLs/console/v2.5-smd/gametank-enclosure-vent.stl

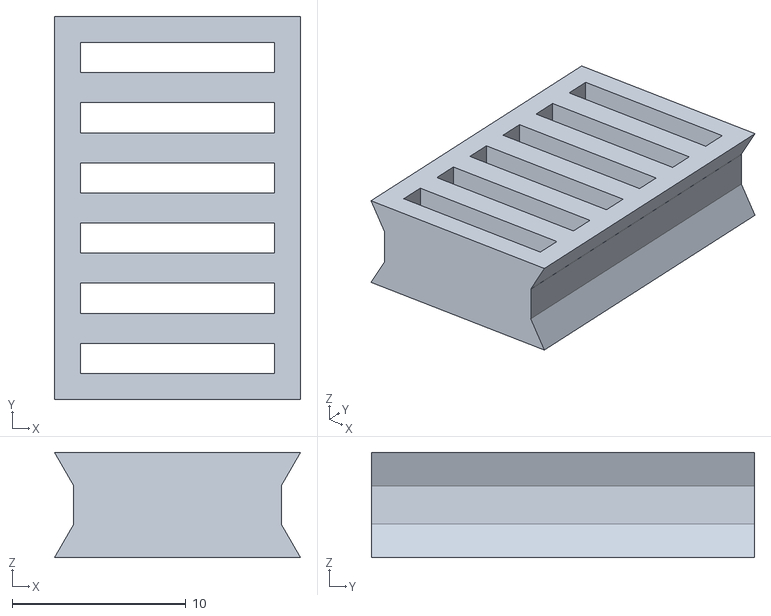
[picture p77: CAD file, 2025-10-03]
CAD/STLs/console/v2.5-smd/gametank-enclosure-vent.stl
14.2 x 22.0 x 6.06
