clydeshaffer/gametank/CAD/STLs/controller/v1-arms/shell_top.stl

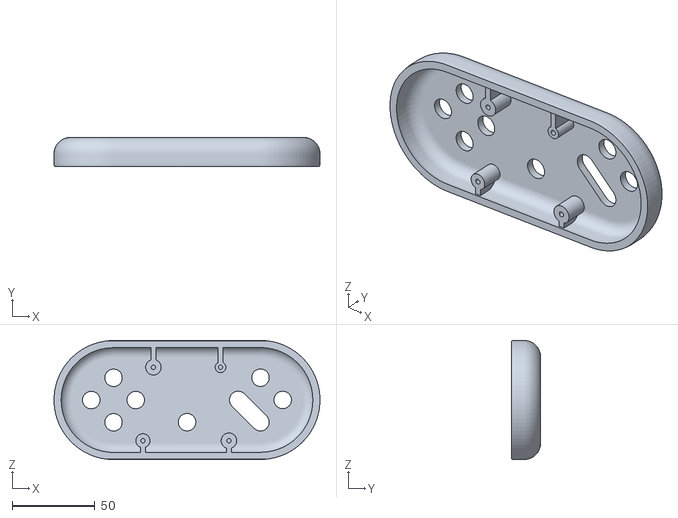
[picture p78: CAD file, 2022-11-03]
CAD/STLs/controller/v1-arms/shell_top.stl
161.0 x 17.7 x 72.1
