clydeshaffer/gametank/CAD/STLs/controller/v2-armless/buttons/bushing_outlines_raw.dxf

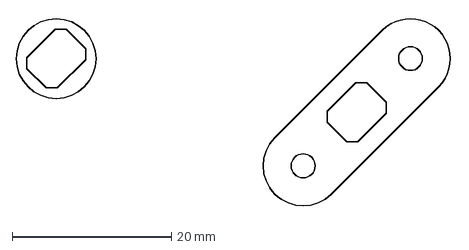
[picture p79: CAD file, 2024-08-06]
CAD/STLs/controller/v2-armless/buttons/bushing_outlines_raw.dxf
54.7 x 24.3 mm
