clydeshaffer/gametank/CAD/STLs/controller/v2-armless/shell_bottom3.stl

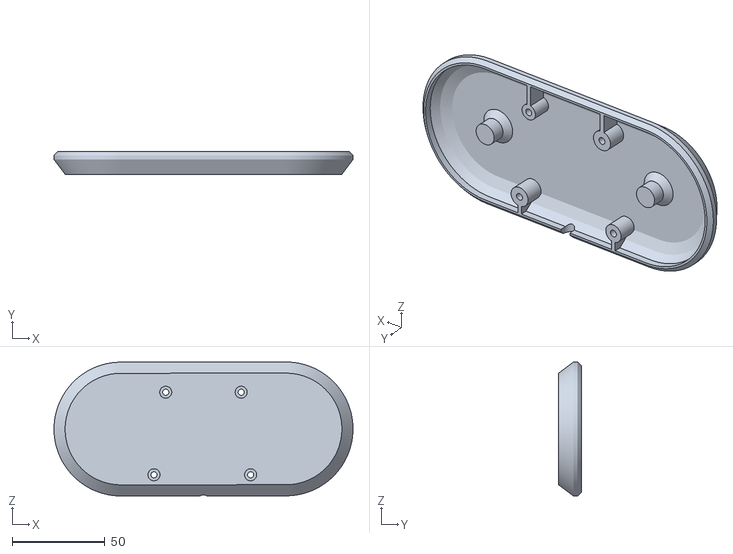
[picture p80: CAD file, 2024-08-06]
CAD/STLs/controller/v2-armless/shell_bottom3.stl
161.0 x 12.3 x 72.1
