clydeshaffer/gametank/CAD/STLs/controller/v3-smt/button flexure.3mf

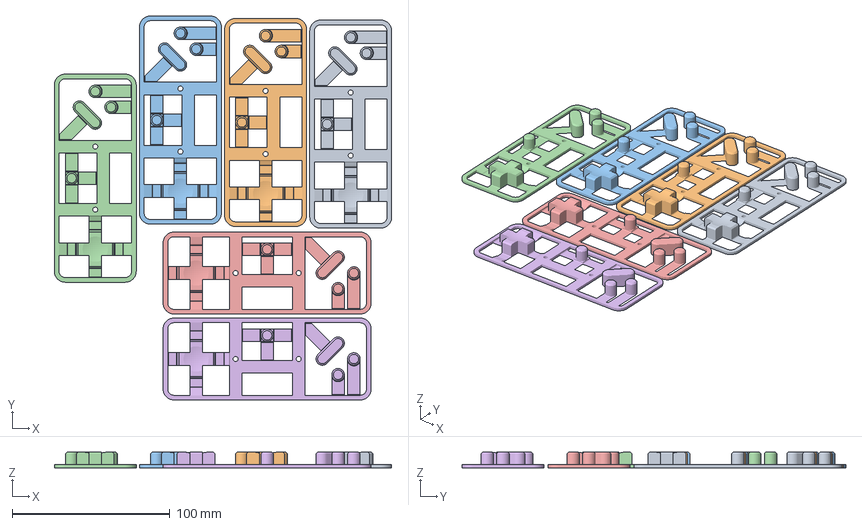
[picture p81: CAD file, 2025-01-20]
CAD/STLs/controller/v3-smt/button flexure.3mf
214.0 x 243.5 x 10.0 mm
button flexure.stl x 3
button flexure.stl 1
button flexure.stl 2
button flexure.stl 3
