clydeshaffer/gametank/Docs/PackagingLabels/PackagingV2/foam/layer-top-bottom.dxf

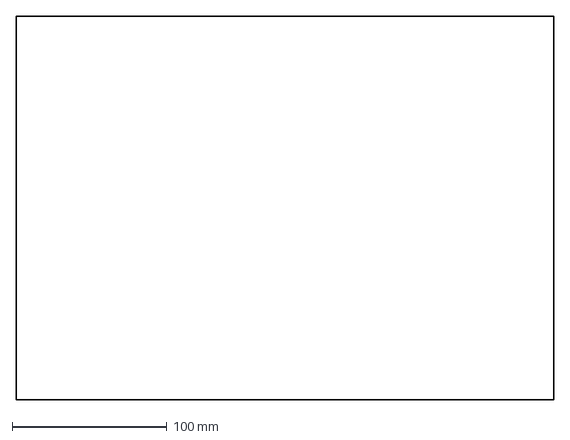
[picture p82: CAD file, 2026-07-06]
Docs/PackagingLabels/PackagingV2/foam/layer-top-bottom.dxf
348.0 x 248.0 mm
