clydeshaffer/gametank/Hardware/KiCad/tools/exp_port_leds/exp_port_leds.step

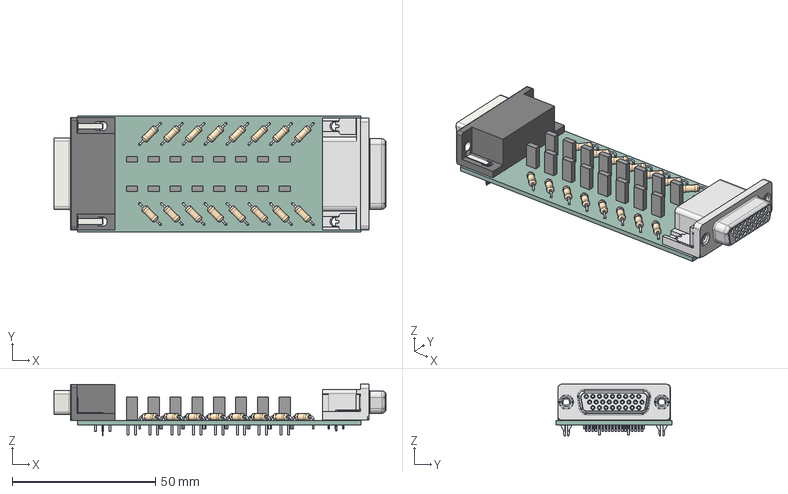
[picture p83: CAD file, 2026-03-05]
Hardware/KiCad/tools/exp_port_leds/exp_port_leds.step
115.9 x 40.6 x 18.1 mm
R_Axial_DIN0207_L6.3mm_D2.5mm_P10.16mm_Horizontal x 16
Leads x 16
DSUB-26-HD_Pins_Horizontal_P2.29x2.54mm_EdgePinOffset8.35mm_Housed_ MountingHolesOffset10.89mm
exp_port_leds_PCB
