clydeshaffer/gametank/Production/quote_pkg/gametank-quote-package-v8-console-controllers-add-resistors/STLs-V8/Console/gametank-console-board-spacer.stl

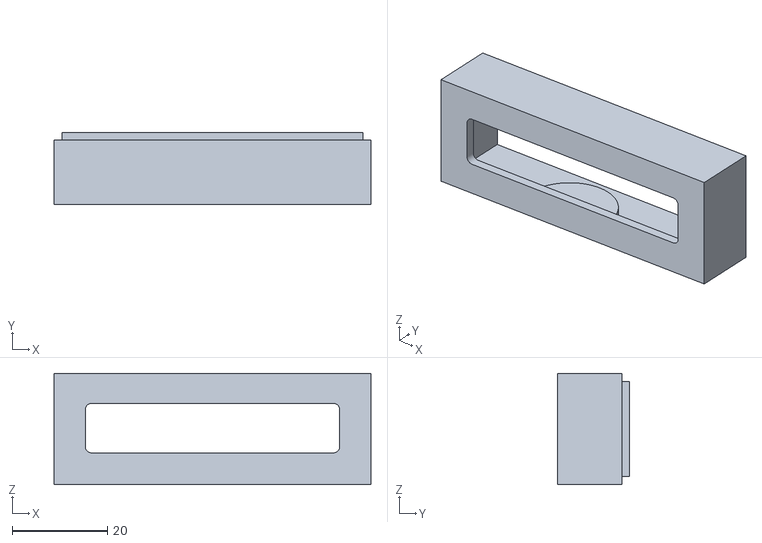
[picture p84: CAD file, 2025-10-03]
Production/quote_pkg/gametank-quote-package-v8-console-controllers-add-resistors/STLs-V8/Console/gametank-console-board-spacer.stl
66.5 x 15.0 x 23.3
