clydeshaffer/gametank/CAD/STLs/console/v1-tht/gametank-case-powercover.stl

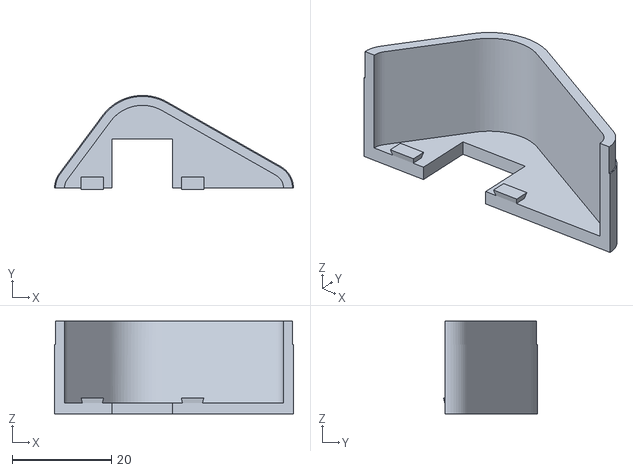
[picture p85: CAD file, 2022-07-22]
CAD/STLs/console/v1-tht/gametank-case-powercover.stl
48.1 x 18.9 x 18.7
