clydeshaffer/gametank/CAD/STLs/controller/v1-arms/button_wide.stl

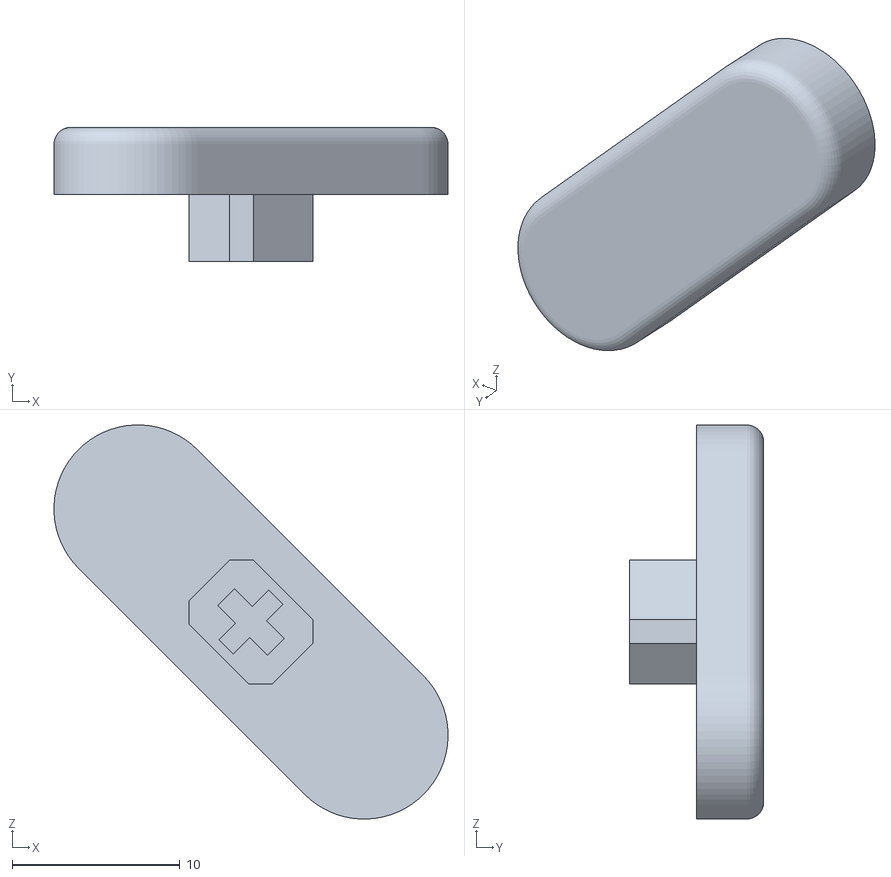
[picture p86: CAD file, 2022-11-03]
CAD/STLs/controller/v1-arms/button_wide.stl
23.5 x 8.00 x 23.5
