clydeshaffer/gametank/CAD/STLs/controller/v2-armless/buttons/cap_labeled_multi.3mf

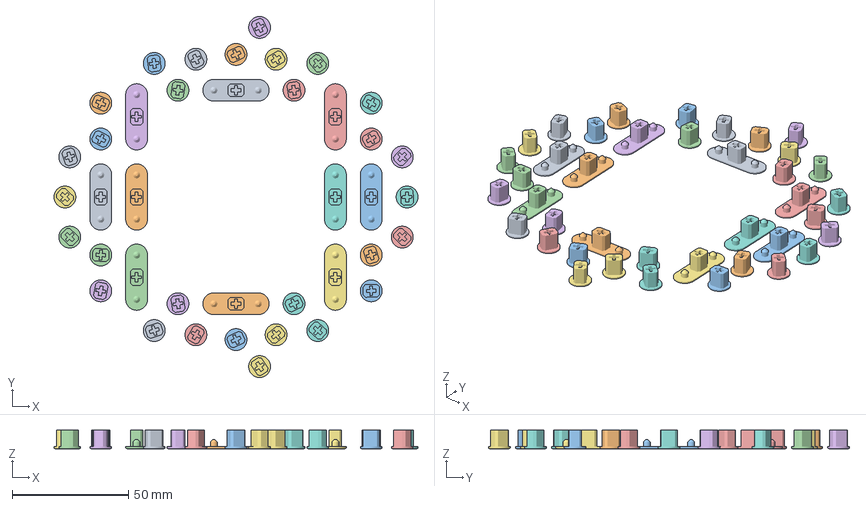
[picture p87: CAD file, 2024-08-06]
CAD/STLs/controller/v2-armless/buttons/cap_labeled_multi.3mf
156.4 x 155.1 x 8.00 mm
cap_C.stl
cap_A.stl
cap_B.stl
cap_S.stl
