clydeshaffer/gametank/Docs/PackagingLabels/PackagingV2/foam/layer-accessories.dxf

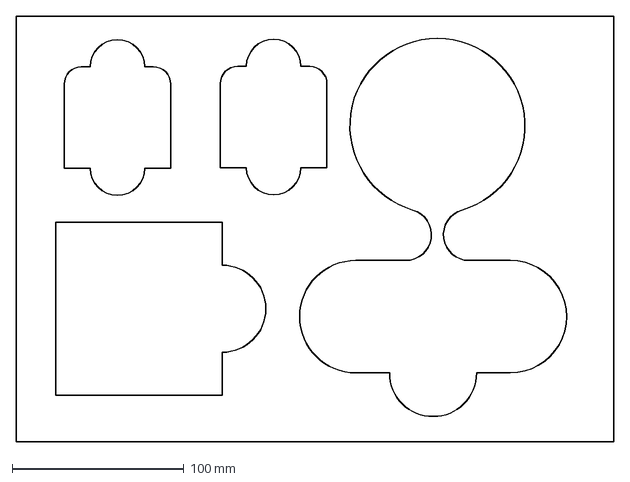
[picture p88: CAD file, 2026-07-06]
Docs/PackagingLabels/PackagingV2/foam/layer-accessories.dxf
348.0 x 248.0 mm
