clydeshaffer/gametank/CAD/STLs/controller/v2-armless/buttons/cap_slim.stl

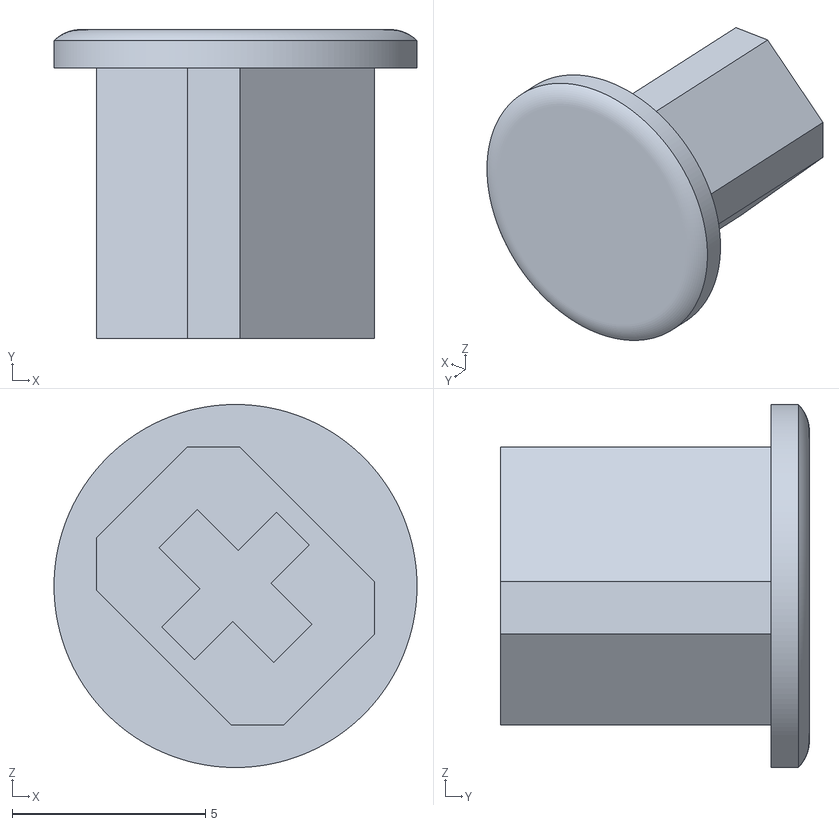
[picture p89: CAD file, 2024-08-06]
CAD/STLs/controller/v2-armless/buttons/cap_slim.stl
9.40 x 8.00 x 9.40
