clydeshaffer/gametank/CAD/STLs/controller/v3-smt/labels.stl

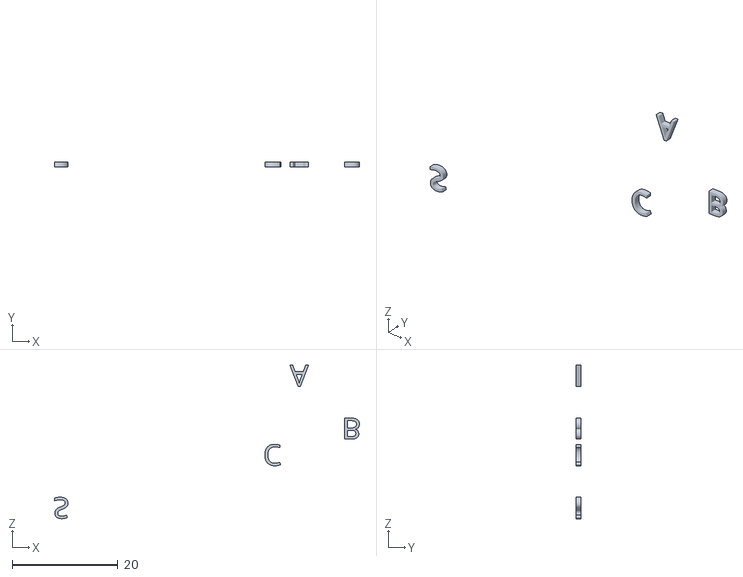
[picture p90: CAD file, 2024-09-06]
CAD/STLs/controller/v3-smt/labels.stl
57.7 x 1.00 x 29.0
