clydeshaffer/gametank/Docs/PackagingLabels/PackagingV2/foam/layer-separator.dxf

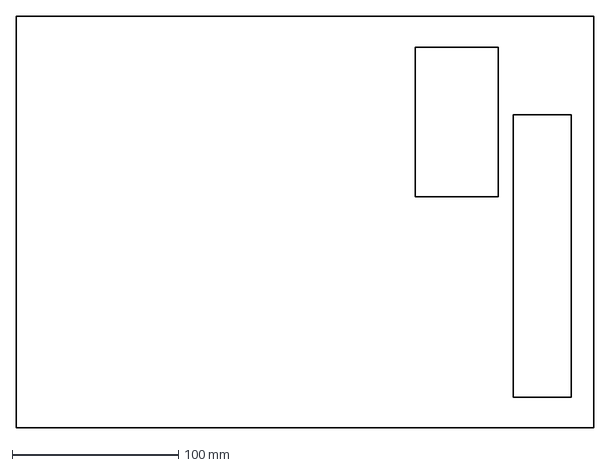
[picture p91: CAD file, 2026-07-06]
Docs/PackagingLabels/PackagingV2/foam/layer-separator.dxf
348.0 x 248.0 mm
