clydeshaffer/gametank/Production/quote_pkg/STPs/Controller/controller-face.step

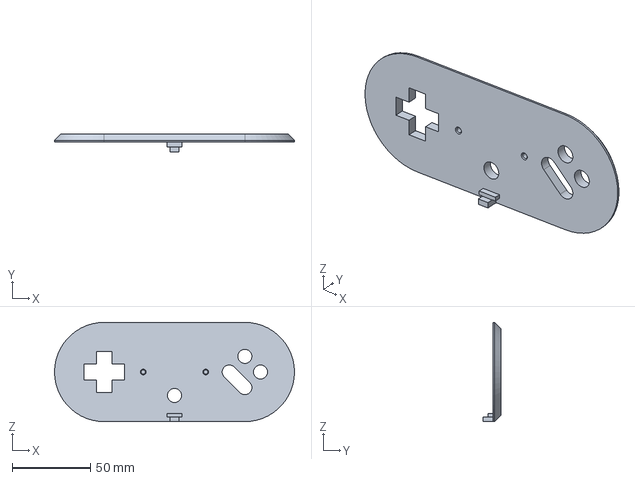
[picture p92: CAD file, 2025-12-01]
Production/quote_pkg/STPs/Controller/controller-face.step
153.5 x 11.4 x 63.5 mm
