clydeshaffer/gametank/(list of files, cad)

Other CAD files:
Hardware/KiCad/AVBoard_smt/avboard_smt.step
Hardware/KiCad/ps_slash_2/ps2mkb/ps2mkb.step
Hardware/KiCad/tools/cartflasher_2/flasher2/pcbway_production/2026-05-08-17-13-06/flasher-base.stl
Production/quote_pkg/STLs-V4/Cartridge/gametank-cartridge-front.stl
Production/quote_pkg/STPs/Cartridge/shell-back.step
Production/quote_pkg/STPs/Flasher/flasher-base v1.step
CAD/STLs/controller/v2-armless/shell_top_exp.stl
CAD/STLs/controller/v3-smt/bottom body.stl
Hardware/KiCad/Controller/controller_v3/gpad1.step
Production/quote_pkg/STLs-V4/Cartridge/gametank-cartridge-back.stl
Production/quote_pkg/STLs-V4/Controller/gametank-controller-spacer.stl
Production/quote_pkg/STPs/Cartridge/shell-front.step
Production/quote_pkg/STPs/Controller/controller-spacer.step
CAD/STLs/console/v1-tht/gametank-case-bottom.stl
Production/quote_pkg/gametank-quote-package-v7-console-controllers-RCA-change/STLs-V7/Console/gametank-enclosure-badge.stl
Production/quote_pkg/STPs/Console/vent-insert.step
Production/quote_pkg/STPs/Controller/buttons.step
CAD/STLs/controller/v3-smt/dpad_bump_320.stl
Production/quote_pkg/gametank-quote-package-v8-console-controllers-add-resistors/STLs-V8/Console/gametank-enclosure-badge.stl
Production/quote_pkg/STPs/Console/top-shell.step
Production/quote_pkg/STPs/Controller/dpad-bump.step
Production/quote_pkg/STPs/Console/center-support.step
CAD/STLs/controller/v3-smt/top plate.stl
CAD/STLs/controller/v2-armless/buttons/cap_A.stl
CAD/STLs/controller/v2-armless/buttons/cap_blank.stl
CAD/STLs/controller/v2-armless/buttons/cap_S.stl
CAD/STLs/console/v2-smd/badge2.stl
CAD/STLs/console/v2-smd/bottom-tray.stl
CAD/STLs/console/v2-smd/center_support.stl
CAD/STLs/console/v2-smd/top-center.stl
CAD/STLs/console/v2-smd/tread-left.stl
CAD/STLs/console/v2-smd/tread-right.stl
CAD/STLs/console/v2-smd/vent.stl
CAD/STLs/console/v2.5-smd/gametank-enclosure-bottom.stl
CAD/STLs/console/v2.5-smd/gametank-enclosure-top.stl
CAD/STLs/controller/v3-smt/button flexure.stl
Production/quote_pkg/STLs-V2/Cartridge/gametank-cartridge-back.stl
Production/quote_pkg/STLs-V2/Cartridge/gametank-cartridge-front.stl
Production/quote_pkg/STLs-V2/Controller/gametank-controller-labels.f3d
Production/quote_pkg/STLs-V2/Controller/gametank-controller-spacer.stl
Production/quote_pkg/STLs-V3/Cartridge/gametank-cartridge-back.stl
Production/quote_pkg/STLs-V3/Cartridge/gametank-cartridge-front.stl
Production/quote_pkg/STLs-V3/Controller/gametank-controller-labels.f3d
Production/quote_pkg/STLs-V3/Controller/gametank-controller-spacer.stl
Production/quote_pkg/STLs-V4/Controller/gametank-controller-labels.f3d
Production/quote_pkg/STLs/Cartridge/gametank-cartridge-back.stl
Production/quote_pkg/STLs/Cartridge/gametank-cartridge-front.stl
Production/quote_pkg/STLs/Console/gametank-enclosure-bottom.stl
Production/quote_pkg/STLs/Console/gametank-enclosure-top.stl
Production/quote_pkg/STLs/Controller/gametank-controller-buttons.stl
Production/quote_pkg/STLs/Controller/gametank-controller-labels.f3d
Production/quote_pkg/STLs/Controller/gametank-controller-spacer.stl
Production/quote_pkg/STLs/Flasher/gametank-flasher-base.stl
