clydeshaffer/gametank/Production/quote_pkg/3d-print-color-annotation.pdf

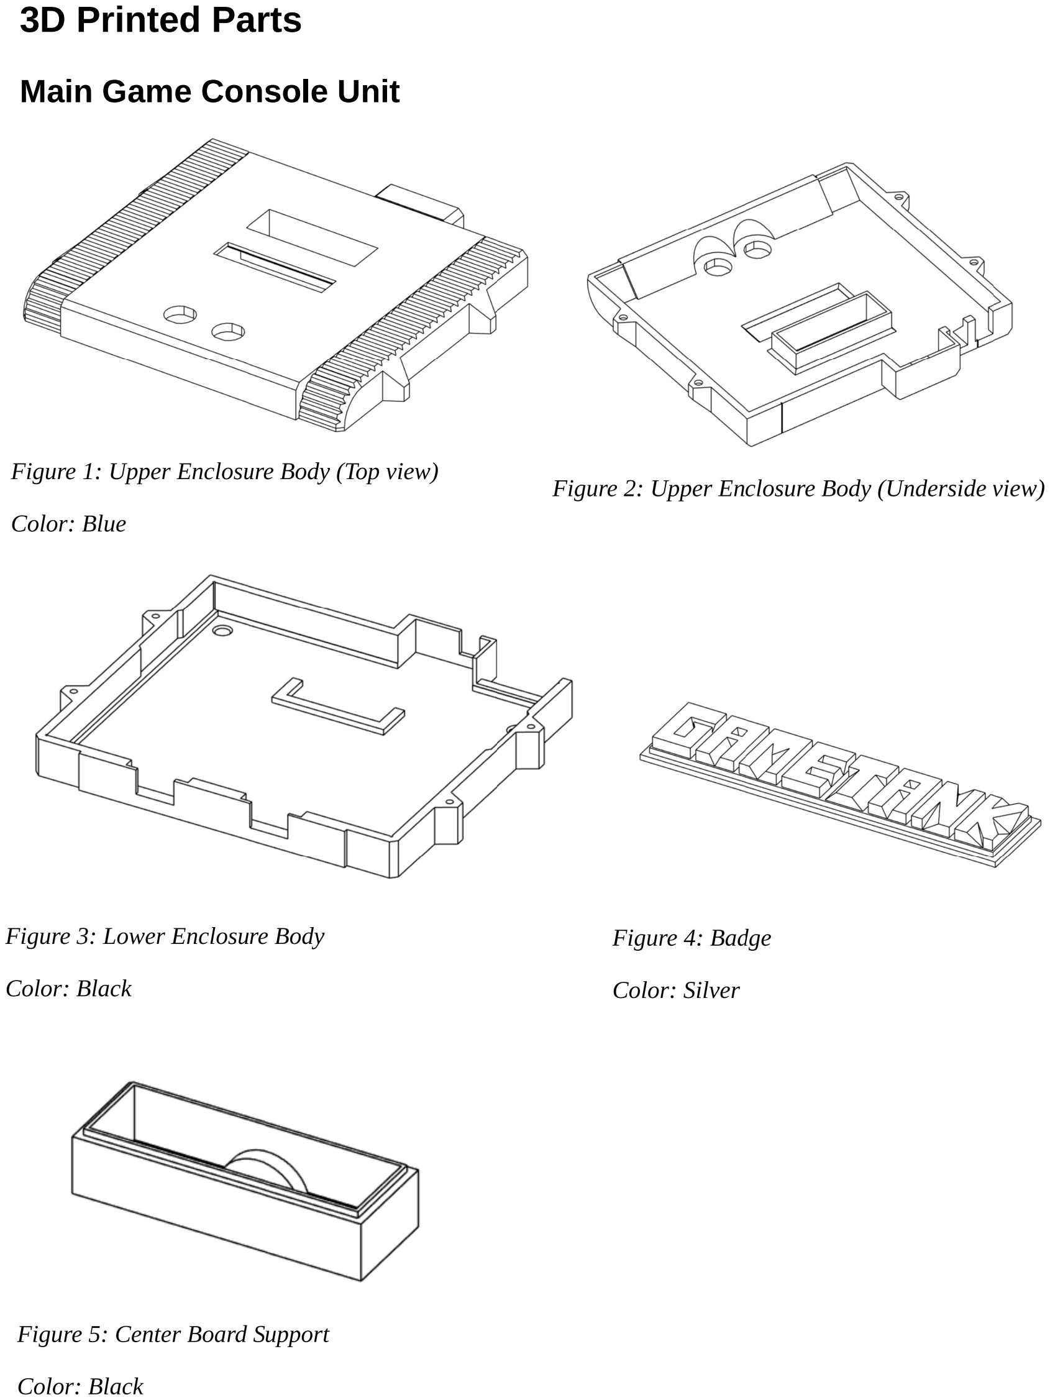
[picture p143: page 1]

3D Printed Parts

Main Game Console Unit

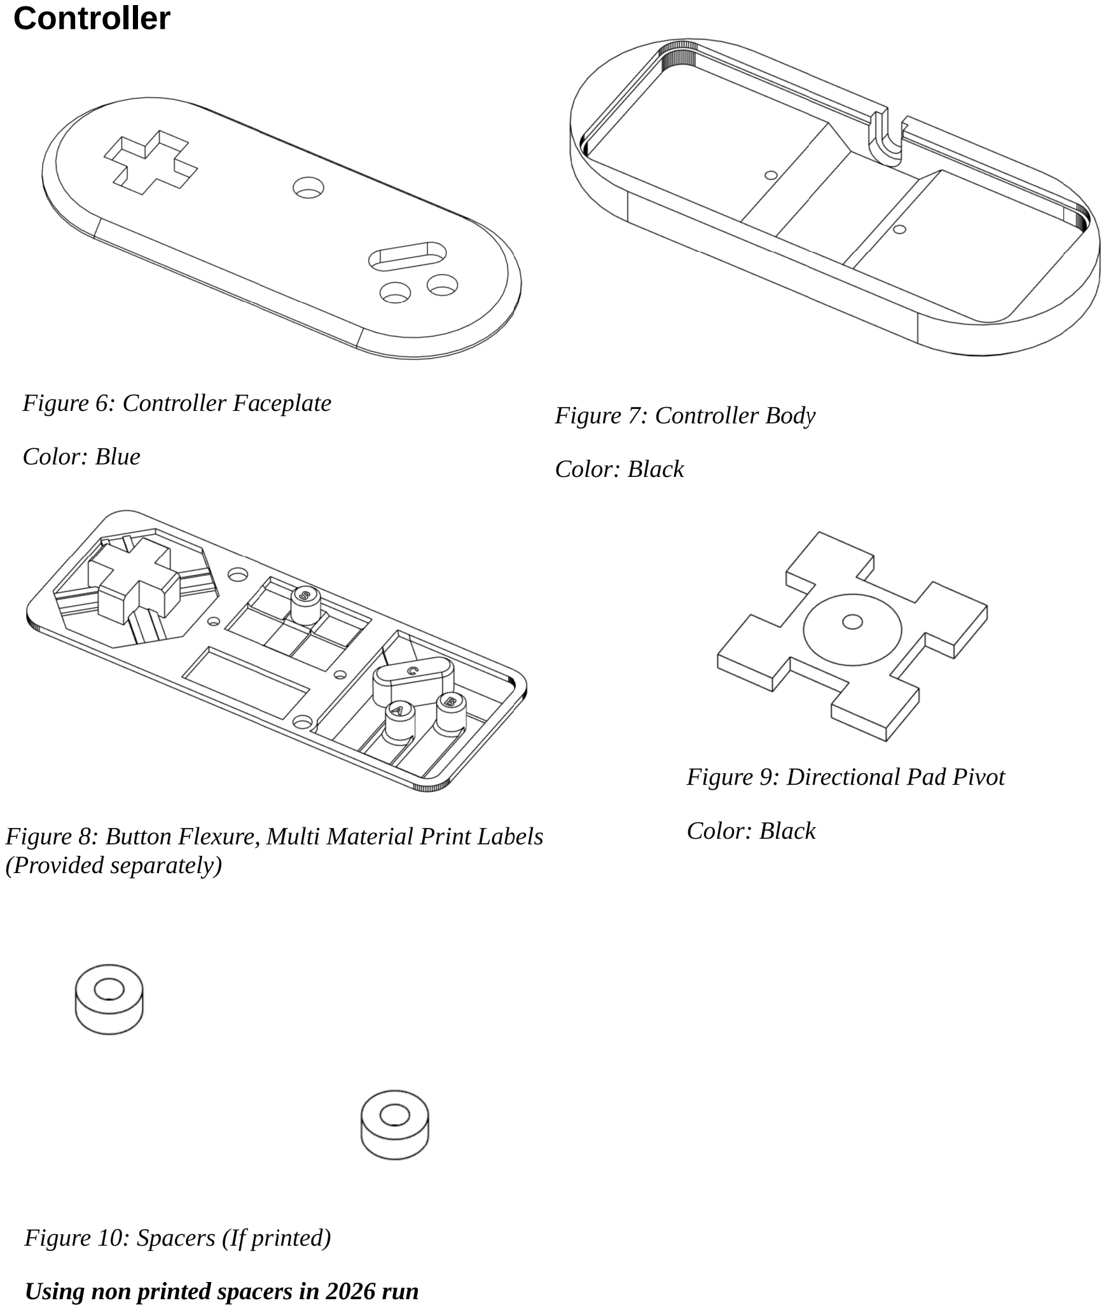
[picture p144: page 2]

Controller

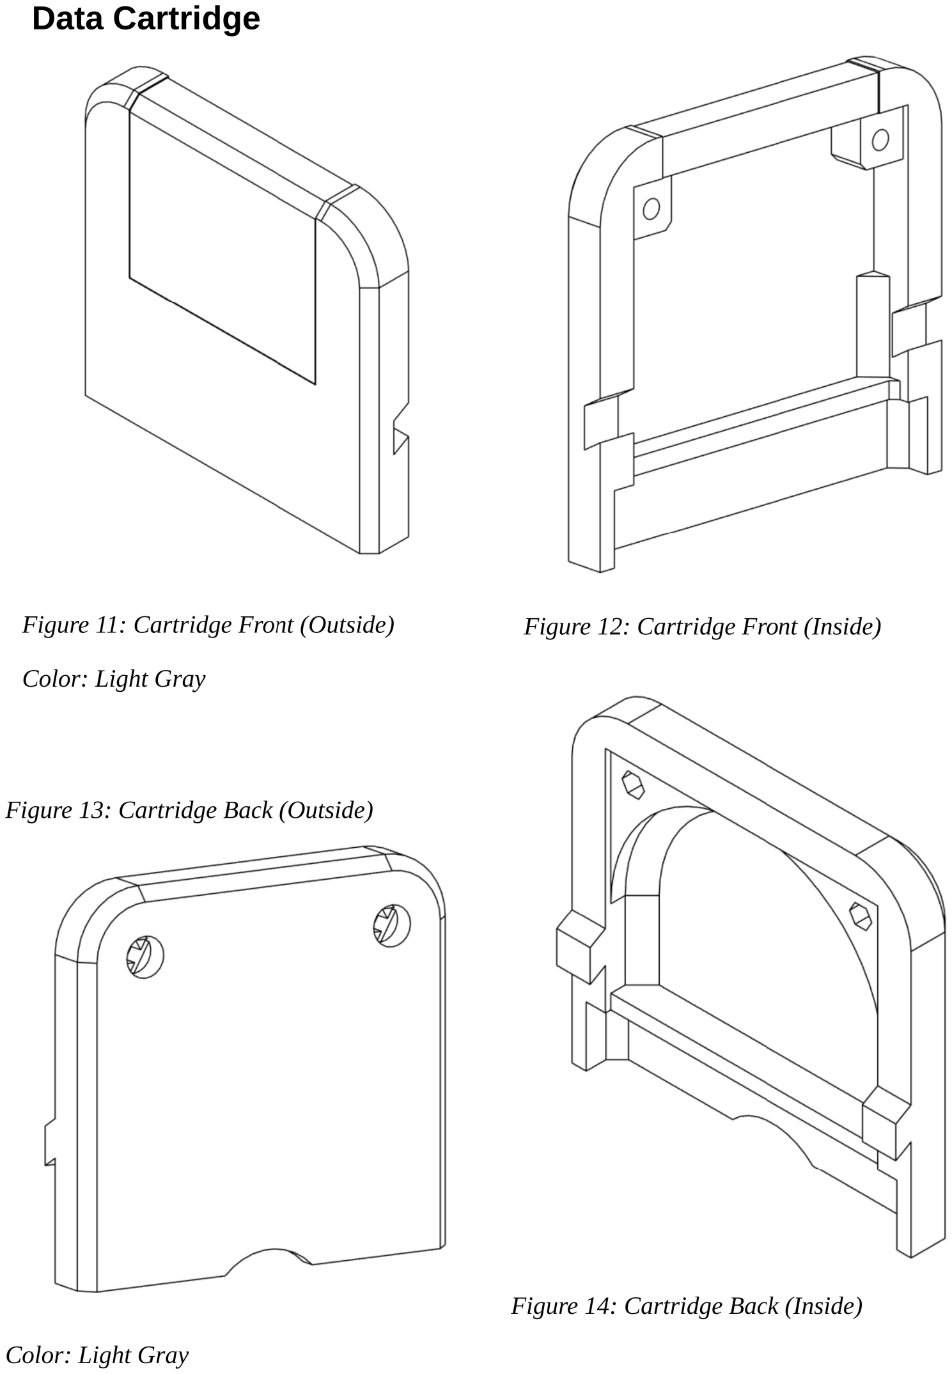
[picture p145: page 3]

Data Cartridge

Cartridge Flasher Tool

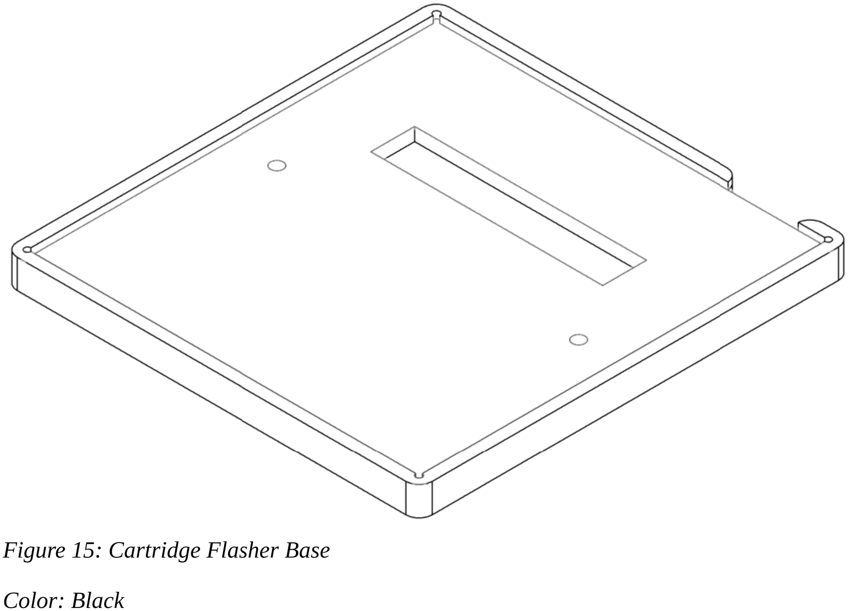
[picture p146: figure]
