clydeshaffer/gametank/(threads)

Thread 2 (2020-12-09):

DS1866 digital potentiometers have been discontinued

clydeshaffer, 2020-12-09:
This kind of messes up the existing scheme for modulating the volume of audio channels.
The remaining models of digital potentiometer have serial or increment/decrement interfaces.

clydeshaffer, 2020-12-09:
Possible solutions:
- switch to DS1804 digipot with inc/dec interface
    requires additional circuit to control, or software changes
    inc/decrementing through 99 states might be too slow/unwieldy
    otherwise minimal disruption to existing hardware design

-replace whole audio circuit with 6502 coprocessor controlling a DAC
    definitely requires major software changes
    scary to implement in emulator
    large flexibility gains tho

clydeshaffer, 2022-08-02:
Solved by replacing whole audio circuit with 6502 coprocessor controlling a DAC

Closed 2022-08-02.

Thread 5 (2022-08-16):

Replace IQD Oscillator module

clydeshaffer, 2022-08-16:
The 28MHz oscillator part has been retired.
There don't seem to be any available through-hole equivalents.

A replacement is needed either in the form of a drop-in adapter for an SMD oscillator, or a through-hole oscillator circuit with a discrete crystal.

clydeshaffer, 2022-09-03:
The SMD oscillator from IQD replaces this exactly and tested successfully.

Closed 2022-09-03.

Thread 6 (2022-08-16):

Replace TSH122 video buffer amp

clydeshaffer, 2022-08-16:
The TSH122 seems to have vanished from the face of the earth despite not being marked EoL.

Current leading replacement candidate is THS7374IPWR, which will need a breakout/adapter board designed.

clydeshaffer, 2022-09-03:
THS7374IPWR successfully tested as a replacement part for the buffer amp.
Next action item is to add the adapter PCB to the build guide

Closed 2023-01-26.
