clydeshaffer/gametank/Hardware/Combined/cpu-blitter-inputs.pdf

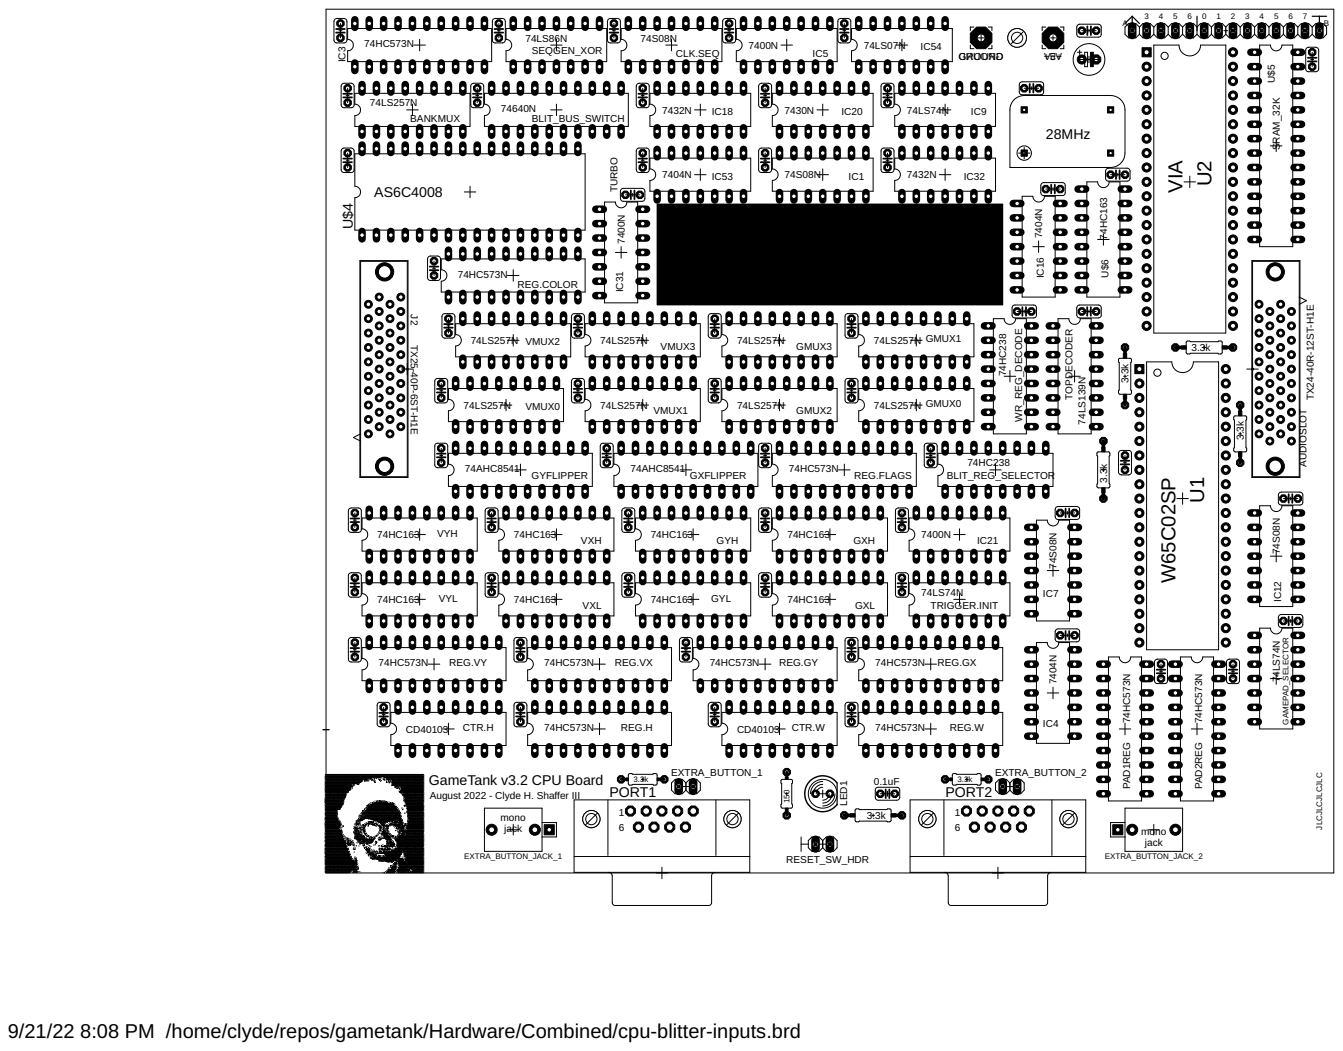
[picture p170: page 1]

9/21/22 8:08 PM /home/clyde/repos/gametank/Hardware/Combined/cpu-blitter-inputs.brd
