clydeshaffer/gametank/Hardware/Combined/signals.pdf

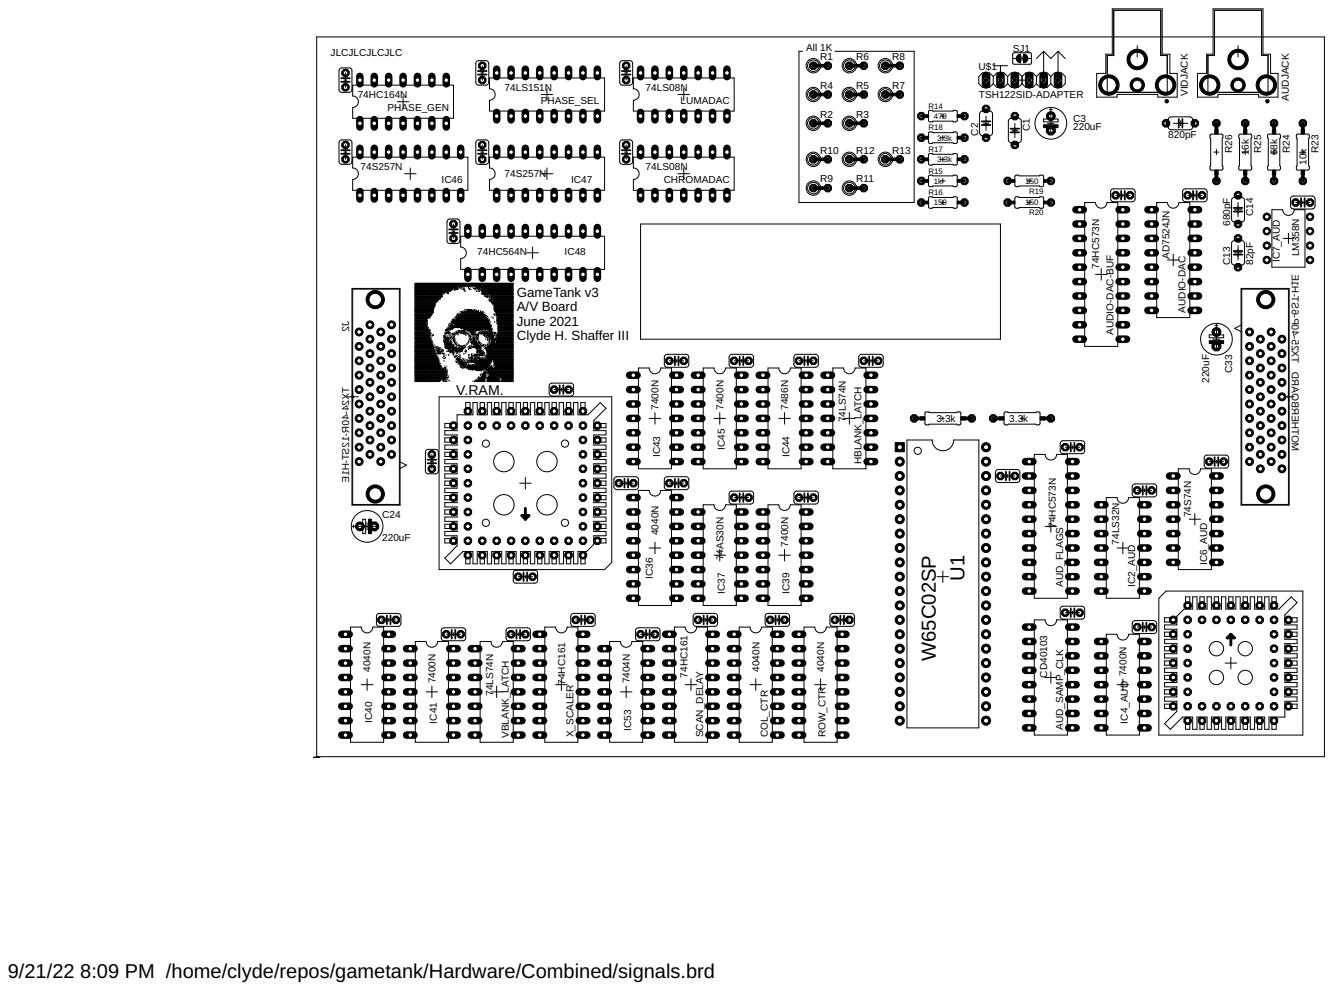
[picture p171: page 1]

9/21/22 8:09 PM /home/clyde/repos/gametank/Hardware/Combined/signals.brd
