clydeshaffer/gametank/Docs/SchematicPDFs/cpu-blitter-inputs.pdf

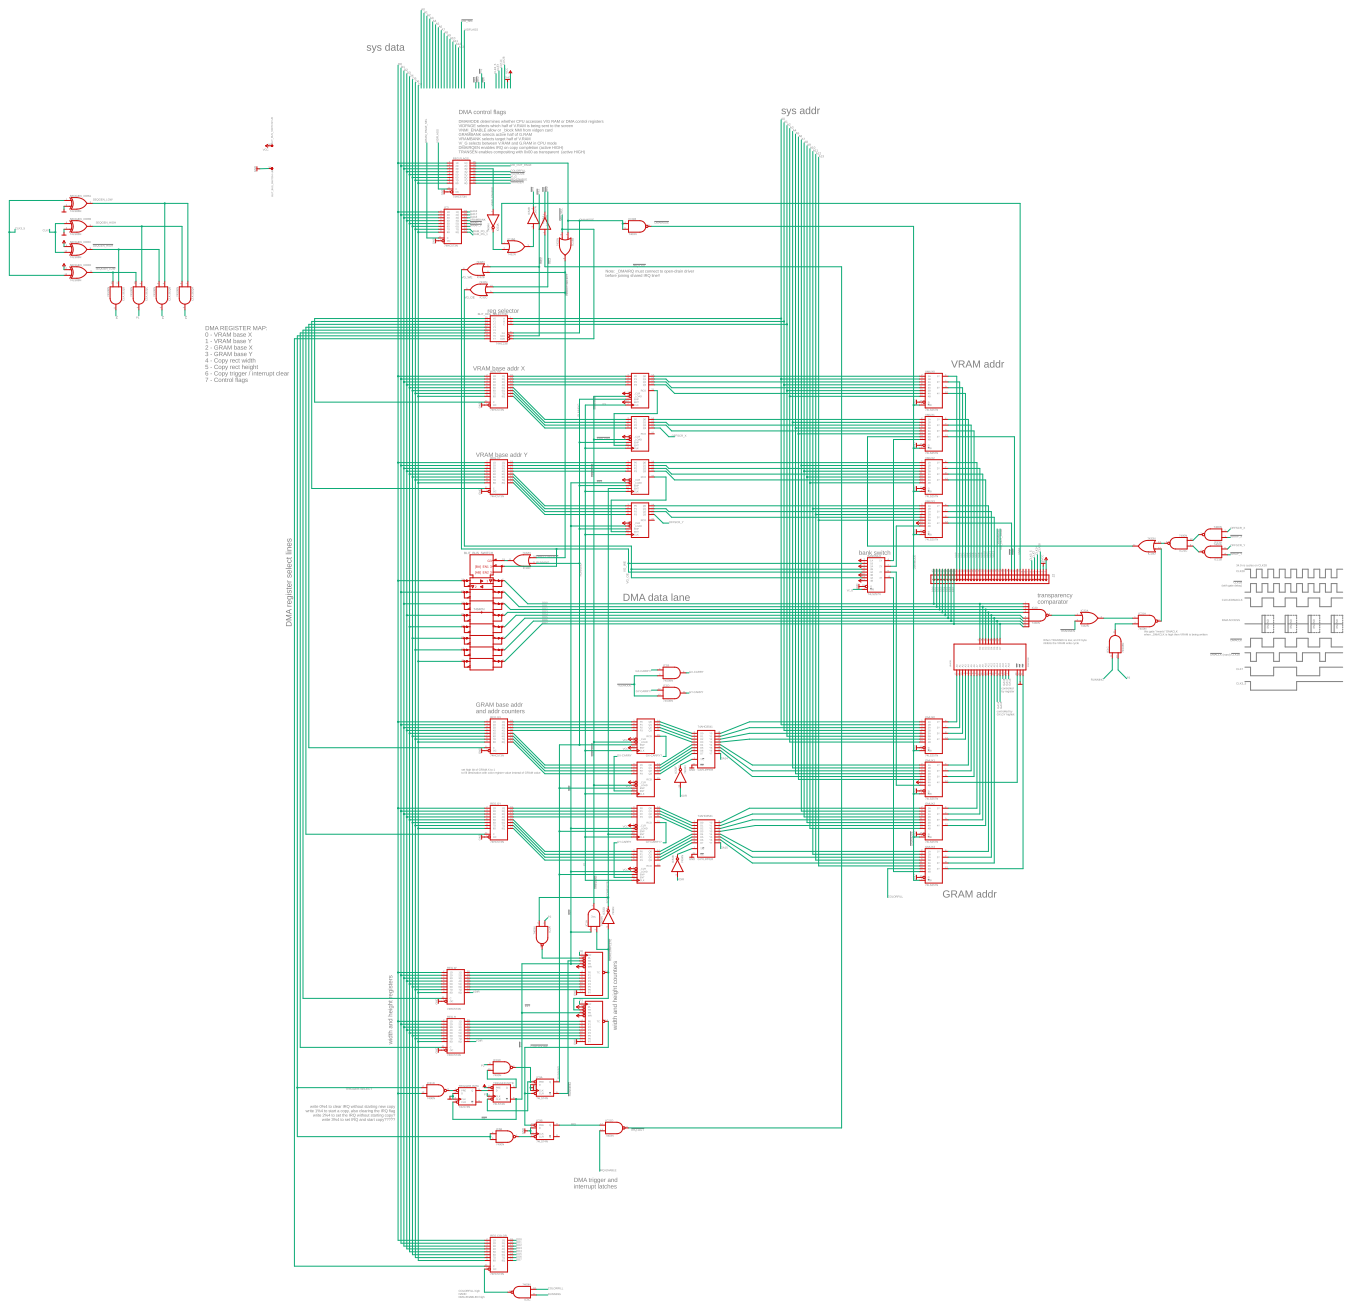
[picture p172: page 1]

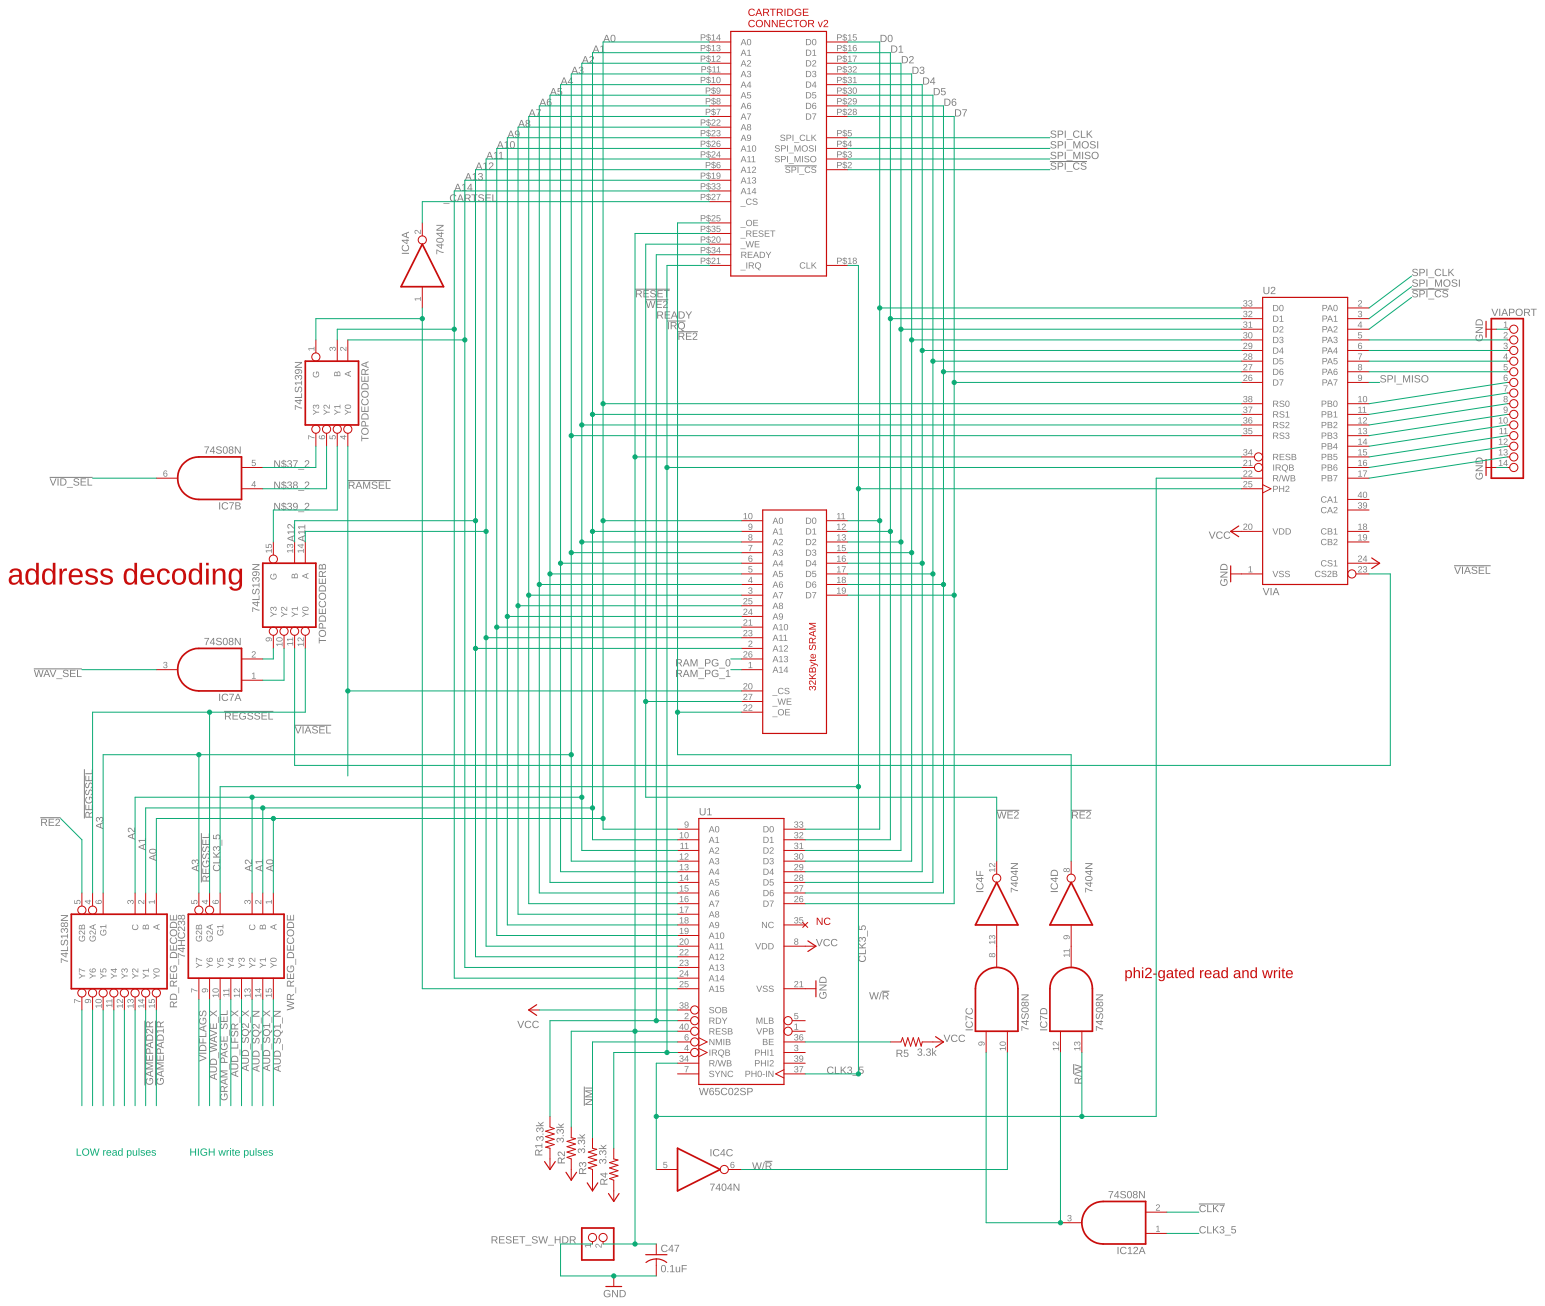
[picture p173: page 2]

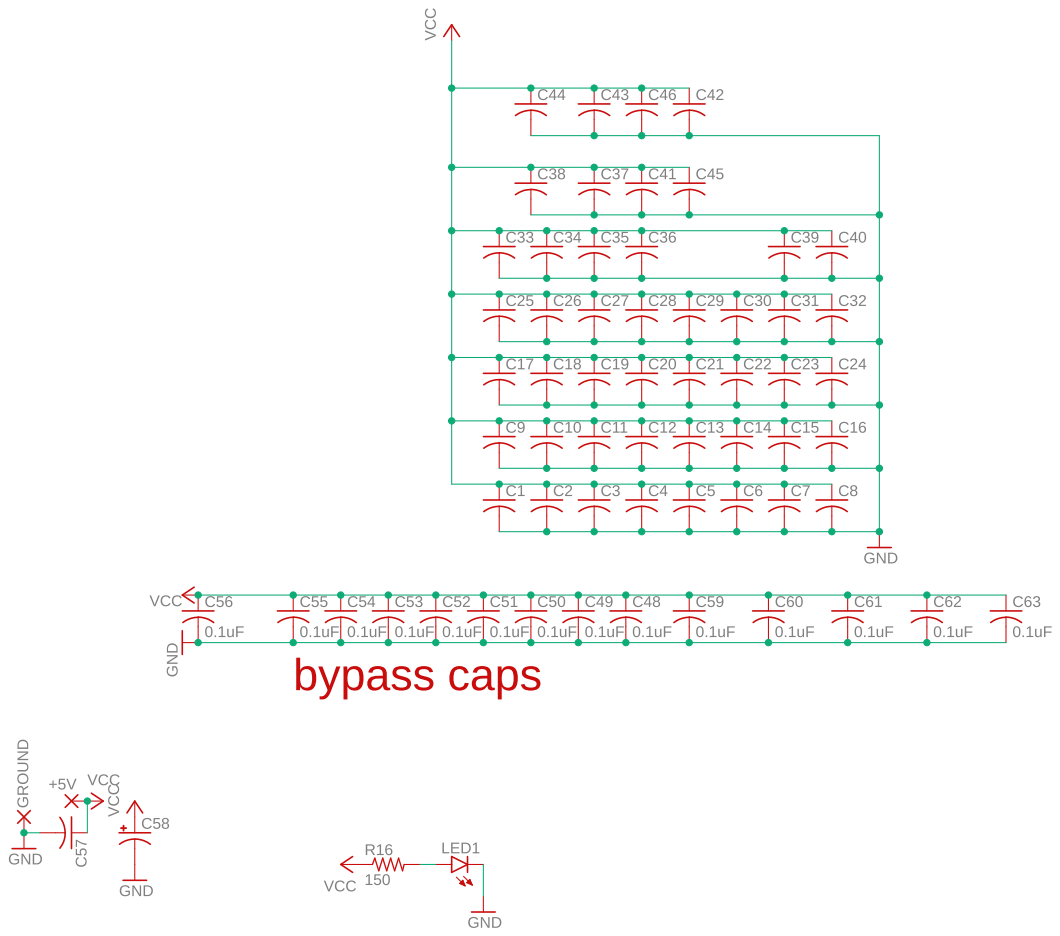
[picture p174: page 3]

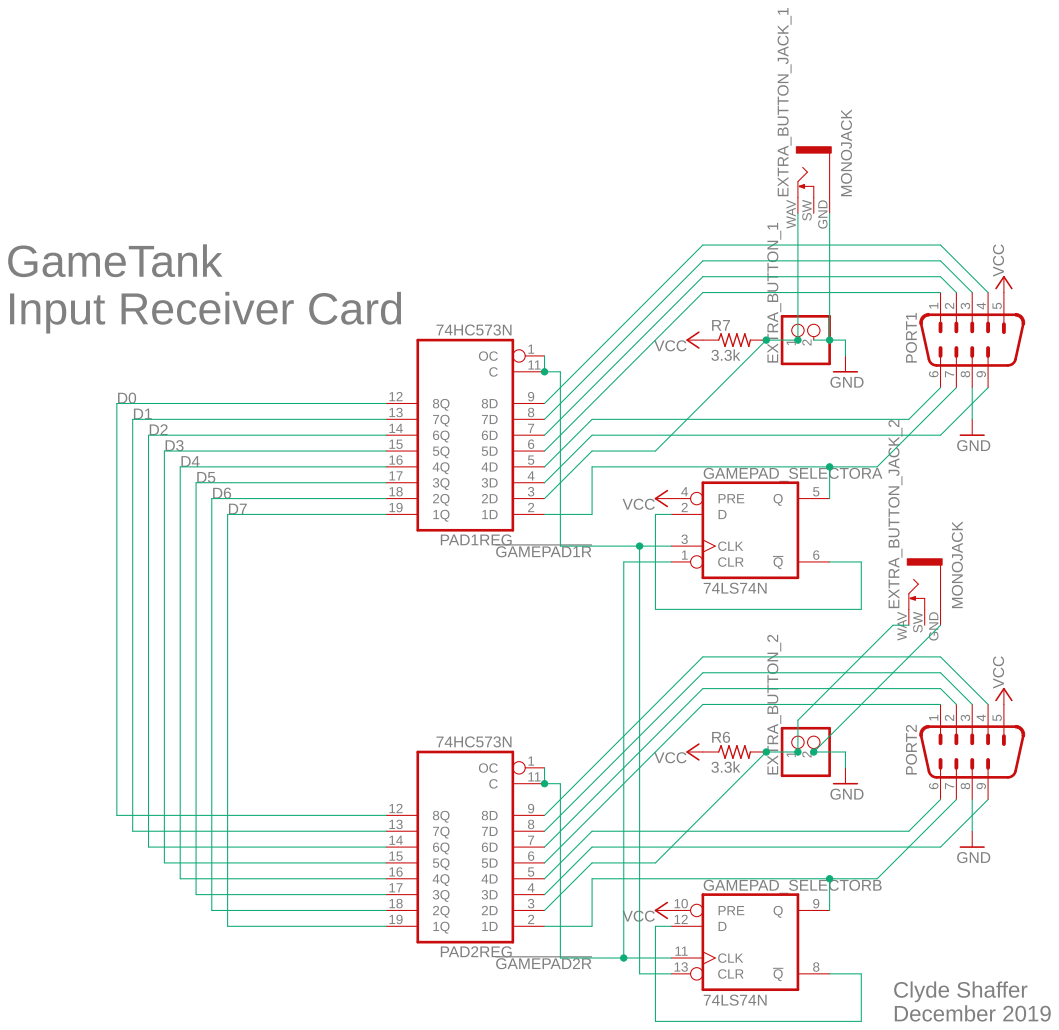
[picture p175: page 4]

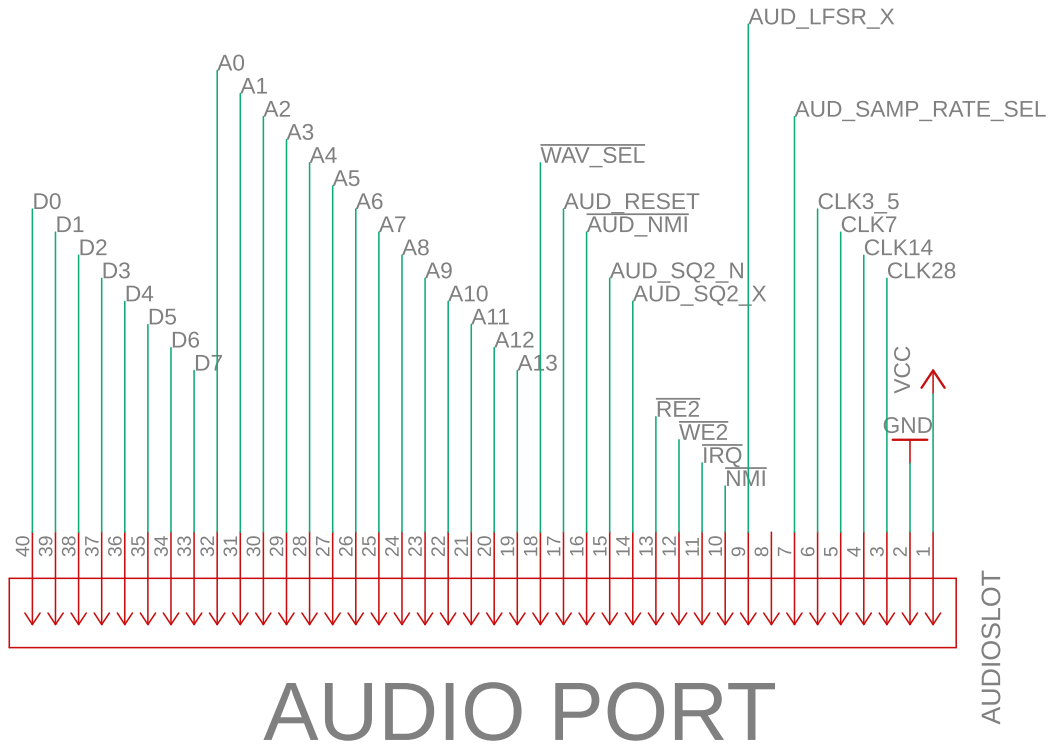
[picture p176: page 5]

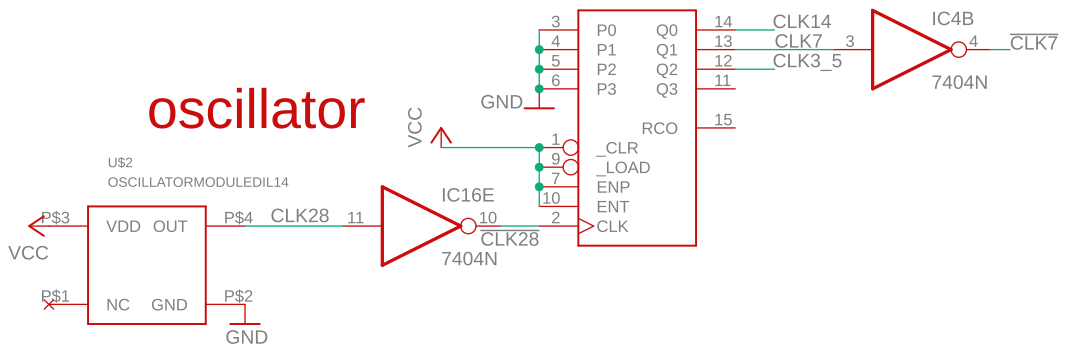
[picture p177: page 6]
