clydeshaffer/gametank/Docs/SchematicPDFs/EEPROM32card.pdf

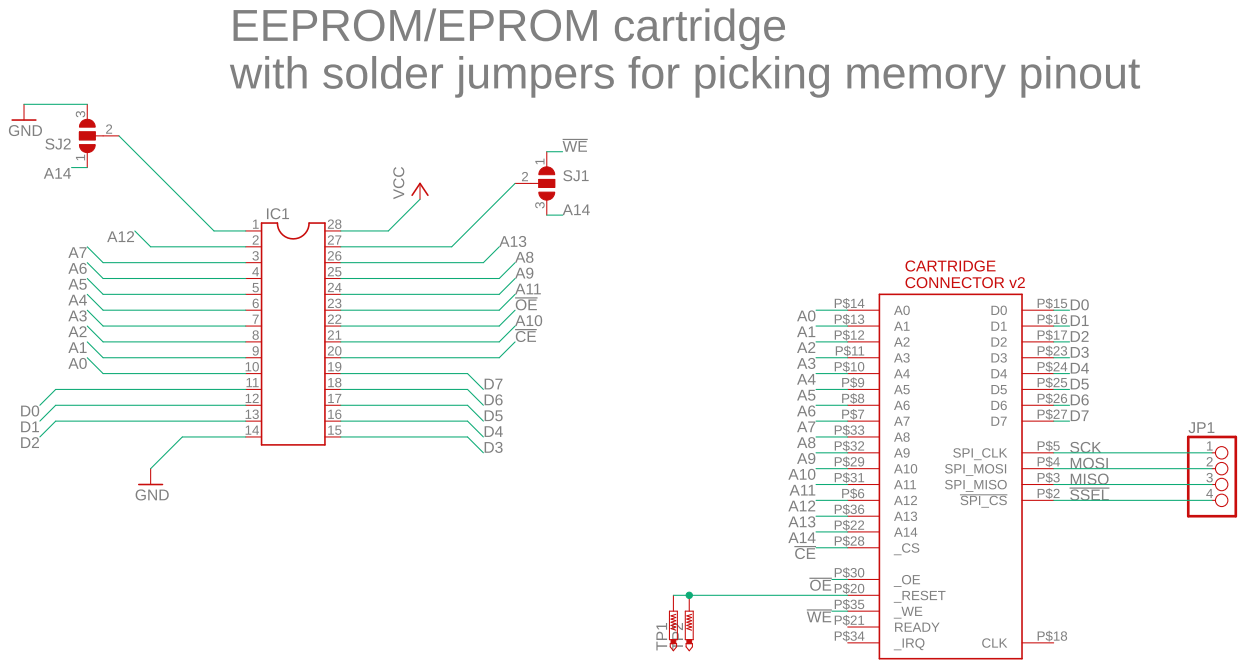
[picture p178: page 1]
