clydeshaffer/gametank/Docs/SchematicPDFs/FlashCardBanked2M.pdf

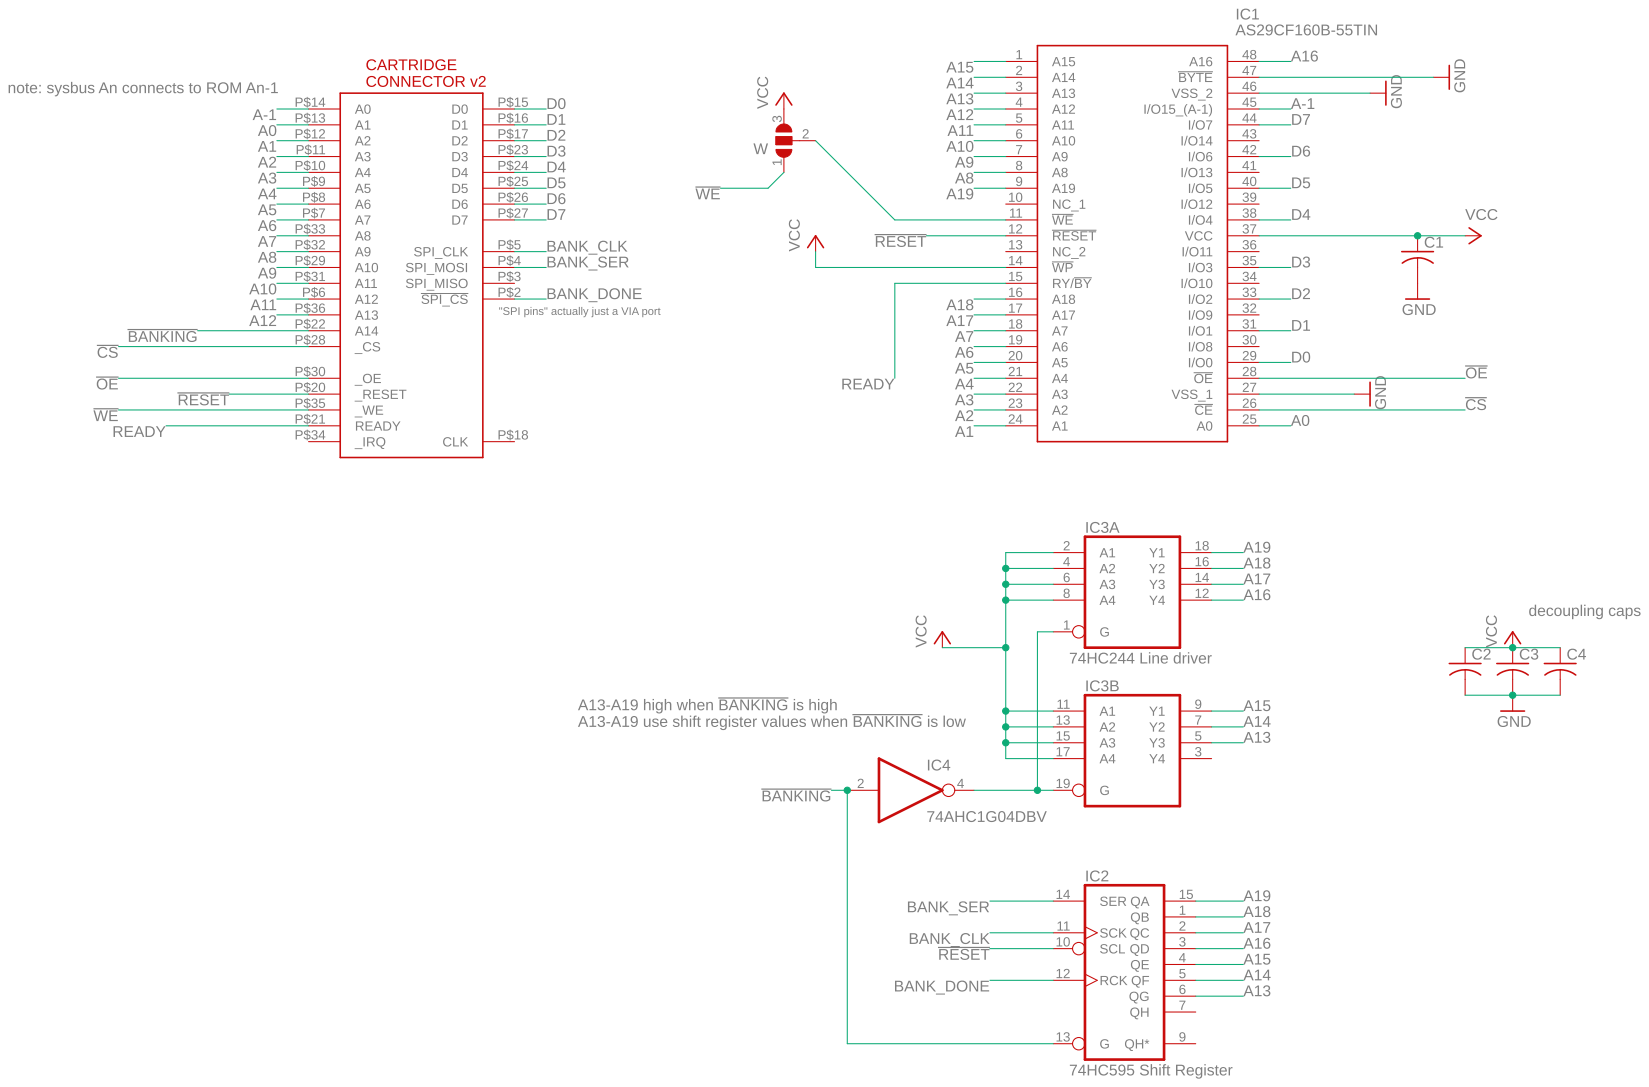
[picture p179: page 1]
