clydeshaffer/gametank/Docs/SchematicPDFs/gpad1.pdf

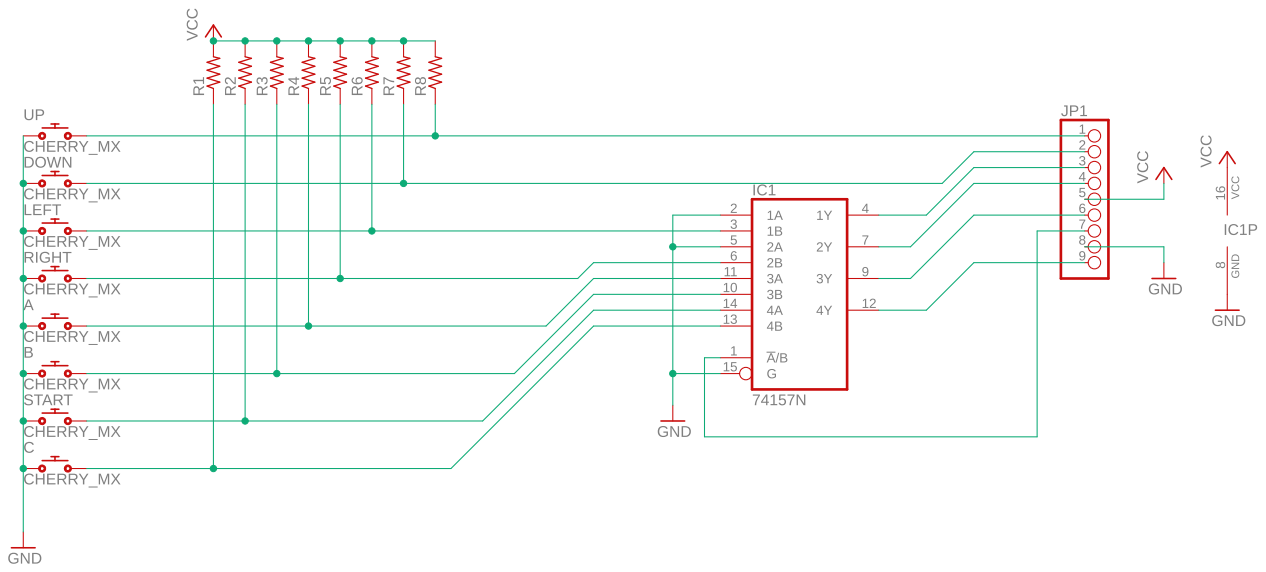
[picture p180: page 1]
