clydeshaffer/gametank/Docs/SchematicPDFs/MegaProgrammer.pdf

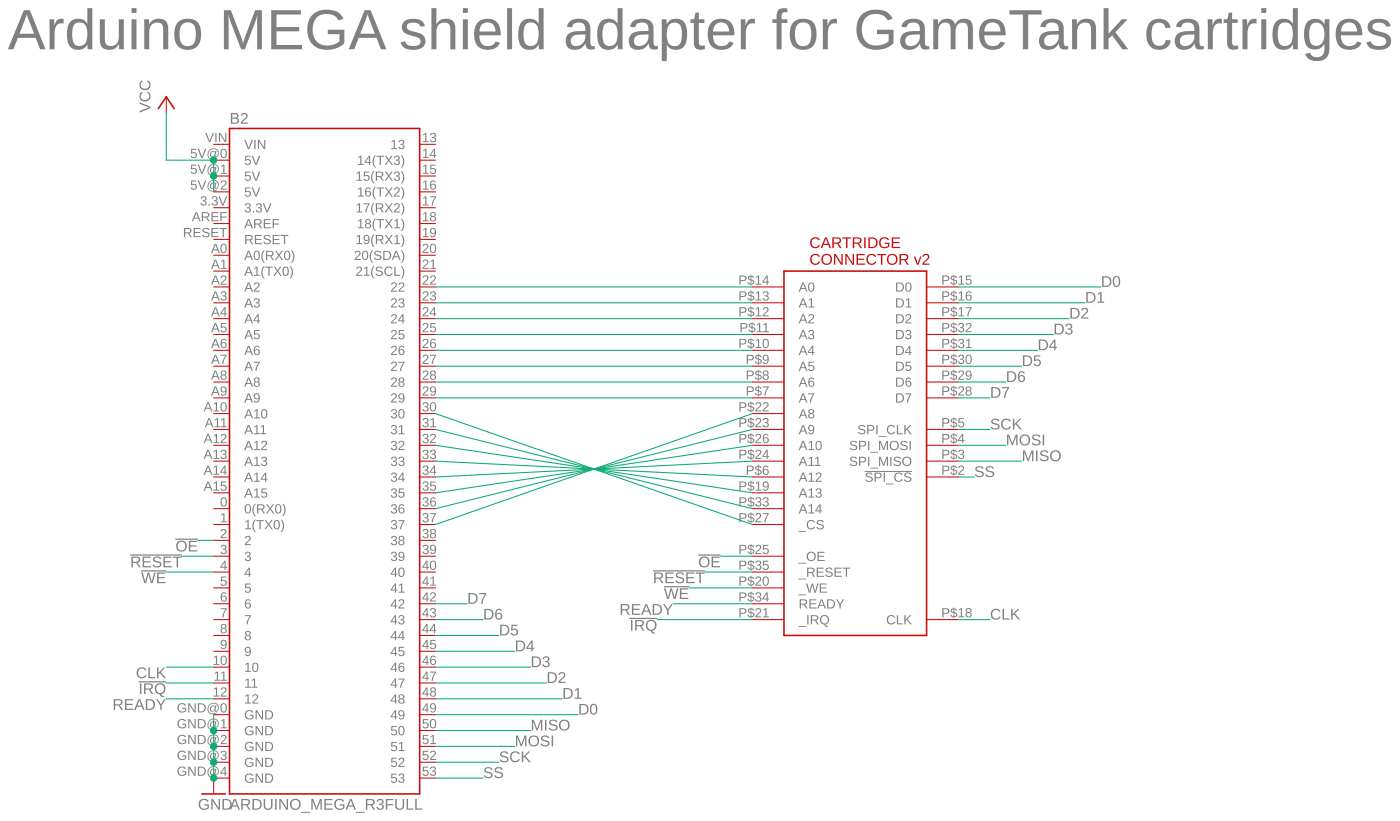
[picture p181: page 1]
