clydeshaffer/gametank/Docs/SchematicPDFs/powermodule-lm2575.pdf

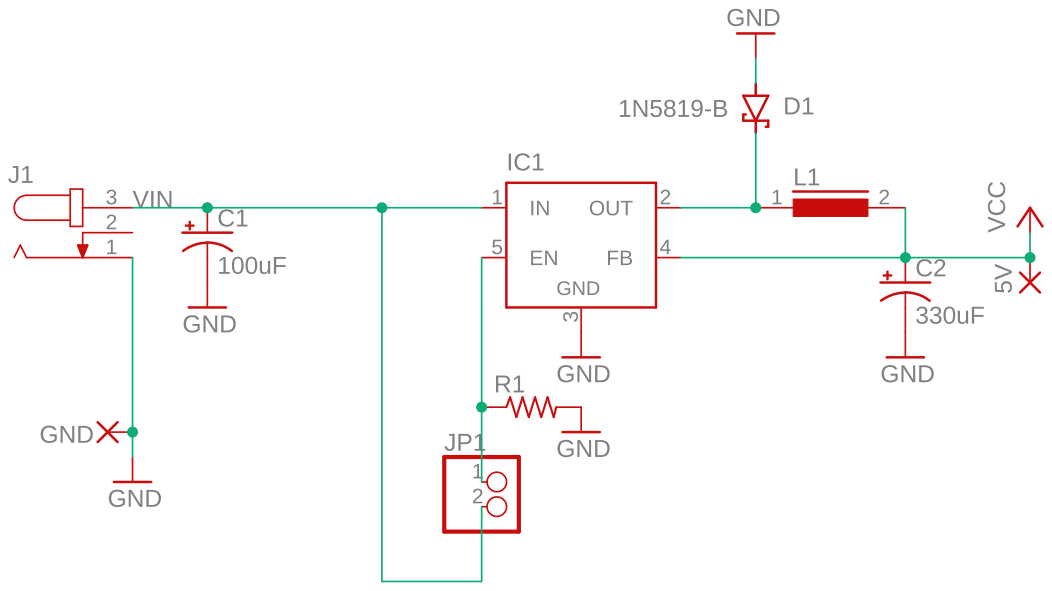
[picture p182: page 1]
