clydeshaffer/gametank/Docs/SchematicPDFs/signals.pdf

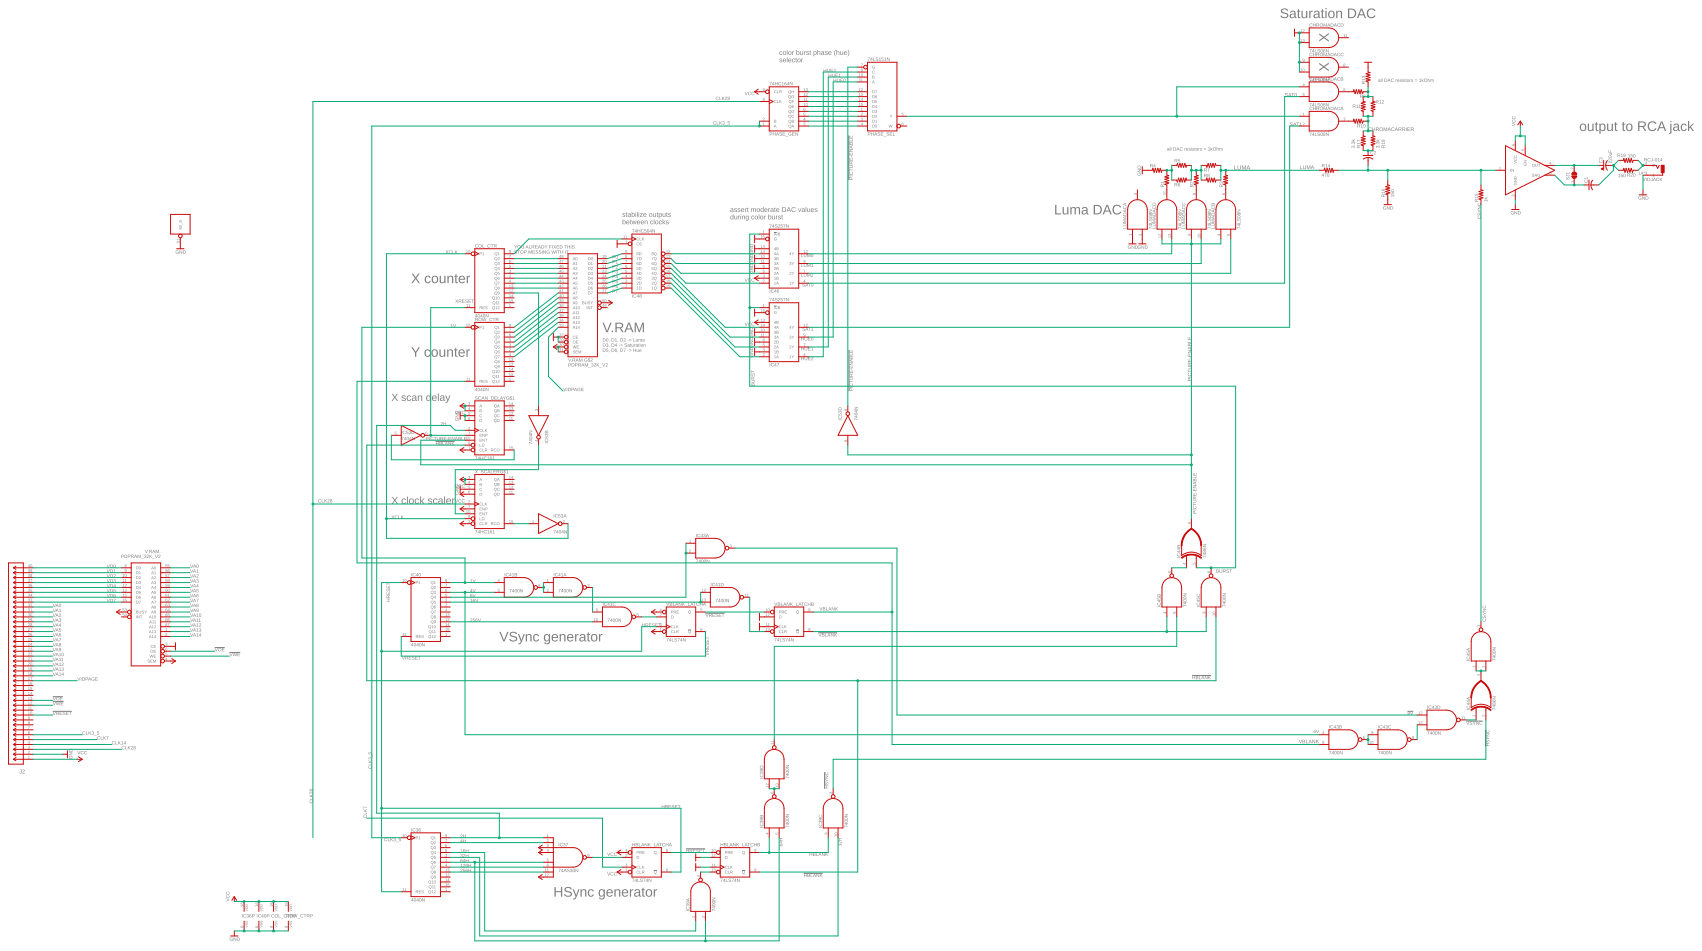
[picture p183: page 1]

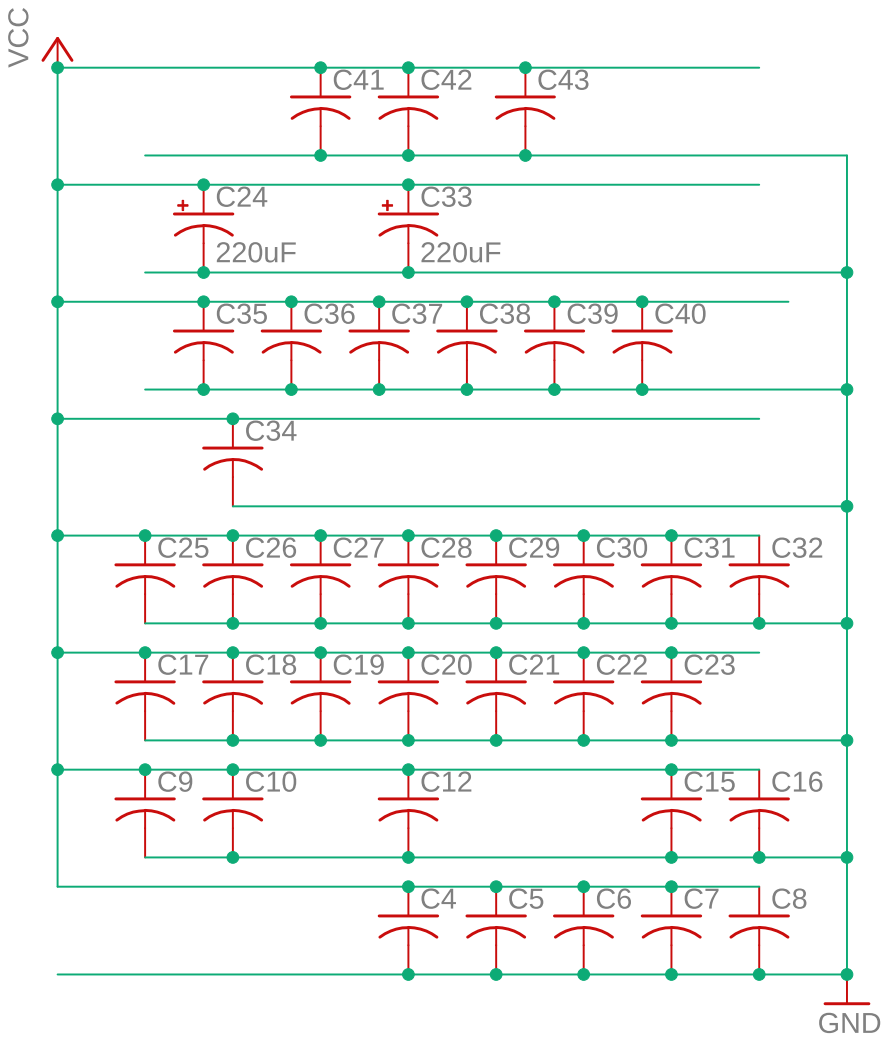
[picture p184: page 2]

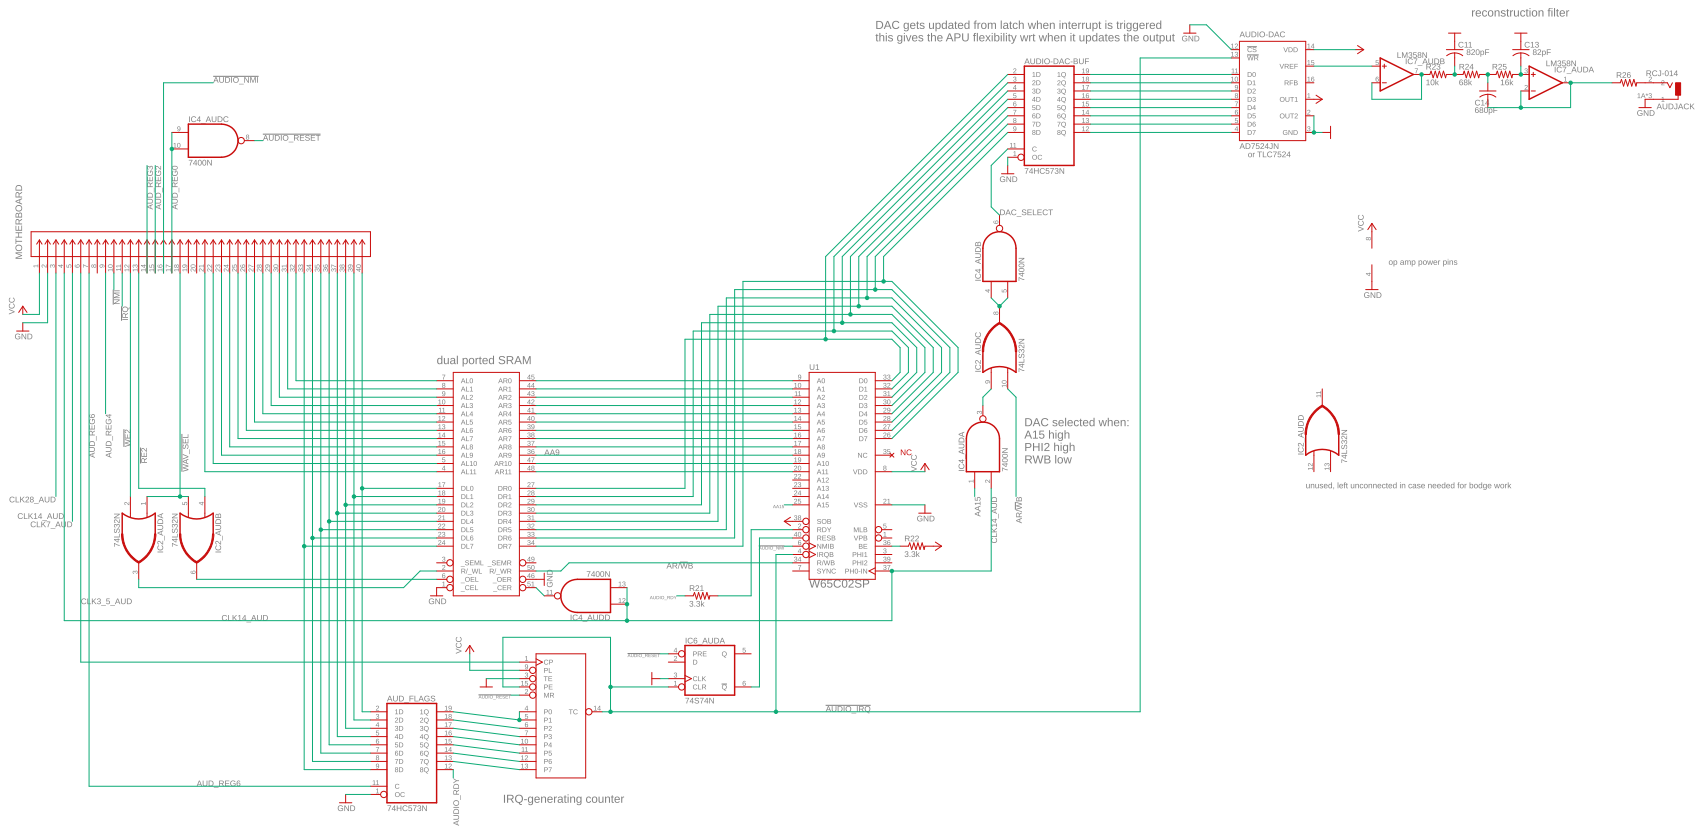
[picture p185: page 3]
