clydeshaffer/gametank/Hardware/KiCad/Cartridges/Flash2M/FlashCardBanked2M-assembly.pdf

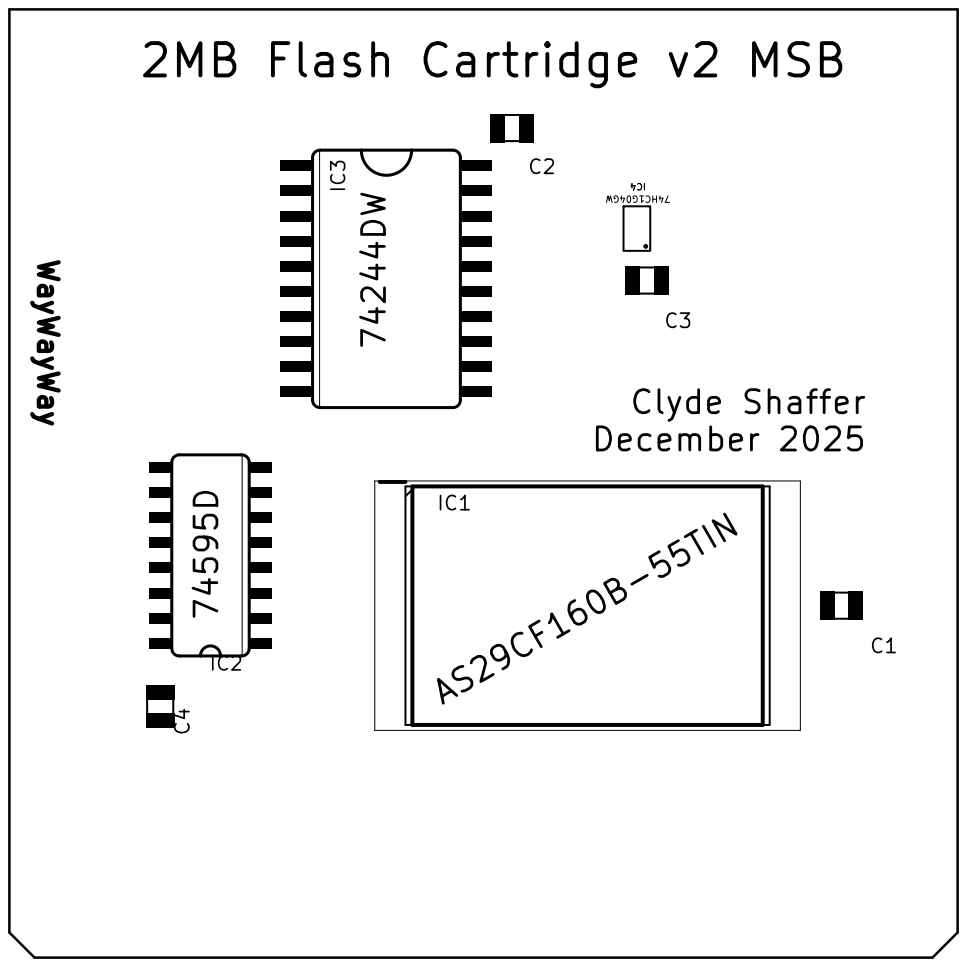
[picture p186: page 1]
