clydeshaffer/gametank/Hardware/KiCad/tools/cartflasher_2/flasher2/flasher2-assembly.pdf

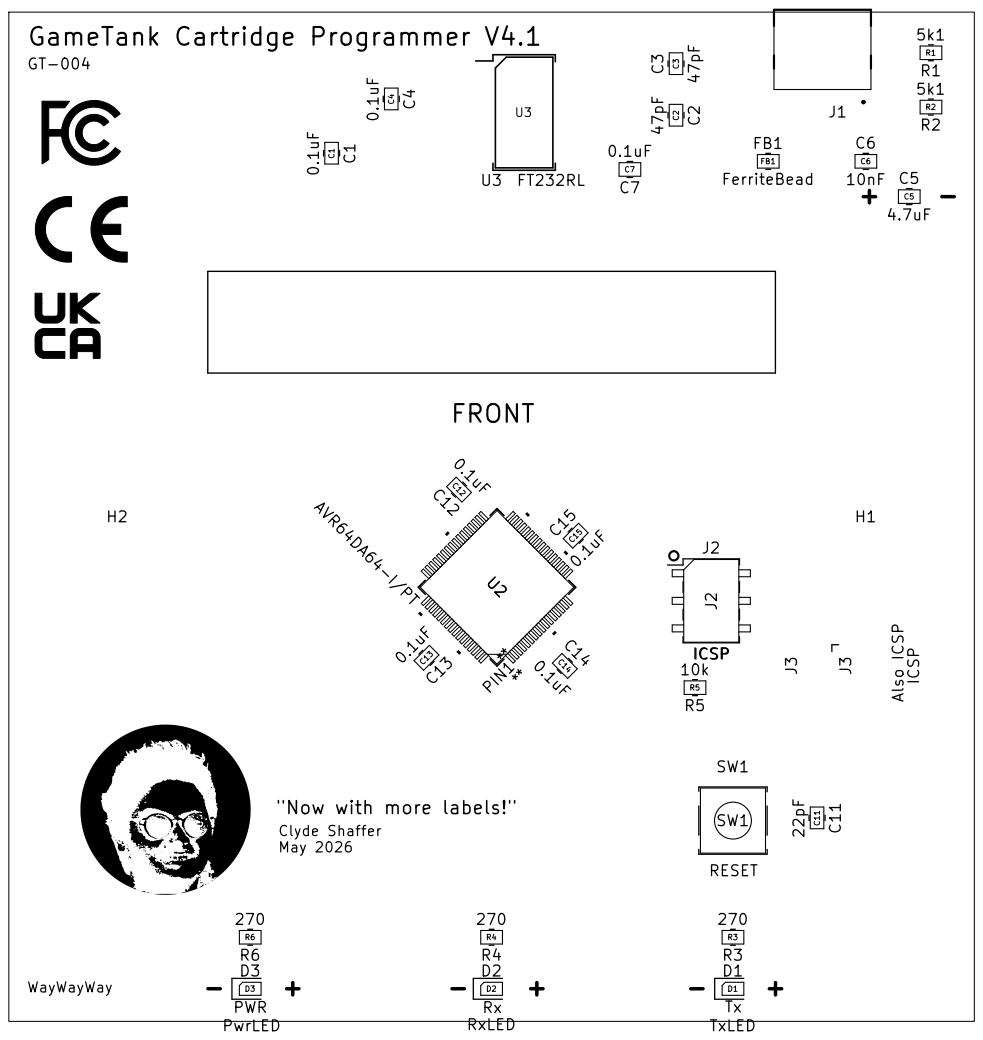
[picture p187: page 1]
