clydeshaffer/gametank/Docs/compute_board_layout_WIP.pdf

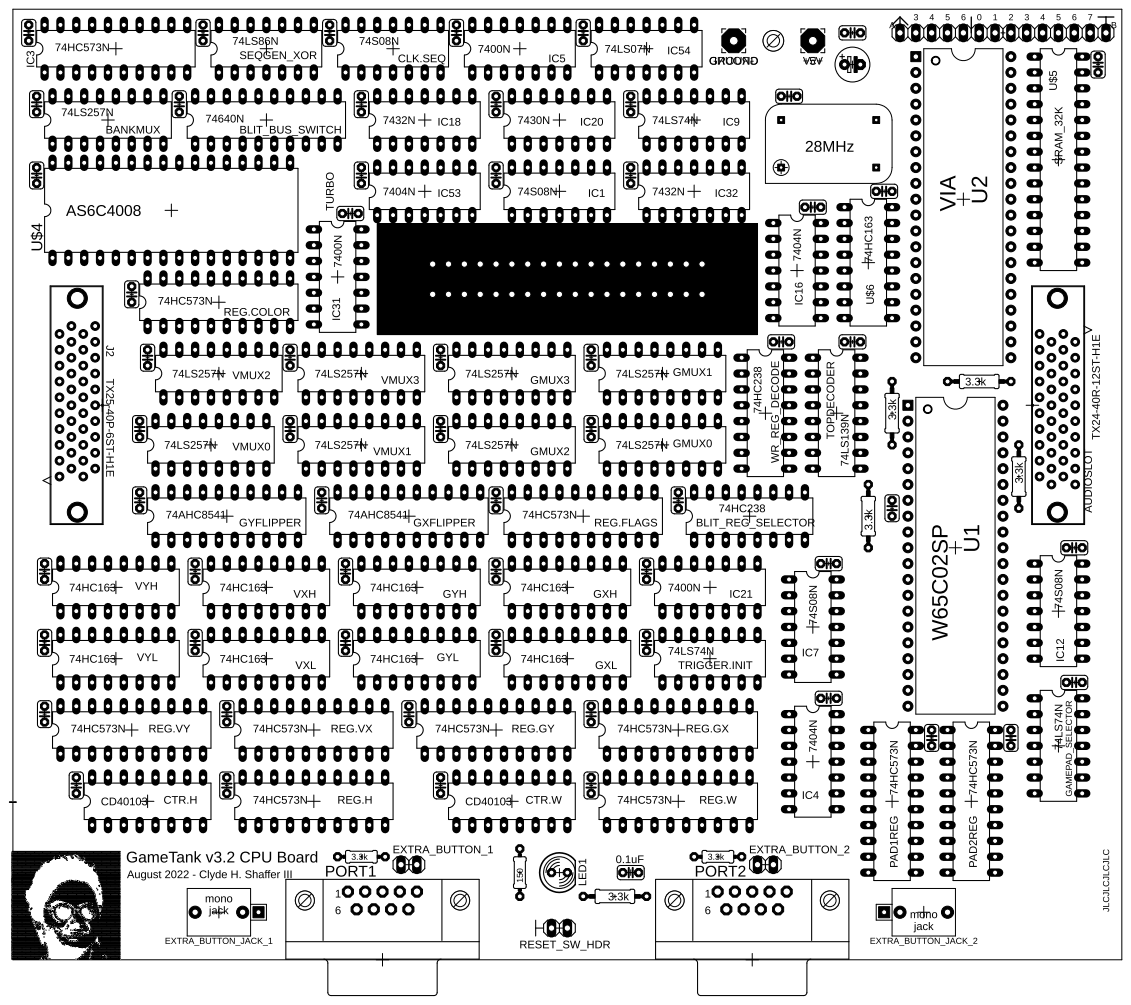
[picture p188: page 1]
