clydeshaffer/gametank/Docs/signals_board_layout_WIP.pdf

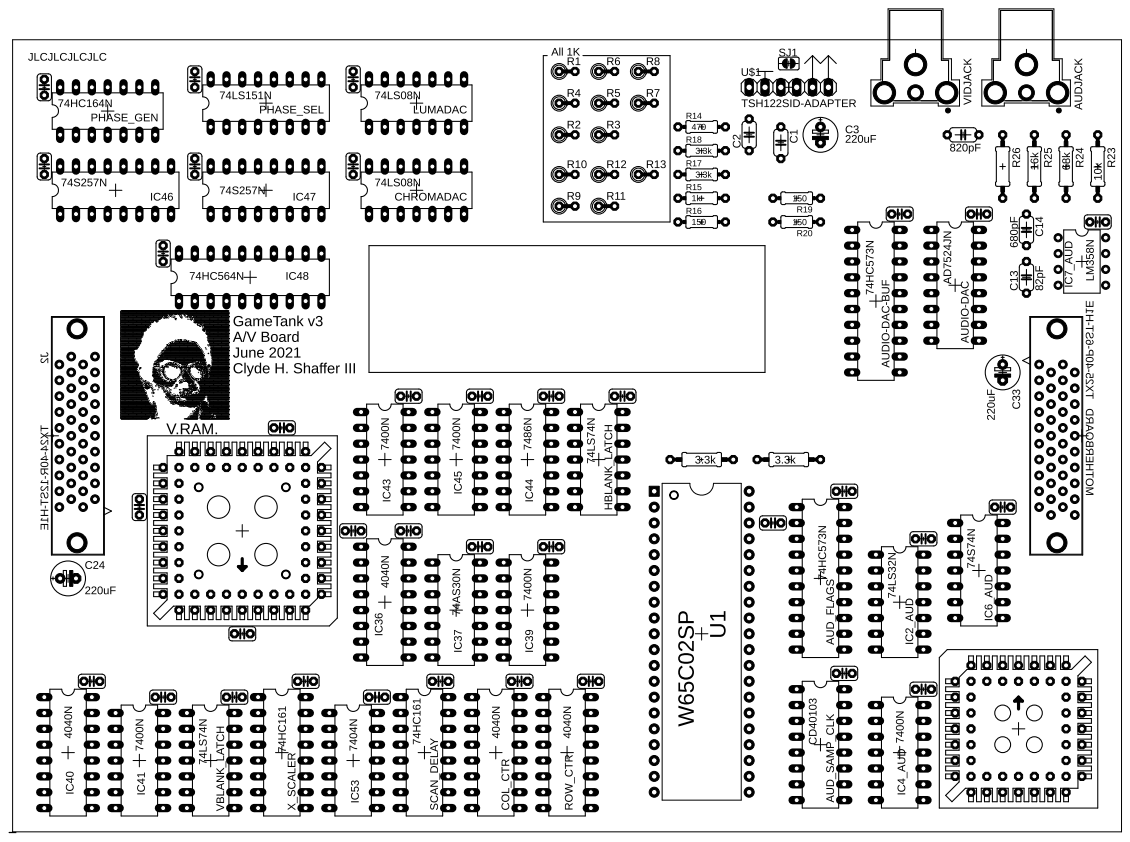
[picture p189: page 1]
