clydeshaffer/gametank/(list of files, drawings)

Other design files:
Hardware/KiCad/LogicBoard_smt/freerouting.dsn
Hardware/KiCad/LogicBoard_smt/LogicBoard_smt.dsn
