clydeshaffer/gametank/(commit log)

2020-12-24 update blitter
    [vdma_only_v2.brd, vdma_only_v2.sch]
2020-12-24 update libraries and add v2 soundcard
    [AudioCoproccessor.brd, AudioCoproccessor.sch]
2021-04-24 regrettably I don't remember what I changed since the last commit
    [AudioCoproccessor.sch, BasicRomCard8K.brd, BasicRomCard8K.sch, FlashCardBanked2M.brd, FlashCardBanked2M.sch, MegaProgrammer.brd, MegaProgrammer.sch, clock_buffer.brd]
2021-05-01 Blitter V6 w/ 4-phase clock
    [vdma_only_v2.brd, vdma_only_v2.sch]
2021-06-11 New Flash Cartridges
    [BasicRomCard8K.brd, BasicRomCard8K.sch, FlashCardBanked2M.brd, FlashCardBanked2M.sch, MegaProgrammer.brd, MegaProgrammer.sch]
2021-06-11 Blitter fixes
    [vdma_only_v2.brd, vdma_only_v2.sch]
2021-06-11 GameTank v3
    [cpu-blitter-inputs.brd, cpu-blitter-inputs.csv, cpu-blitter-inputs.sch, signals.brd, signals.csv, signals.sch]
2021-06-11 Move cartridge files into Tools
    [BasicRomCard8K.brd, BasicRomCard8K.sch, EEPROM32card.brd, EEPROM32card.sch, FlashCardBanked2M.brd, FlashCardBanked2M.sch, MegaProgrammer.brd, MegaProgrammer.sch]
2021-06-23 Switched power module
    [switched-lm2575.brd, switched-lm2575.sch]
2021-06-23 Add product lists for DigiKey and Mouser
    [GameTank-DigiKey.xlsx, GameTank-Mouser.xls]
2021-08-24 Updates to combined board inc. new blitter features
    [GRAM_Expander.brd, GRAM_Expander.sch, big-gram-test.brd, big-gram-test.sch, cpu-blitter-inputs.brd, cpu-blitter-inputs.sch, signals.brd, signals.sch]
2022-06-05 RTC flash and power supply update
    [Flash2M+RTC.brd, Flash2M+RTC.sch, Flash2M+RTC_centroid.csv, switched-lm2575.brd, switched-lm2575.sch]
2022-07-22 Add case models
    [gametank-case-bottom.stl, gametank-case-powercover.stl, gametank-case-powervent.stl, gametank-case-top.stl]
2022-07-22 Add experimental RTC cartridge
    [Flash2M+RTC.brd]
2022-07-22 Add cartridge shell models
    [cartridge-back.stl, cartridge-front.stl, romcard2 v13.step]
2022-08-02 Add schematics in image form
2022-08-04 Upload PDF schematics
    [EEPROM32card.sch, MegaProgrammer.sch]
2022-08-27 Replacement PCB for THS7374 module
    [THS7374-adapter.brd, THS7374-adapter.sch]
2022-08-30 add SMD oscillator to library and fix GRAM power connections
    [cpu-blitter-inputs.brd, cpu-blitter-inputs.sch, osc-smd-adapter.brd, osc-smd-adapter.sch]
2022-08-31 fix ACP control lines (in schematic)
    [cpu-blitter-inputs.brd, cpu-blitter-inputs.sch]
2022-09-03 Fix flipped SMD oscillator
    [osc-smd-adapter.brd, osc-smd-adapter.sch]
2022-09-03 Replace MUX for readregs with spare gates
    [cpu-blitter-inputs.brd, cpu-blitter-inputs.sch]
2022-09-29 Catridge adapter for Sanni reader and first draft of SRAM cartridge
    [FlashSRAMcard.brd, FlashSRAMcard.sch, sanni-adapter.brd, sanni-adapter.sch]
2022-10-09 reorg STLs and add controller model
    [button.stl, button_wide.stl, cartridge-back.stl, cartridge-front.stl, gametank-case-bottom.stl, gametank-case-powercover.stl, gametank-case-powervent.stl, gametank-case-top.stl]
2022-11-03 more sram cart changes
    [FlashSRAMcard.brd, FlashSRAMcard.sch]
2023-01-26 Reorganize Production (gerber zips) folder
2023-03-06 upload parts lists
    [digikey-kit.csv, digikey.csv, digikey2.csv, mouser-kit.xls, mouser.xls]
2023-03-06 RAM cartridge fixes
    [FlashSRAMcard.brd, FlashSRAMcard.sch]
2023-08-22 upload kicad conversions and smt versions
    [CPU_and_address_decode.kicad_sch, Composite_Video_Generator.kicad_sch, DMA_Controller.kicad_sch, Gamepad_ports.kicad_sch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]
2023-08-22 some SRAM cartridge stuff
    [FlashSRAMCartBOM.xlsx, FlashSRAMCartBOM_changed.xlsx, FlashSRAMcard.brd, FlashSRAMcard.sch, FlashSRAMcard_diodes.brd, FlashSRAMcard_diodes.sch, FlashSRAMcard_top_bom.csv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]
2023-08-22 convert Power module to KiCad
    [Power_smt.kicad_pcb, Power_smt.kicad_sch, switched-lm2575.kicad_pcb, switched-lm2575.kicad_sch]
2023-08-23 power board kicad smt
    [Power_smt.kicad_pcb, Power_smt.kicad_sch]
2023-08-23 update kicad SMT BOMs
    [Composite_Video_Generator.kicad_sch, signals_4.kicad_sch]
2023-11-28 SMT edits and start of fake dual ram sketching
    [Power_smt.kicad_pcb, Power_smt.kicad_sch, avboard_smt.kicad_pcb, fake_dual_ram.kicad_pcb, fake_dual_ram.kicad_sch]
2024-01-04 updates to kicad smt versions
    [CPU_and_address_decode.kicad_sch, DMA_Controller.kicad_sch, FlashCardBanked2M.kicad_pcb, FlashCardBanked2M.kicad_sch, Power_smt.kicad_pcb, Power_smt.kicad_sch, avboard_smt.kicad_pcb, cpu-blitter-inputs_3.kicad_sch]
2024-08-06 manual and models and misc hardware file updates
    [CPU_and_address_decode.kicad_sch, LogicBoard_smt.kicad_sch, badge2.stl, bottom-tray.stl, bushing_outlines.dxf, bushing_outlines_raw.dxf, button-jig-bottom.stl, button-jig-top.stl]
2024-08-20 Add new flasher v3
    [MegaProgrammer.kicad_pcb, MegaProgrammer.kicad_sch]
2024-08-20 update graphics on flasher v3
    [MegaProgrammer.kicad_pcb]
2024-08-20 fix unconnected nets in flasher3
    [MegaProgrammer.kicad_pcb]
2024-08-28 add footprint for reset controller on logic board and remove READY on cartridges
    [CPU_and_address_decode.kicad_sch, FlashCardBanked2M.kicad_pcb, FlashCardBanked2M.kicad_sch, gpad1.kicad_pcb, gpad1.kicad_sch, power.kicad_sch]
2024-08-29 megaprogrammer edit
    [MegaProgrammer.kicad_sch]
2024-09-06 controller cad files and new cart flasher
    [MegaProgrammer.kicad_sch, bottom body.stl, button flexure.stl, flasher2.kicad_pcb, flasher2.kicad_sch, gpad1.step, gpad3smt.step, labels.stl]
2024-09-07 flasher2 sent for prototype production
    [flasher2.kicad_pcb, flasher2.kicad_sch]
2024-09-13 fix for smt controller
    [gpad1.kicad_pcb, gpad1.kicad_sch]
2025-10-03 collect production documents for quoting
    [CPU_and_address_decode.kicad_sch, Composite_Video_Generator.kicad_sch, DMA_Controller.kicad_sch, FlashCardBanked2M.kicad_pcb, FlashCardBanked2M.kicad_sch, FlashCardBanked2M.step, Gamepad_ports.kicad_sch, LogicBoard_smt.kicad_sch]
2025-10-15 replace dual ported frame buffer with mirrored single ported rams
    [Composite_Video_Generator.kicad_sch, DMA_Controller.kicad_sch, avboard_smt.kicad_pcb, signals_4.kicad_sch]
2025-10-15 design out the 4K dualport ram
    [Composite_Video_Generator.kicad_sch, Power_connections_and_decoupling_caps.kicad_sch, avboard_smt.kicad_pcb, signals_4.kicad_sch]
2025-10-15 connect loose unused inputs to ground
    [Composite_Video_Generator.kicad_sch, avboard_smt.kicad_pcb, signals_4.kicad_sch]
2025-11-24 fix composite video generator board
    [Composite_Video_Generator.kicad_sch, avboard_smt.kicad_pcb]
2025-12-01 Add quote files for molding
    [badge.step, bottom-shell.step, buttons.step, center-support.step, combined_BOMs.xls, controller-body.step, controller-face.step, controller-spacer.step]
2025-12-01 Add AV board version with VRAM replaced but not ARAM
    [Composite_Video_Generator.kicad_sch, Power_connections_and_decoupling_caps.kicad_sch, avboard_smt.kicad_pcb, signals_4.kicad_sch]
2026-02-22 add draft of 2M cart with center hole
    [FlashCardBanked2M.kicad_pcb, FlashCardBanked2M.kicad_sch, FlashCardBanked2M.step, FlashCardBanked2M_hole.step]
2026-03-05 more random updates
    [FlashCardBanked2M-B_Cu.gbr, FlashCardBanked2M-B_Mask.gbr, FlashCardBanked2M-B_Paste.gbr, FlashCardBanked2M-B_SilkS.gbr, FlashCardBanked2M-Edge_Cuts.gbr, FlashCardBanked2M-F_Cu.gbr, FlashCardBanked2M-F_Mask.gbr, FlashCardBanked2M-F_Paste.gbr]
2026-03-06 mailer box cutout doc
    [AudioCoproccessor.brd, AudioCoproccessor.sch, BasicRomCard8K.brd, BasicRomCard8K.sch, CPU_and_address_decode.kicad_sch, Composite_Video_Generator.kicad_sch, DMA_Controller.kicad_sch, EEPROM32card.brd]
2026-06-20 lots of emc tweaking, not done yet
    [CPU_and_address_decode.kicad_sch, Composite_Video_Generator.kicad_sch, DMA_Controller.kicad_sch, FlashCardBanked2M.kicad_pcb, Gamepad_ports.kicad_sch, LogicBoard_smt.kicad_pcb, Power_connections_and_decoupling_caps.kicad_sch, avboard_shield.kicad_pcb]
2026-06-29 EMC updates part ?/?
    [CPU_and_address_decode.kicad_sch, Composite_Video_Generator.kicad_sch, DMA_Controller.kicad_sch, Gamepad_ports.kicad_sch, LogicBoard_smt.kicad_pcb, LogicBoard_smt.kicad_sch, Power_connections_and_decoupling_caps.kicad_sch, avboard_smt.kicad_pcb]
2026-07-06 update quote docs, BOM, motherboard power section
    [Composite_Video_Generator.kicad_sch, DMA_Controller.kicad_sch, Gamepad_ports.kicad_sch, LogicBoard_smt.kicad_pcb, avboard_smt.kicad_pcb, cpu-blitter-inputs_6.kicad_sch, flasher-base.stl, gametank-cartridge-back.stl]
2026-07-06 unLFS the repo
    [AudioCoproccessor.brd, AudioCoproccessor.sch, BasicRomCard8K.brd, BasicRomCard8K.sch, CPU_and_address_decode.kicad_sch, Composite_Video_Generator.kicad_sch, DMA_Controller.kicad_sch, EEPROM32card.brd]
2026-07-09 add unfinished draft of ps/2 controller
    [power.kicad_sch, ps2mkb.kicad_pcb, ps2mkb.kicad_sch]
2026-07-10 update label on part in ps/2 adapter
    [power.kicad_sch, ps2mkb.kicad_sch]
2026-07-11 WIP v2 THT AVboard
    [Composite_Video_Generator.kicad_sch, Power_connections_and_decoupling_caps.kicad_sch, avboard_tht2.kicad_pcb, avboard_tht2.kicad_sch, signals.kicad_sch, signals_1.kicad_sch, signals_4.kicad_sch]
2026-07-14 new through hole motherboard version
    [CPU_and_address_decode.kicad_sch, DMA_Controller.kicad_sch, Gamepad_ports.kicad_sch, LogicBoard_tht2.kicad_sch, cpu-blitter-inputs_3.kicad_sch, cpu-blitter-inputs_5.kicad_sch, cpu-blitter-inputs_6.kicad_sch, power_units.kicad_sch]
2026-08-10 mouse keyboard adapter v1
    [power.kicad_sch, ps2mkb.kicad_pcb, ps2mkb.kicad_sch]
2026-08-13 via irq fix
    [CPU_and_address_decode.kicad_sch, DMA_Controller.kicad_sch, Gamepad_ports.kicad_sch, LogicBoard_smt.kicad_pcb, cpu-blitter-inputs_6.kicad_sch, power.kicad_sch]
2026-08-13 update quote package v6
    [gametank-console-board-spacer.stl, gametank-controller-body.stl, gametank-controller-faceplate.stl, gametank-controller-pivot.stl, gametank-enclosure-badge.stl, gametank-enclosure-bottom.stl, gametank-enclosure-top.stl]
2026-08-13 separate folder for alternate power converter on gtsmt
    [CPU_and_address_decode.kicad_sch, DMA_Controller.kicad_sch, Gamepad_ports.kicad_sch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]
2026-08-14 backplane and updated mouse keyboard adapter
    [exbus_backplane.kicad_pcb, exbus_backplane.kicad_sch, exbus_backplane.step, power.kicad_sch, ps2mkb.kicad_pcb, ps2mkb.kicad_sch, ps2mkb.step]
2026-09-28 fewer vias, simpler routing
    [avboard_tht2.kicad_pcb]
2026-09-28 oops, forgot to add signals_4
    [signals_4.kicad_sch]
2026-09-29 catchup commit for quote pkg stuff
    [Gamepad_ports.kicad_sch, LogicBoard_smt.kicad_pcb, LogicBoard_tht2.kicad_pcb, avboard_smt.kicad_pcb, avboard_tht2.kicad_pcb, backplane_baseplate.stl, exp_port_mod_board.kicad_pcb, exp_port_mod_board.kicad_sch]
2026-10-02 fewer vias
    [avboard_tht2.kicad_pcb]
2026-10-13 add assembly drawings for flasher and cartridge
